touhidsiddiqueeraj-bit/artemis-helios/README.md

# Helios-Artemis

A photovoltaic (PV) system research project implementing a dual-microcontroller predictive Maximum Power Point Tracking (MPPT) controller
for solar energy optimization.

## Overview

This project presents the Helios-Artemis system, which partitions the MPPT problem into two planes:
- **Helios (ESP32-S3):** LSTM irradiance forecasting, local retraining, SD logging
- **Artemis (STM32F103):** real-time VS-P&O MPPT, 50 kHz PWM generation, battery management

Validated by a field logger deployed in Sylhet, Bangladesh, with the full study written up as an IJPEDS revision 
(manuscript `25195-52952-1-SM-REVISED`).

## Manuscript deliverables (current)

| File | Description |
|---|---|
| `25195-52952-1-SM-REVISED.docx` | Current revision, submitted to IJPEDS (reviewer items addressed) |
| `25195-52952-1-SM-REVISED.pdf` | PDF export of the current revision |
| `response_letter.md` | Point-by-point response to the reviewer report |
| `backups/` | Superseded revisions (BAK3–BAK12), earlier revision scripts, original submission |

## Project Structure

```
artemis-helios/
├── Code/
│   ├── MatLab/                     # MATLAB simulation & analysis scripts (Simulink model, controllers)
│   ├── Python/                     # Python scripts
│   │   ├── gen_figures_hires.py    # Regenerates all 9 publication figures (fig1()–fig9())
│   │   ├── graphical_abstract.py
│   │   ├── figures/                # Generated high-resolution figures
│   │   └── documentation/
│   └── ...
├── Docs/
│   ├── Presentation/               # Project presentations
│   ├── Study_materials/            # Study guides & primers
│   └── Upload_package/             # IJPEDS submission package (manuscript, cover letter, reviewers)
├── Figures/
│   └── figures_python/             # Per-figure scripts (FIG1–FIG9) & outputs
├── Tables/                         # CSV data tables
├── Logger_Data/                    # Field logger recordings & cleaned validation data
├── Helios_Logger/                  # Logger firmware
├── prototype/
│   ├── Code/                       # Firmware (STM32 & ESP32-S3)
│   ├── Guide/                      # Schematics, PCB, layout guide
│   └── schematics/                 # KiCad design files
├── backups/                        # Superseded revisions & scripts (working files stay at root)
└── README.md
```

## Figures

Generated by `Code/Python/gen_figures_hires.py`:

1. **fig1_architecture** - System architecture (dual-MCU: Helios + Artemis)
2. **fig2_irradiance** - Sylhet Markov-chain + OU irradiance model
3. **fig3_iv_curves** - PV I–V / P–V characteristics
4. **fig4_lstm** - LSTM predictor performance (R², MAE, residuals, α sensitivity)
5. **fig5_simulation** - Full-day Simulink simulation (6 panels)
6. **fig6_comparison** - Controller efficiency comparison + Monte Carlo
7. **fig7_po_convergence** - VS-P&O convergence analysis
8. **fig8_cost** - BOM breakdown and cost comparison (manuscript Fig. 10)
9. **fig9_validation** - Field-logger ramp-rate validation

Plus `graphical_abstract.py` for the graphical abstract. The manuscript embeds these as 11 figures (including the GitHub-repo QR code).

## Requirements

- Python 3.x
- NumPy, Matplotlib, SciPy (`requirements.txt`)

## Running

Generate all figures:
```bash
python3 Code/Python/gen_figures_hires.py
```

## Authors

- **Hussain Touhid Siddiquee** — conceptualization, methodology, software, writing
- **Orpon Chanda** — hardware validation and field deployment

Department of Electrical & Electronic Engineering, Leading University, Sylhet, Bangladesh

## License

MIT License
