touhidsiddiqueeraj-bit/artemis-helios/PASTE_PLAN.md

> [!note]
> [!note]1,C and E are empty, text size in figure 1 is too small, the references are not serialized and are random, figure 10 has a headline of fig8 embedded in the image, and the text itseld is too small to be readable, it also doesnt include the assembly fee,author biography section is empty, remove. Orpon Chanda received the B.Sc. degree in Electrical and
Electronic Engineering from Shahjalal University of Science
and Technology (SUST), Sylhet, Bangladesh. His research
interests include solar energy systems, data acquisition and
logging for photovoltaic field deployment, and sensor
integration for renewable energy monitoring. He contributed
to the field data collection campaign and hardware
deployment of the irradiance logger used in this study.
Hussain Touhid Siddiquee received the B.Sc. degree in
Electrical and Electronic Engineering from Shahjalal
University of Science and Technology (SUST), Sylhet,
Bangladesh. His research interests include embedded systems
for renewable energy, machine learning on edge devices, and
predictive MPPT control for photovoltaic systems. He is the
lead developer of the Helios-Artemis dual-MCU predictive
MPPT controller and the ARTEMIS LSTM irradiance
simulation framework.  this section is completely fabricated, remove, The authors thank the Infrastructure Development Company
Limited (IDCOL) for providing contextual data on SHS
deployment specifications. The field data collection campaign
was conducted with logistical support from the Department of
Electrical and Electronic Engineering, Shahjalal University of
Science and Technology, Sylhet. thisline is wrong, support was provided by leading university sylhet, not SUST, add 250 taka assembly charge to the total cost of the device, the paper has inconcsistent use of fonts and font sizs, follow ijpeds style formatting, Author Contributions Statement
Conceptualisation, H.T.S. and O.C.; methodology, H.T.S. and
O.C.; software, H.T.S.; validation, H.T.S. and O.C.; formal
analysis, H.T.S.; investigation, H.T.S. and O.C.; resources,
H.T.S.; data curation, O.C.; writing—original draft
preparation, H.T.S.; writing—review and editing, H.T.S. and
O.C.; supervision, H.T.S.; project administration, H.T.S  this section is wrong, credit OC for hardware deployment, credit HTS for everything else
