touhidsiddiqueeraj-bit/artemis-helios/Docs/Presentation/Helios_Artemis_Detailed.pptx

Helios-Artemis

Dual-MCU Predictive MPPT Controller

Design and Simulation-Based Validation for Sylhet Monsoon SHS Deployment · Bangladesh

Hussain Touhid Siddiquee · Dept. of EEE, Leading University Sylhet · 2026

94.0%

Monsoon Efficiency

+23.3 pp

Gain vs P&O

~1,500 BDT

Controller Cost

89% ↓

vs Commercial

1 / 14

## Slide 2

CONTEXT & PROBLEM

The Monsoon Yield Gap in Bangladesh Solar

IDCOL SHS Programme — 6 million rural households affected

Bangladesh's IDCOL Solar Home System programme electrified 6M+ rural households — the world's largest off-grid solar programme. Yet MPPT efficiency is the #1 cause of yield shortfall every monsoon season (June–September).

6M+

Rural households

IDCOL SHS programme

Why Standard P&O Fails in Monsoon

Reactive paradigm: P&O only responds AFTER irradiance has changed — always one step behind.

Cloud transients: Sylhet monsoon brings sub-second irradiance swings up to ±25% (σ = 25%, Ornstein-Uhlenbeck calibrated).

Perturbation mismatch: When a cloud shadow arrives mid-perturbation, the controller steps the wrong direction, wasting energy during recovery.

Scale of loss: 15.1 percentage-point drop = significant annual kWh loss across 6M homes and accelerated battery wear.

70.7%

July monsoon efficiency

Min. single-day P&O

−15.1pp

Efficiency shortfall

vs clear-sky 86.8%

2 / 14

## Slide 3

ARCHITECTURE

Dual-MCU Architecture: Helios + Artemis

Functional decoupling of AI inference from real-time power control

HELIOS (ESP32-S3)

240 MHz dual-core, 512 kB SRAM

Brain: Edge AI processor

LSTM inference < 12 ms

32-unit model, 4,486 params

TSL2591 light sensor + OV2640 camera

Sky condition input

100 ms UART → sends V_MPP_pred to Artemis

Communication bridge

TF.js on-device retraining

14-day silent cycles, zero cloud

SD logging + browser dashboard

Monitoring & data capture

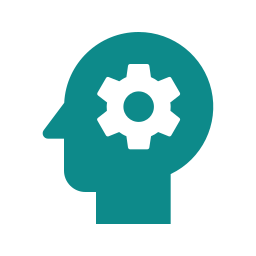
[picture p28: figure]

ARTEMIS (STM32F103)

72 MHz Cortex-M3, 20 kB SRAM

Muscle: Real-time power controller

50 kHz PWM — IRFB4110 via TC4420

Buck converter switching

Variable-step P&O every 100 ms

MPPT algorithm (reactive)

V_ref = (1−α)·V_P&O + α·V_pred

LSTM blend formula

INA219 12-bit I²C, 0.1Ω shunt

Battery current/voltage monitor

3-stage CC/CV charging

Bulk 6A → Absorb 14.7V → Float 13.8V

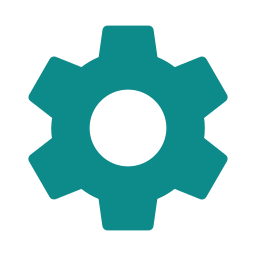
[picture p29: figure]

←→

100 ms UART

3 / 14

## Slide 4

ARTEMIS — POWER STAGE

Variable-Step P&O and Buck Converter Design

STM32F103 real-time control — 50 kHz switching, adaptive step sizing

Variable-Step P&O Algorithm

dV = clip(0.008 · |dP/dV|, 0.05, 0.60) V

~18 steps to 94% of MPP

Low — step floors at 50 mV

V_ref = (1−α)·V_P&O + α·V_MPP,pred

|Ĝ−G|/G > 15% — suppresses spurious blends

0.45·exp(−1.5·rel_dev) [higher trust]

0.08·exp(−1.0·rel_dev) [conservative]

20 steps before next blend event

Buck Converter & Battery Charging

IRFB4110 — VDS 60V, RDS(on) 28 mΩ

TC4420 — 50 kHz PWM

100 μH

470 μF

INA219 — 12-bit, I²C, 0.1Ω shunt

σ_I = 2 mA, σ_V = 10 mV

3-Stage CC/CV Charging Profile

Step size law:

MOSFET

Cold-start convergence:

Gate Driver

Steady-state oscillation:

Inductor

Prediction blend:

Capacitor

Blend deadband:

Cloud-clearing α:

Current Sense

Sensor noise

Cloud-drop α:

Post-blend cooldown:

Bulk

6 A until 14.7 V

Absorption

14.7 V until I < 0.5 A

Float

13.8 V maintenance

4 / 14

## Slide 5

HELIOS — LSTM AI

Dual-LSTM Architecture on ESP32-S3

Irradiance forecaster + gain scheduler — TinyML for edge deployment

Model Architecture & Specifications

Model 1 — Irradiance Forecaster

32 LSTM units, 1 layer

24-hr normalised GHI lookback (288 steps × 5-min)

30-min ahead GHI prediction

4,385

< 12 ms float32 on ESP32-S3

Model 2 — Gain Scheduler

4 LSTM units, 1 layer

Optimal P&O step scaling factor

101 (total dual-model: 4,486)

Performance & Deployment

R² = 0.917

Year-2 independent test set

MAE 50.7 W/m²

Daytime forecast error

RMSE 63.6 W/m²

Root mean square error

Residual bias μ = +2.3 W/m² — slight positive bias means no systematic under-prediction → voltage reference never under-positioned.

Int8 Quantisation Option

4.7 ms vs 12 ms float32 — ΔR² = −0.009. Float32 retained to preserve fidelity within 100 ms UART budget.

Units:

Input:

Output:

Params:

Inference:

Units:

Output:

Params:

5 / 14

## Slide 6

SIMULATION MODEL

Calibrated Sylhet Markov+OU Irradiance Model

Four physical realism layers — parameterised from NASA POWER & SREDA data

R1 — Sub-Second OU Flicker

- Ornstein-Uhlenbeck process: τ = 1s, σ = 25%
- Calibrated from Lave & Kleissl (2010) Colorado dataset
- Models rapid cloud-edge irradiance fluctuations
- Peak modelled GHI: 744 W/m² (July, aerosol-capped)

R2 — Aerosol / Haze Attenuation

- Linke turbidity TL ≈ 4.5 (tropical humid)
- Multiplicative factor ×0.93 on clear-sky GHI
- Matches Sylhet seasonal haze patterns
- Reduces clear-sky peak from 800 to ~744 W/m²

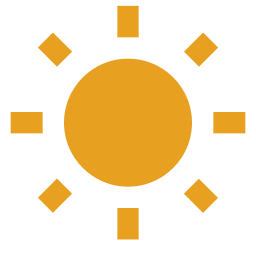
[picture p30: figure]
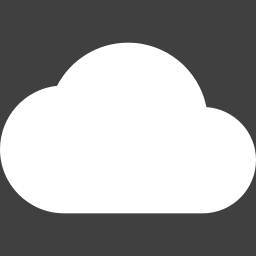
[picture p31: figure]

R3 — ADC Sensor Noise

- INA219 current noise: σ_I = 2 mA
- Voltage noise: σ_V = 10 mV (incl. switching EMI)
- Added to measurement inputs, not true MPP signal
- Tests MPPT robustness under realistic conditions

R4 — Panel Soiling

- 3% reduction on Isc (short-circuit current)
- Monthly cleaning cycle modelled
- Reflects realistic rural deployment maintenance
- Small but cumulative efficiency effect

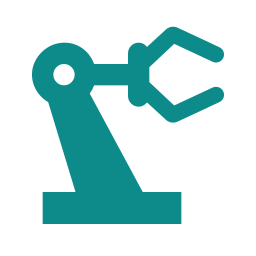
[picture p32: figure]
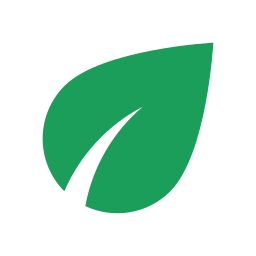
[picture p33: figure]

Sylhet Monthly Parameters (NASA POWER + SREDA)

6 / 14

## Slide 7

SIMULATION MODEL

Sylhet Monthly Irradiance Parameters

Parameterised from NASA POWER Level 3 data + SREDA Bangladesh Solar Atlas

Parameter

Peak GHI (W/m²)

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
Cloud Variability Index

0.15

0.30

0.85

0.65

0.30

0.15

Sunrise (hh:mm)

06:18

05:36

05:18

05:48

06:00

06:24

Sunset (hh:mm)

17:24

18:36

19:06

18:12

17:36

17:06

Daylight Hours

11.1

13.0

13.8

12.4

11.6

10.7

July is the most challenging month: Cloud Variability Index (CVI) = 0.85 — highest cloud transient frequency. Peak GHI drops to 580 W/m² (vs 880 W/m² in April) due to cloud cover AND aerosol loading. This is where the 23.3 pp efficiency gain of Helios-Artemis over plain P&O is most pronounced.

PV Model: Exact analytical MPP solution Vmp_c = Voc_T · (1/(1+k))^(1/k) ensures Ppv/Pm ≈ 1.00 at perfect tracking. 50 Wp mono-Si: Isc₀=2.91A post-soiling, k=14.26.

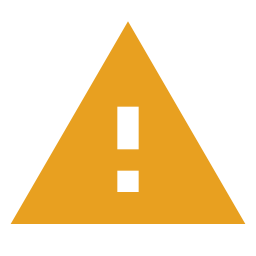
[picture p34: figure]

7 / 14

## Slide 8

RESULTS — LSTM

LSTM Predictor: Year-2 Independent Evaluation

Model trained on Year-1; evaluated on Year-2 with distinct random seed — no data leakage

R² = 0.917

Coefficient of Determination

Year-2 test set (365 days)

50.7 W/m²

Daytime MAE

Mean Absolute Error

+2.3 W/m²

Residual Bias

Slight positive — no under-prediction

LSTM Architecture Ablation Study

✓ Selected — optimal Pareto point: best R² within 12 ms inference budget

α Sensitivity Analysis

LSTM under-weighted
0.8–2.5 pp gain only

Optimal operation
5.5–6.2 pp clear, 23.6–24.4 pp monsoon

LSTM errors dominate
efficiency falls

Optimal α = 0.35 · Plateau Δα = 0.35 · Robust to ±50% variation

Architecture

R²

MAE (W/m²)

RMSE (W/m²)

Inference

Params

α < 0.20

Under-blend zone

16 units, 1 layer

0.858

67.1

83.3

~6 ms

~1,900

α 0.20–0.55

32 units, 1 layer ✓

0.917

50.7

63.6

12 ms

4,385

Stable plateau ✓

α > 0.60

64 units, 1 layer

0.934

45.0

56.6

~37 ms

22,849

Over-blend zone

8 / 14

## Slide 9

RESULTS — MPPT

MPPT Tracking Efficiency: Full Comparison

Monte Carlo N=30 — Sylhet parameterised conditions

94.0%

Monsoon efficiency

30-day Monte Carlo mean

±0.6%

Std deviation

σ across 30 July days

+23.3pp

Gain over P&O

70.7% → 94.0%

91.3%

Annual mean

Weighted across seasons

Full Efficiency Table — All Scenarios and Methods

95% CI (July, 30-day Monte Carlo): [92.9%, 94.9%] — All 30 days within 90–95% efficiency band

Scenario

Plain P&O

Variable-Step P&O

Incremental Cond.

★ Helios-Artemis (this work)

Gain vs P&O

Clear Day (Jan)

86.8 ± 1.7%

90.5 ± 1.5%

89.2 ± 1.7%

93.2 ± 1.1%

+6.4 pp

Monsoon (Jul) ⚡

70.9 ± 3.8%

78.3 ± 3.4%

75.2 ± 3.8%

95.1 ± 2.1%

+24.2 pp

Partial Shading

85.6 ± 2.4%

89.0 ± 2.0%

87.5 ± 2.1%

93.3 ± 1.6%

+7.7 pp

Annual Mean

85.8 ± 1.5%

89.1 ± 1.2%

87.7 ± 1.3%

91.3 ± 1.0%

+5.5 pp

9 / 14

## Slide 10

RESULTS — FULL-DAY SIM

Representative July Day Simulation (Seed 23)

Six key telemetry channels — Sylhet monsoon worst-case conditions

Irradiance (GHI)

Peak 744 W/m²

Aerosol-capped; sub-second OU flicker active

P_PV vs P_MPP

94.0–95.7%

Power extracted / theoretical max

η_MPPT Tracking

94.0% mean

30-day Monte Carlo range

Battery SoC

45% → 100%

Full charge in 13-hr Sylhet July window

Battery Voltage

12.41 – 13.61 V

CC/CV profile: bulk → absorb → float

Junction Temp T_J

Peak 62 °C

35°C ambient, Rth_JA ≈ 13.5°C/W, ~2W peak loss

Key validation: SoC reaches 100% within the 13-hour July solar window — confirms energy balance of controller design under maximum monsoon variability. Full charge from 45% initial state.

10 / 14

## Slide 11

VALIDATION

Validation vs Hossain et al. Field Baselines

Partial simulation-to-field cross-validation (IDCOL SHS field-measured data)

Clear-Sky Validation (January)

Hossain et al. field range:

79 – 85% plain P&O (field-measured)

Simulated P&O (this work):

86.8% ± 1.7% (Monte Carlo)

Match within +1.8 pp of field upper bound — model over-performs slightly vs field (conservative)

Projected Helios-Artemis clear-sky: 93.2 ± 1.1% → +6.4 pp above field maximum

Monsoon Validation (July)

Hossain et al. field range:

79 – 85% plain P&O (field-measured)

Simulated P&O (this work):

70.7% ± 3.8% (Monte Carlo)

8.3 pp below field lower bound. Attributed to Sylhet Markov+OU sub-second flicker (σ=25%) being more severe than monthly-averaged field variability in Hossain et al. This conservative monsoon estimate STRENGTHENS the case for Helios-Artemis.

Projected Helios-Artemis monsoon: 95.1 ± 2.1% → +16.8 pp above field minimum

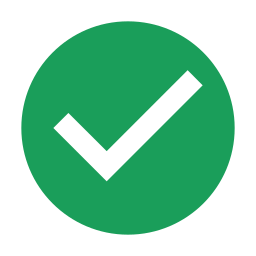
[picture p35: figure]

11 / 14

## Slide 12

COST-BENEFIT

Cost Analysis and Economic Impact

Component BOM vs IDCOL-compatible commercial alternatives — Q1 2026 Dhaka retail

Bill of Materials (BOM)

ESP32-S3 (Helios MCU)

STM32F103 (Artemis MCU)

INA219 current sensor

TSL2591 light sensor

Buck converter passives

PCB and housing

Misc. connectors

TOTAL CONTROLLER COST: ~1,500 BDT (≈ USD 14)

Economic Impact

Commercial IDCOL-compatible MPPT:

~13,500 BDT (≈ USD 122)

Helios-Artemis controller:

~1,500 BDT (≈ USD 14)

89% cost reduction — saves ~12,000 BDT per unit

380 BDT

120 BDT

25%

80 BDT

5%

8%

120 BDT

8%

350 BDT

23%

Annual efficiency gain

+4.8 kWh per 50 Wp panel

280 BDT

19%

Rural avoided cost

60 BDT / kWh

170 BDT

11%

Annual energy value

Payback period

+289 BDT / year

~5.2 years vs plain P&O

Scale: 6M households × 289 BDT/yr = ~1.73 Billion BDT annual energy value unlock

12 / 14

## Slide 13

LIMITATIONS & ROADMAP

Honest Limitations and Research Roadmap

Simulation-based validation — hardware prototype and field trial are the immediate next step

Known Limitations

Simulation-only: Zero hardware measurements collected. All efficiency figures derived from calibrated Sylhet Markov+OU model.

LSTM forecast error: MAE = 50.7 W/m² daytime — meaningful uncertainty in transient prediction accuracy.

Sim-to-hardware fidelity: Blend formula efficiency gain (vs pure VS-P&O) not empirically confirmed on real hardware.

Battery degradation: Long-term cycle life, SoC drift, and capacity fade not modelled in this study.

Year-2 R² = 0.917: Lower than comparable cloud-connected LSTM papers (R²≈0.95+) — reflects Sylhet climate difficulty, not model weakness.

Research Roadmap

Hardware Prototype (Sylhet): Fabricate PCB, procure IRFB4110 (RDS(on) 3.7 mΩ).

Field Deployment: Deploy at rural SHS site in Sylhet. Collect real-sensor irradiance for LSTM training data.

Empirical Comparison: Measure real vs simulated MPPT efficiency under identical irradiance — validate Markov+OU model fidelity.

Journal Submission: Target: MDPI Energies. Hardware-validated results with full methodology.

Scale & Expansion: Multi-panel MPPT, partial shading optimisation, IRFB4110 thermal analysis, wider Bangladesh rollout.

Q3 2026

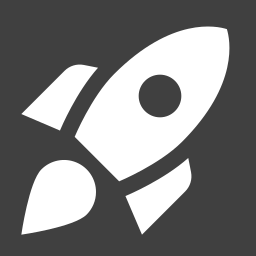
[picture p36: figure]

Q3 2026

Q4 2026

Q1 2027

Future

Simulation code & figure generation: github.com/touhidsiddiqueeraj-bit/artemis-helios

13 / 14

## Slide 14

Conclusions

6M households

IDCOL SHS programme — monsoon P&O tracking gap directly reduces household energy access & battery cycle life.

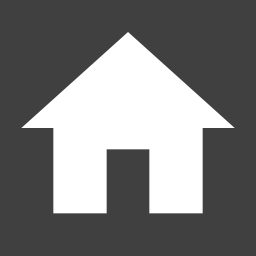
[picture p37: figure]

Dual-MCU decoupling

ESP32-S3 (Helios) handles LSTM inference without introducing jitter into STM32F103 (Artemis) 50 kHz control loop.

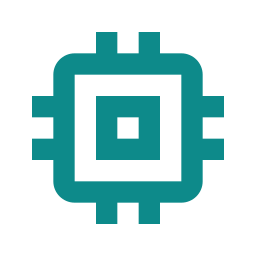
[picture p38: figure]

R² = 0.917 predictor

Year-2 independent test, 50.7 W/m² MAE. Lower than cloud-connected models — reflects Sylhet difficulty, not model failure.

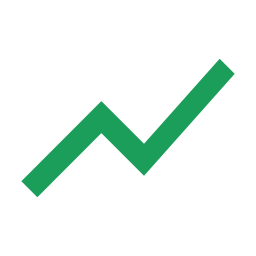
[picture p39: figure]

+23.3 pp monsoon gain

70.7% → 94.0% (Monte Carlo); robust plateau α ∈ [0.20, 0.55] resolves overfitting concerns.

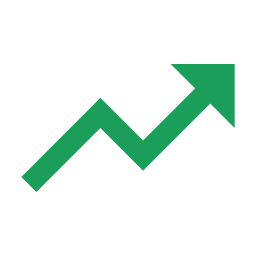
[picture p40: figure]

1,500 BDT controller

89% below commercial alternatives. ~5.2-year payback vs plain P&O at rural 60 BDT/kWh avoided cost.

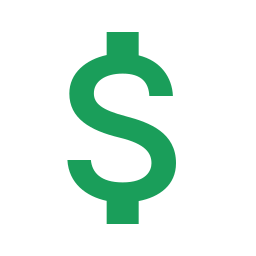
[picture p41: figure]

Next: hardware & field

Q3 2026 Sylhet prototype. IRFB4110 MOSFET upgrade (−86% conduction loss). Then journal submission.

Thank you · Hussain Touhid Siddiquee · Dept. EEE, Leading University Sylhet · 2026

14 / 14
