touhidsiddiqueeraj-bit/artemis-helios/Docs/Presentation/Helios_Artemis_Presentation_ABasic.pptx

Helios-Artemis

A Smarter Solar Controller for Rural Bangladesh

Hussain Touhid Siddiquee · Dept. EEE, Leading University Sylhet · 2026

1 / 10

## Slide 2

The Problem: Solar Power Wasted in Bangladesh Monsoon

6M+

rural households
have IDCOL solar panels

−15%

efficiency loss
during monsoon season

70.7%

actual tracking
efficiency in July storms

Why does this happen?

Solar panels have a 'sweet spot' voltage for maximum power. The standard controller (Perturb-and-Observe) finds this spot by trial-and-error — tiny voltage nudges back and forth. During clear weather this works fine. But during monsoon, clouds pass rapidly and the sweet spot keeps jumping. The controller is always reacting to the last cloud instead of anticipating the next one — so it wastes power.

2 / 10

## Slide 3

The Idea: Predict, Then Act

Old Way — React

☁ Cloud passes over panel
⚡ Power drops suddenly
🔁 Controller trial-and-errors its way back
⏱ Power wasted during recovery (can take seconds)

Helios-Artemis — Predict

📡 Sensor reads current sky conditions
🧠 AI forecasts irradiance 30 min ahead
⚙️ Controller pre-adjusts voltage reference
✅ When cloud arrives — already at the right setting

VS

3 / 10

## Slide 4

How It's Built: Two Chips, One Controller

🧠 HELIOS (ESP32-S3 chip)

THE BRAIN: Runs AI prediction

Looks at sky: Light sensor + camera

Forecasts irradiance: 30 minutes ahead

Updates every 100 ms: Sends voltage target to Artemis

Self-retrains: On-device, no internet needed

⚙️ ARTEMIS (STM32 chip)

THE MUSCLE: Handles real power control

Switches 50,000×/sec: Pulses current to extract power

Charges battery: 3-stage: bulk → absorb → float

Blends AI + logic: (1−α)×P&O + α×prediction

Real-time only: No AI inference here — no jitter

100 ms
UART

4 / 10

## Slide 5

The AI Component: What the LSTM Actually Does

Long Short-Term Memory (LSTM)

- A type of neural network that learns patterns in sequences over time
- Like how you can tell a storm is coming from an hour of darkening sky — not just the last second
- Trained on 1 year of synthetic Sylhet irradiance data
- Predicts irradiance 30 minutes ahead with R²=0.917
- Only 4,486 parameters — tiny enough to run on a microchip in under 12 milliseconds
- Retrains itself every 14 days using the controller's own logged data

MODEL SPECS

Architecture

32-unit LSTM, 1 layer

Input

24 hours of irradiance history

Output

Parameters

Predicted GHI in 30 minutes

4,486 total

Accuracy (R²)

0.917

Error (MAE)

50.7 W/m² daytime

Inference time

< 12 ms on the ESP32-S3

Retraining

Every 14 days, no internet

5 / 10

## Slide 6

Testing Method: Why Simulation?

Why simulate first?

- Building hardware in Sylhet takes months (PCB fab, procurement, field site)
- Simulation allows testing 30+ different days, 200 Monte Carlo runs, dozens of parameter sweeps — impossible and expensive in hardware
- The simulation is built from NASA and SREDA real climate data for Sylhet — not arbitrary values

How realistic is the simulation?

- Cloud patterns from real Sylhet climate records (NASA POWER + SREDA)
- Sub-second cloud flicker modelled mathematically (calibrated from peer-reviewed measurements)
- Includes dust on panels, sensor noise, haze — not ideal clean conditions
- Simulated P&O efficiency (86.8%) matches field data from Hossain et al. within 1.8%

The simulation is more severe than real field conditions — so the performance gains reported are a conservative lower bound.

6 / 10

## Slide 7

Key Results

30-day Monte Carlo simulation — Sylhet July monsoon conditions

94.0%

Efficiency
(Helios-Artemis)

+23.3 pp

Gain over
standard P&O

0.917

AI forecast
accuracy (R²)

1,500 BDT

Controller cost
(USD ~14)

Method | Clear Sky | Monsoon | Annual Mean
Standard P&O | 86.8% | 70.9% | 85.8%
Variable-Step P&O | 90.5% | 78.3% | 89.1%
Incremental Cond. | 89.2% | 75.2% | 87.7%
★ Helios-Artemis | 93.2% | 95.1% | 91.3%

7 / 10

## Slide 8

Cost & Real-World Impact

Cost Comparison

89% cheaper than commercial alternatives

~6 Million

households could benefit from this upgrade

+4.8 kWh/yr

extra energy per 50W panel

5.2 years

payback period (vs plain P&O baseline)

Zero internet

required — fully offline operation

8 / 10

## Slide 9

Honest Limitations & Next Steps

⚠ Current Limitations

- All results come from simulation — no real hardware built yet
- The AI's 30-min forecast has a margin of error (~50 W/m²)
- Simulation is conservative but not validated with real Sylhet sensors
- Battery degradation and long-term reliability not yet modelled

✅ Immediate Next Steps

Build hardware prototype in Sylhet

Compare simulated vs real efficiency under identical conditions

IRFB4110 MOSFET (86% less heat loss)

MDPI Energies, after hardware validation

Q3 2026

Field test

MOSFET upgrade

Journal sub.

9 / 10

## Slide 10

In Summary

6M+ Bangladeshi rural homes lose 15% of solar energy every monsoon because standard controllers can't keep up with fast-moving clouds.

The Problem

Helios-Artemis uses a small AI (LSTM) on an ESP32 chip to predict irradiance 30 min ahead, letting the controller pre-adjust instead of react.

The Solution

Monsoon efficiency improves from 70.7% to 94.0% — a +23.3 pp gain. Controller costs ~1,500 BDT, 89% below commercial alternatives.

The Results

These are simulation results. Hardware prototype and field trial in Sylhet is the confirmed next step (Q3 2026).

Thank you · Questions welcome

The Limit

10 / 10
