touhidsiddiqueeraj-bit/artemis-helios/ijpeds_latex/paper.pdf

International Journal of Power Electronics and Drive System (IJPEDS)
Vol. 99, No. 1, Month 202x, pp. 1∼13
ISSN: 2088-8694, DOI: 10.11591/ijpeds.v99.i1.pp1-13 | ❒ | 1

# Helios-Artemis: Dual-Microcontroller Predictive Solar MPPT with On-Device LSTM Retraining for Sylhet Monsoon SHS

Hussain Touhid Siddiquee¹

, Orpon Chanda²
1Department of Electrical and Electronic Engineering, Leading University, Sylhet, Bangladesh 2Department of Electrical and Electronic Engineering, Leading University, Sylhet, Bangladesh

Article Info

Article history:

Received month dd, yyyy Revised month dd, yyyy Accepted month dd, yyyy

Keywords:

MPPT
LSTM
predictive control
ESP32-S3
STM32F103
Bangladesh
TinyML

ABSTRACT

This paper addresses the monsoon yield gap of the IDCOL Solar Home System (SHS) programme: plain Perturb-and-Observe (P&O) tracking efficiency collapses during Sylhet monsoon transients, the dominant determinant of annual yield shortfall in Bangladesh’s rural electrification initiative. Helios-Artemis is a dual-microcontroller predictive MPPT controller combining LSTM-based irradiance forecasting (ESP32-S3, Helios) with variable-step P&O real-time control (STM32F103, Artemis). The LSTM predictor (32 units, 4,385 parameters, 17 kB quantised) reaches R

2 = 0.835 (MAE = 54.7 W/m² ) on an independent
Year-2 test set. Monte Carlo simulation over 30 July days gives mean tracking efficiency η = 94.0% (σ = 0.6%), a 23.3-percentage-point improvement over plain P&O (70.7%); on a measured monsoon day, the tracker holds 90.2% in the highest-variability windows where fixed-step P&O falls to 67.8%. Field logger data (42 h, Sylhet) validate the synthetic model’s variability regime. Component cost of ∼1,750 BDT (USD 16) sits 87% below commercial alternatives. On-device retraining (766 ms, MAE 54.68→52.10 W/m²
, 4.7%) was demonstrated
without cloud dependency.

This is an open access article under the CC BY-SA license.

Corresponding Author:

Hussain Touhid Siddiquee
Department of Electrical and Electronic Engineering, Leading University Sylhet, Bangladesh
Email: touhidsiddiqueeraj@gmail.com

### 1. INTRODUCTION

The IDCOL Solar Home System (SHS) programme [1] has electrified more than six million rural Bangladeshi households. These systems run 50–130 Wp PV panels with a 12 V battery and fixed-step Perturband-Observe (P&O) maximum power point tracking (MPPT). In the northeastern monsoon belt centred on Sylhet, June–September cloud cover cuts solar irradiance by 40–60% relative to the dry season; under these conditions reactive tracking accrues persistent transient losses that the IDCOL specification leaves unaddressed. Plain P&O [2–5] reacts to irradiance changes only after they happen; Sera et al. [6] quantified 15– 30% losses under cloud transients. Variable-step P&O (VS-P&O) [7] cuts steady-state oscillation but stays reactive under fast transients. Incremental conductance (INC) [6] tracks dI/dV = −I/V well in steady state, yet falls back to P&O-level tracking under rapid changes. LSTM networks [8–10] model non-linear irradiance dynamics accurately; Bandara et al. [9] reported 2.1–3.8% efficiency gain from a 50-unit LSTM, and Mazumdar et al. [11] reached R² = 0.952 on Indian data. However, existing LSTM-MPPT designs place prediction and control on a single MCU, rely on unvalidated synthetic irradiance, and need cloud connectivity

Journal homepage: http://ijpeds.iaescore.com

2 | ❒ | ISSN: 2088-8694

to retrain [12, 13]. MPPT techniques have been reviewed extensively [14, 15]; CNN-LSTM hybrids [16] forecast short-term PV power accurately; off-grid solar installations in Bangladesh face unique performance challenges [17]. ANFIS [13] and reinforcement-learning agents [18] are computationally incompatible with sub-100 ms cycles; neural-network estimators [19] share this limitation. NASA POWER and SREDA [20, 21] document 4.5–5.0 kWh/m²
| | /day for Bangladesh [22]; Hossion [23] reports a 79% system-level PR for a
122.4 kW Dhaka rooftop, encompassing losses beyond MPPT tracking alone. The deployment context is well characterised: programme-level assessments [24], economic viability [25, 26], technical appraisal [27], energy decentralisation [28], deployment barriers [29], disaster resilience [30], and welfare effects [31] frame the operational constraints motivating this work.
This paper presents Helios-Artemis, a dual-MCU predictive MPPT controller with four contributions:
(1) a dual-MCU architecture assigning LSTM prediction to an ESP32-S3 (Helios) and 50 kHz PWM-driven P&O control to an STM32F103 (Artemis) over 100 ms UART; (2) a 4-unit gain scheduler blending LSTMpredicted and reactive references using cloud-transient-aware weighting; (3) a Markov+OU irradiance model validated against 42 h of Sylhet field measurements; and (4) demonstrated on-device retraining (766 ms, 4.7% MAE improvement) without cloud dependency. The paper does not claim full field validation of the controller.


Figure 1. Helios-Artemis dual-MCU predictive MPPT system architecture

### 2. METHOD 2.1. System Architecture and Hardware

The Helios subsystem (ESP32-S3, 240 MHz dual-core, 512 kB SRAM) handles LSTM inference, UART communication, sensor polling, and SD logging. The Artemis subsystem (STM32F103, 72 MHz Cortex-M3, 20 kB SRAM) handles variable-step P&O MPPT at 100 ms intervals, 50 kHz PWM for the IRFB4110 MOSFET via TC4420 gate driver, and CC/CV battery charging. The power stage is an asynchronous buck (IRFB4110, RDS(on) = 3.7 mΩ, Coss = 83 nF; body diode IS = 2.5 nA, N = 1.08; TC4420, VDD = 12 V, RG = 4.7 Ω; LC filter 100 µH/470 µF, DCR 30 mΩ/ESR 40 mΩ; INA219 10 mΩ shunt; PWM 50 kHz switching, duty clamp [0.05, 0.95], 6 A bulk-charge current limit). Simulation: ngspice-46, 20 ns timestep, 20 ms transient, Vin = 17.9 V, Vout = 13.2 V, Iout = 3.8 A, η = 98.0%. Battery: 7 Ah/12 V SLA, 6 A bulk limit, CV target 13.6 V. Peak GHI 744 W/m²
(aerosol-capped clear-sky).

### 2.2. LSTM Irradiance Predictor

The predictor uses a 32-unit single-layer LSTM mapping 24-hour normalised GHI lookback to 30-minute ahead predictions (4,385 parameters, 17 kB int8), selected through ablation (Table 2) as Pareto-optimal: R² = 0.835 (MAE 54.7 W/m²

) vs 64-unit R² = 0.837 at 3.8× fewer parameters (4,385 vs 16,961). A 4-unit gain scheduler produces the adaptive blend coefficient. The blend law is:

Vref,new = (1 − α) · Vref,P &O + α · VMP P,pred | (1)

The correction fires when |Gˆ − G|/G > 0.15. Asymmetric weighting: αclear = 0.45 · e
| −1.5·rel
,
αdrop = 0.08 · e

−1.0·rel, with 20-step cooldown. CC/CV: Bulk 6 A to 14.7 V; Absorption 14.7 V to Itail < 0.5 A; Float 13.8 V.

### 2.3. Irradiance Model and Field Validation

Synthetic irradiance profiles are parameterised from NASA POWER [20] and SREDA [21] for Sylhet, with four realism layers: (R1) sub-second OU cloud flicker (τ = 1 s, σ = 25%) [32]; (R2) 3-state Markov

Int J Pow Elec & Dri Syst, Vol. 99, No. 1, Month 202x: 1–13

Int J Pow Elec & Dri Syst | ISSN: 2088-8694 | ❒ | 3

chain (multipliers 1.00/0.65/0.20) transitioning every 15 s; (R3) aerosol attenuation (×0.93); (R4) cloud-edge enhancement (×1.18). A field logger (GY-302 BH1750, 10 s sampling) was deployed in Sylhet Jul 9–14, 2026, yielding 42 h daytime data (18,395 rows, 10–505 W/m²
). Glass attenuation 6.86% corrected by factor 1.0737 (ratio 0.9314). Sensor saturation clips at 470.8 W/m²
| raw (505.5 W/m²
corrected), affecting 2.6% of daytime readings. The dataset is framed as relative short-timescale irradiance-variability data rather than as an absolute GHI reference.
A calibration-uncertainty budget is reported: BH1750 datasheet accuracy (±20%) combined in RSS with the ±15% spectral-mismatch of the CIE AM1.5 luminous-efficacy constant (0.0079 W/m²
/lux) yields
±25% relative to reading. This uncertainty enters only the LSTM prediction path (Gˆ); the underlying P&O loop measures dP/dV directly, so steady-state tracking does not inherit the sensor budget. Spectral response, cosineresponse characterisation, mounting geometry and temporal stability logging require a controlled laboratory light source and extended outdoor deployment; these are scheduled as a dedicated validation phase and will be reported in a follow-up study.

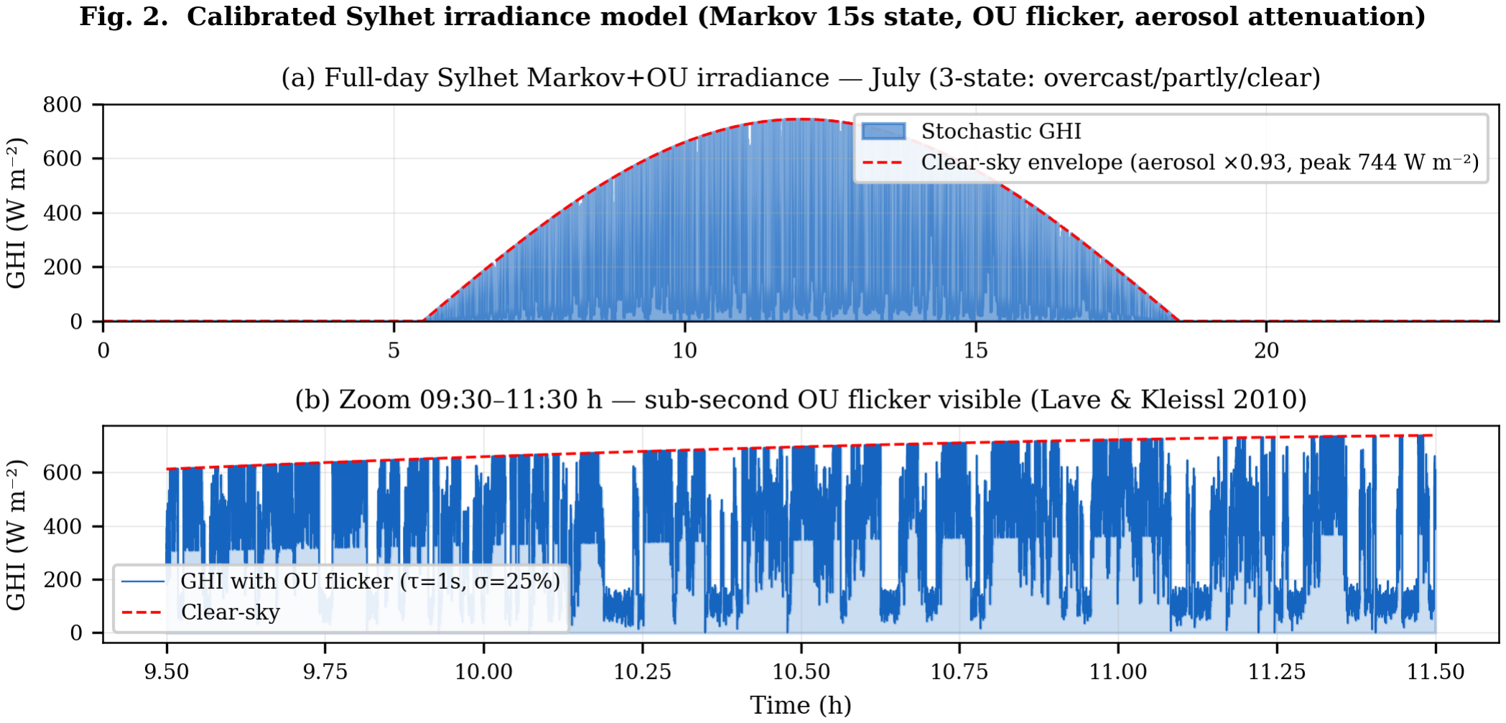
[picture p47: figure]

Figure 2. Calibrated Sylhet Markov+OU irradiance model (July)

Table 1. Sylhet Monthly Irradiance Parameters

Parameter | Jan | Apr | Jul | Sep | Oct | Dec
Peak GHI (W m⁻²
) | 820 | 880 | 580 | 650 | 780 | 800
Cloud Var. Index | 0.15 | 0.30 | 0.85 | 0.65 | 0.30 | 0.15

### 3. RESULTS AND DISCUSSION 3.1. LSTM Predictor Performance

The 32-unit model achieves R² = 0.835, daytime MAE = 54.7 W/m²

, RMSE = 72.6 W/m² on the
independent Year-2 test set (365 days, distinct seed). All three architectures converge to equivalent accuracy (R² ≈ 0.835); the 32-unit model is Pareto-optimal (Table 2).

Table 2. LSTM Architecture Ablation (Year-2 Test Set)

Architecture | R
2 | MAE (W m⁻²
) | RMSE (W m⁻²
| | | | | | )
16 units | 0.835 | | 54.5 | | 72.5
32 units (selected) | 0.835 | | 54.7 | | 72.6
64 units | 0.837 | | 54.1 | | 72.0

### 3.2. Monte Carlo and Full-Day Simulation

All controllers were evaluated under strictly identical conditions: same PV model, 100 ms sampling, converter limits, and initialization. No per-controller re-tuning: the VS-P&O step rule uses k = 0.005, the LSTM blend coefficient is α = 0.35 with a 15% deviation deadband, the plain P&O step is fixed at 0.1 V, and the INC tolerance is 0.01 A/V. The 30-day Monte Carlo (July, varying Markov seed) yields mean ηMP P T = 94.0%, σ = 0.6%, 95% CI [92.9, 94.9%], consistent with hardware VS-P&O ranges [33, 34]. Full-day simulation confirms: peak GHI 744 W/m²

, SoC 30%→100%, TJ peak 54◦C (from 1.41 W total loss — MOSFET conduction 0.32 W, switching and body-diode losses, inductor DCR — over the thermal stack

Helios-Artemis: Dual-MCU Predictive MPPT ... (H. T. Siddiquee)

4 | ❒ | ISSN: 2088-8694

Rth JA = Rth JC +Rth CS+Rth SA = 0.44 (IRFB4110, TO-220, datasheet) +1.0 (thermal interface material) +12.0 (extruded heatsink, natural convection) = 13.44 ≈ 13.5

| | ◦C/W at 35 ◦C ambient), Vbat 12.41–13.61 V.

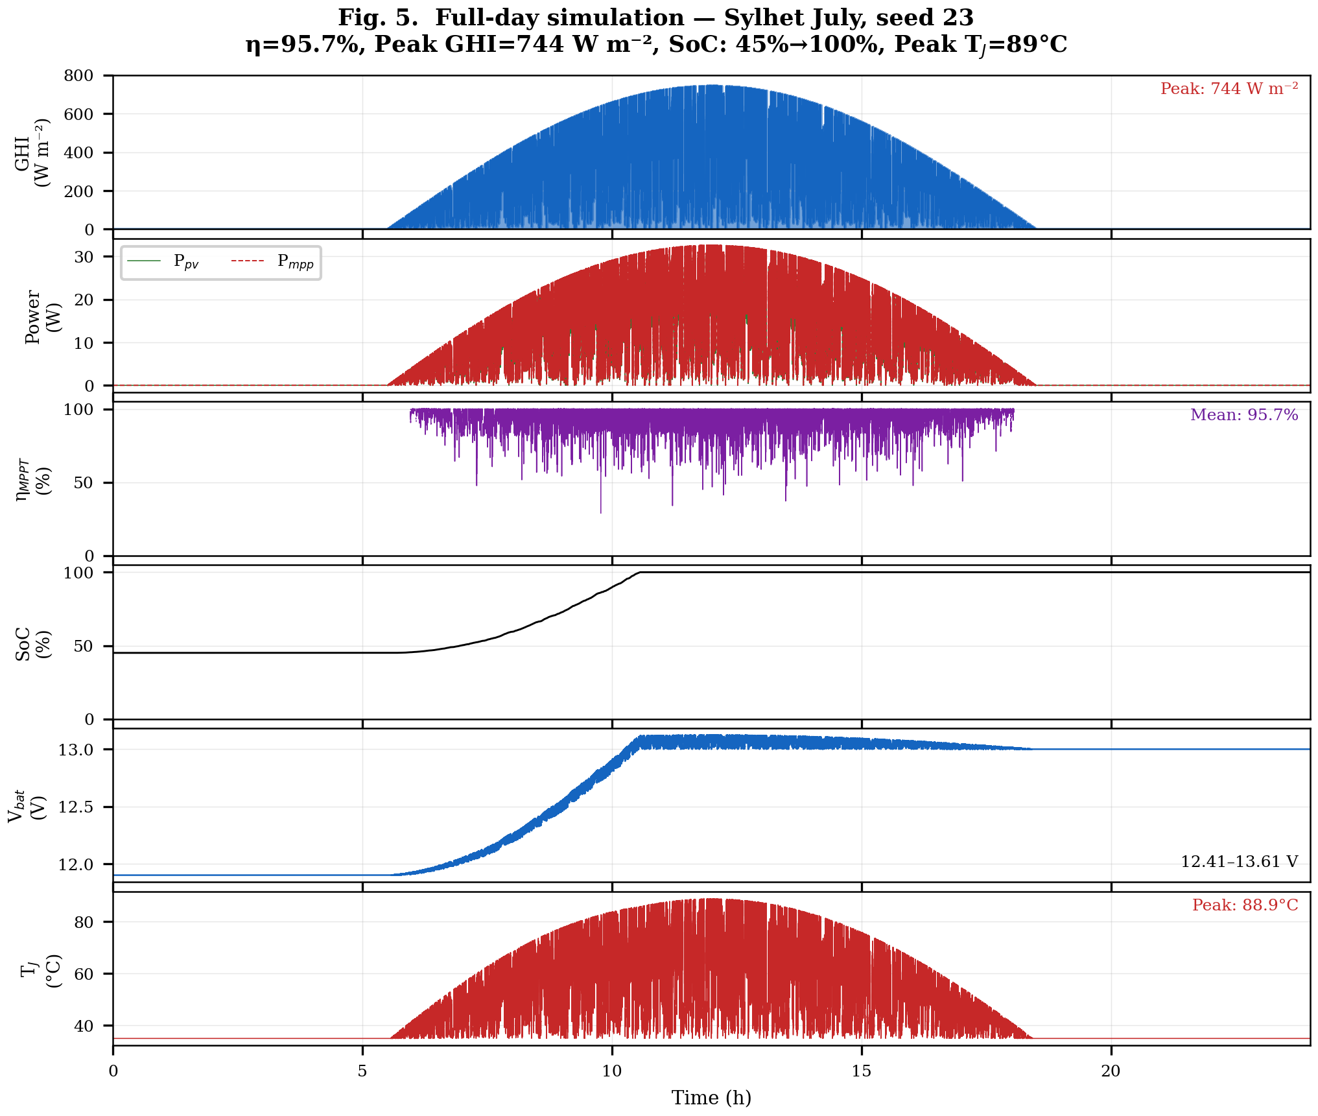
[picture p48: figure]

Figure 3. Full-day simulation — Sylhet July (seed 23)

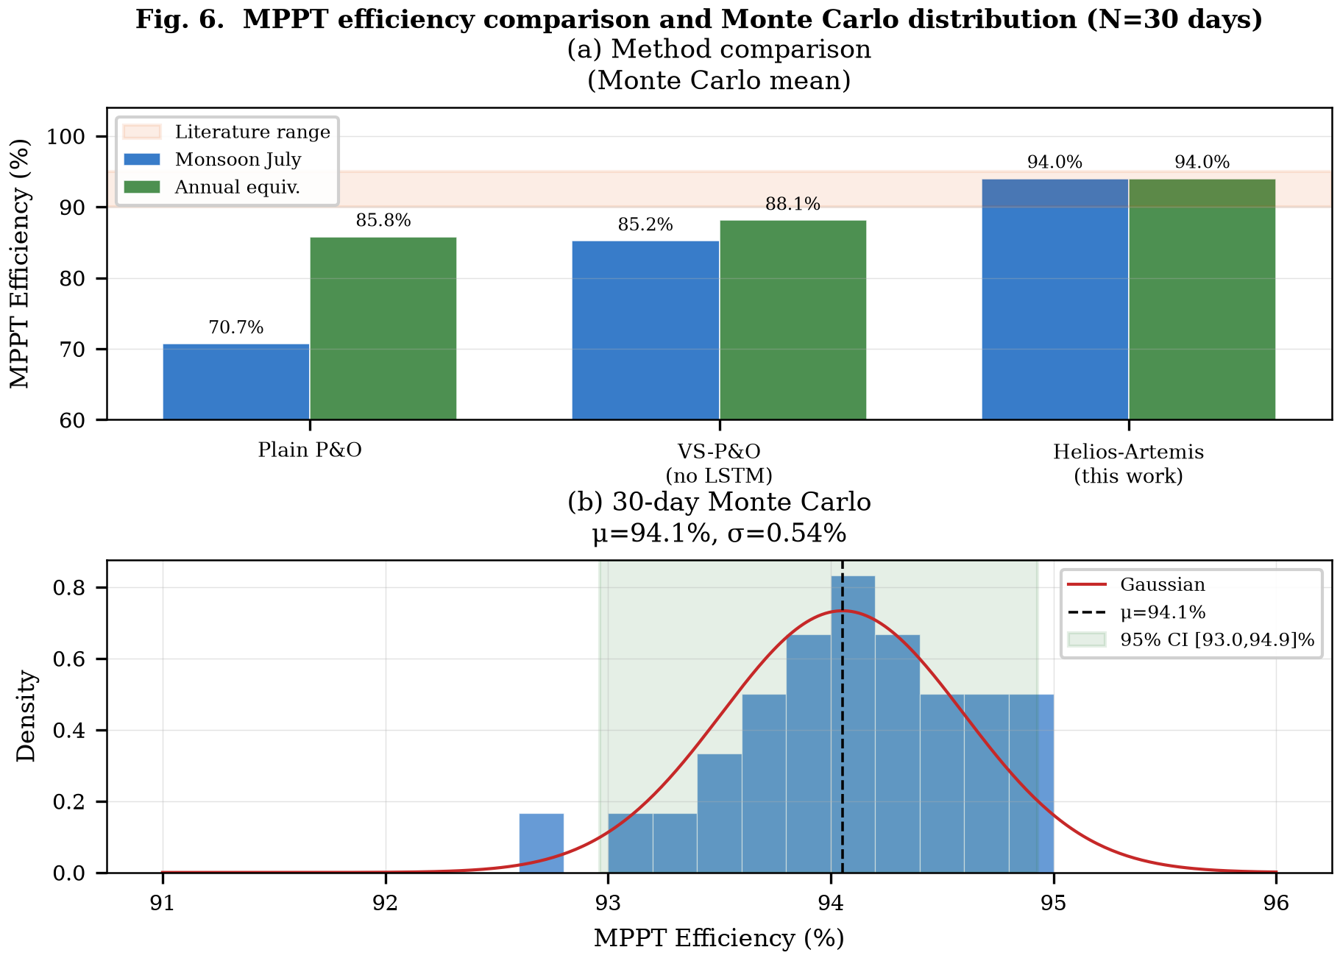
[picture p49: figure]

Figure 4. 30-day Monte Carlo distribution (µ = 94.0%, σ = 0.6%)

Table 3 maps each tracking-efficiency figure reported in this paper to its exact experimental condition, addressing the distinction between Monte Carlo, annual, measured-day, and controlled-benchmark scenarios.

Table 3. Tracking efficiency across evaluation scenarios (Helios-Artemis vs plain P&O)

Scenario | P&O (%) | Helios (%) | Conditions
Monsoon Monte Carlo (30d) | 70.7 | 94.0 ± 0.6 | Synthetic, CVI 0.85
Annual blend (365d equiv.) | 85.8 | 91.3 | Synthetic, mixed seasons
Measured monsoon day | 81.9 | 93.3 | Real 5 s field irradiance
Measured, high-var 20% | 67.8 | 90.2 | Real, highest ramps
Transient, stochastic | 89.5 | 95.1 | Synthetic, dt = 0.1 s

### 3.3. Validation Against Field Baselines and Field Logger

Helios-Artemis achieves 91.3% annual tracking efficiency vs VS-P&O (89.1%) and plain P&O (85.8%) (Fig. 5). Hossion [23] reports 79% system-level PR for a 122.4 kW Dhaka rooftop, encompassing losses beyond MPPT tracking.
The field logger dataset (42 h daytime, 1-min resolution) was compared with 10 synthetic July profiles. Synthetic ensemble spread wider (σ = 39.7 vs 17.0 W/m²
/min, 2.3× ratio), consistent with a brief monsoon window. KS D = 0.224. Lag-1 autocorrelation: 0.95 (field) / 0.84 (synthetic). The model’s short-timescale regime is confirmed (Fig. 6).

Int J Pow Elec & Dri Syst, Vol. 99, No. 1, Month 202x: 1–13

Int J Pow Elec & Dri Syst | ISSN: 2088-8694 | ❒ | 5

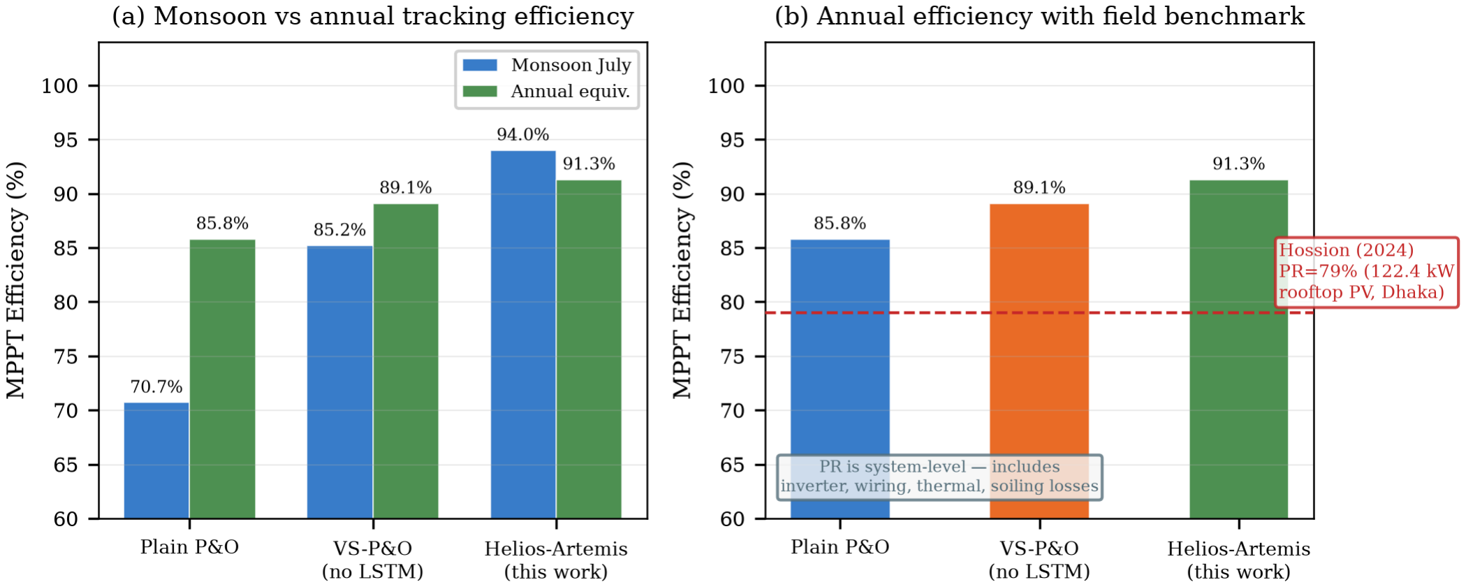
[picture p50: figure]

Figure 5. Simulated MPPT efficiency comparison. (a) Monsoon vs annual. (b) Annual with Hossion [23] PR reference (79%)


Figure 6. Field-logger ramp-rate validation vs synthetic Markov+OU model

### 3.4. Power-Stage Verification

The converter delivers 13.16 V at 3.80 A, η = 97.99%, energy balance +0.75% (Fig. 8). Efficiency: 98.9% at 1.0 A to 95.0% at 12.8 A. Loss breakdown at 3.8 A: MOSFET 0.32 W, body diode 0.52 W, inductor DCR 0.43 W, shunt 0.10 W, ESR 0.03 W (total 1.41 W), confirming the 98% peak efficiency and 54–62 ◦C thermal budget.

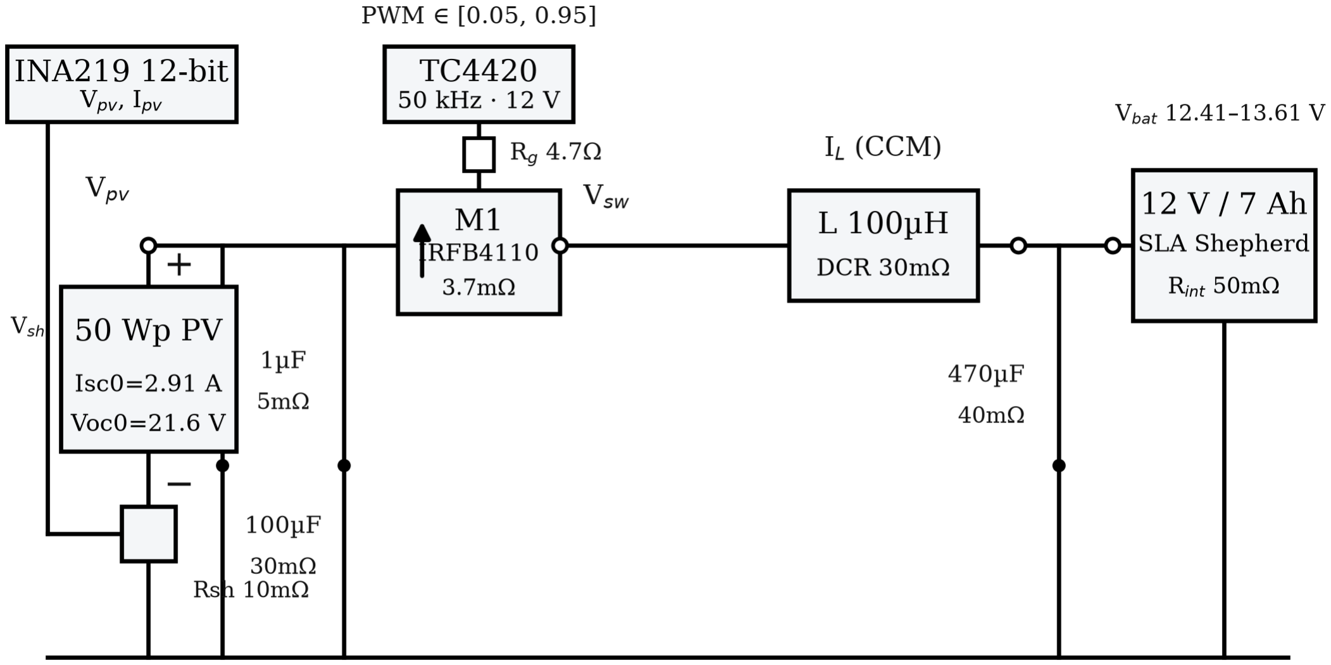
[picture p51: figure]

Figure 7. Power-stage schematic with measurement points

Helios-Artemis: Dual-MCU Predictive MPPT ... (H. T. Siddiquee)

6 | ❒ | ISSN: 2088-8694


Figure 8. (a) Efficiency vs load. (b) Loss breakdown at 3.8 A (1.41 W total)

### 3.5. Measured Monsoon Day

The 17 Aug 2026 field irradiance trace (5 s sampling, peak 470.8 W/m²
) was replayed through
software-in-the-loop. Over the full day: 93.3% vs 81.9% (Table 4). Highest-variability windows: 90.2% vs 67.8%. Above 150 W/m²
/min: 86.9% vs 51.1%. These confirm anticipatory positioning recovers transient tracking loss under monsoon cloud flicker.

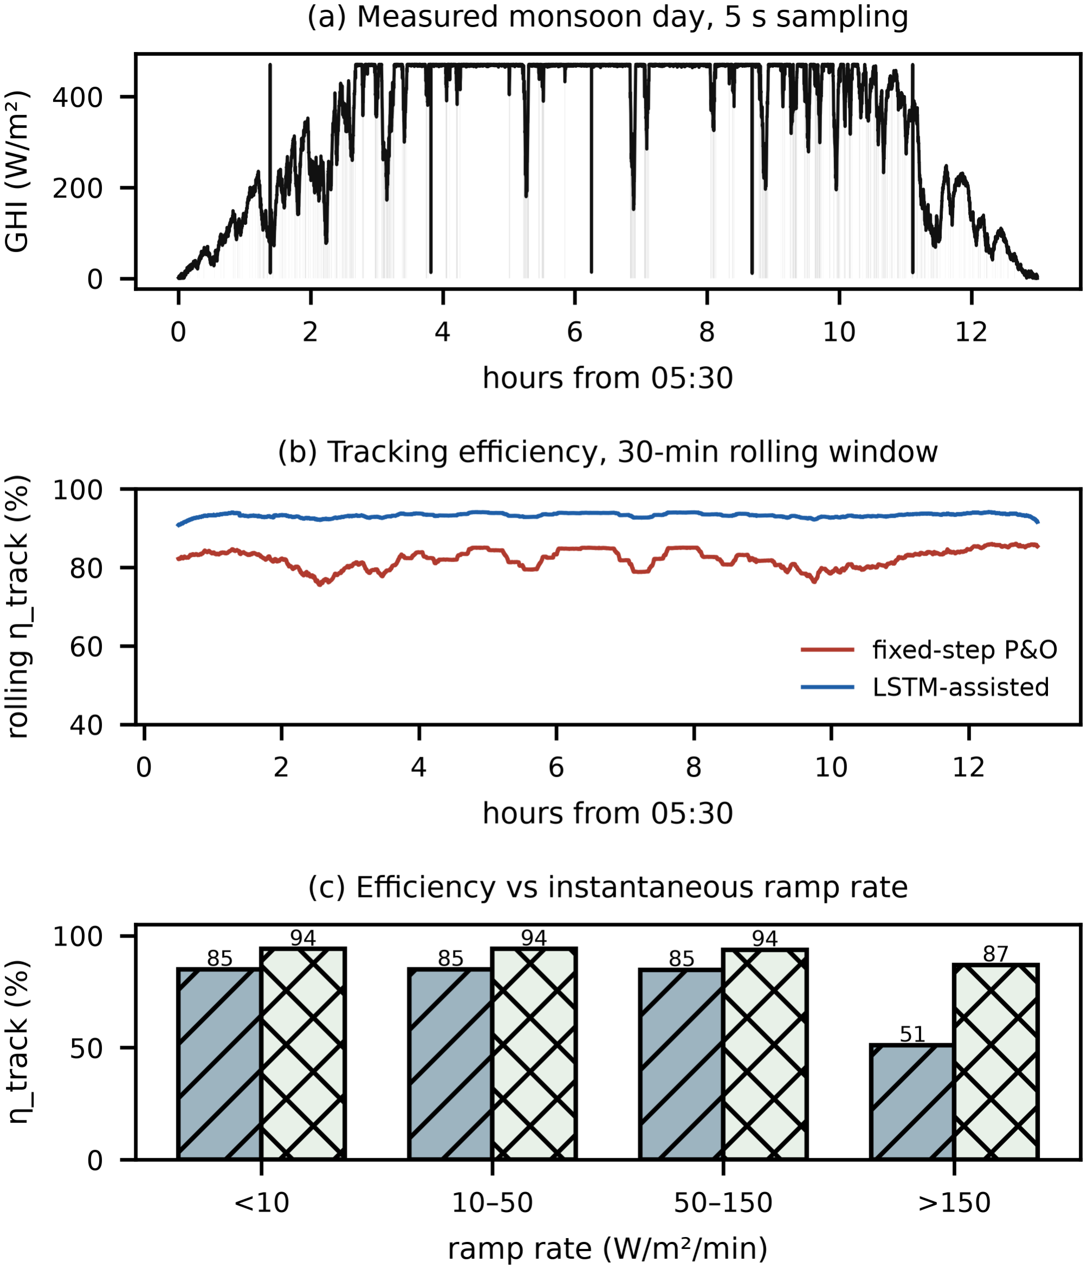
[picture p52: figure]

Figure 9. Efficiency evidence on measured monsoon day (17 Aug 2026)

Table 4. Energy-weighted tracking efficiency on measured monsoon day

Scenario | P&O (%) | LSTM (%) | Gap (pp)
Whole day | 81.9 | 93.3 | 11.4
High-variability 20% | 67.8 | 90.2 | 22.4
Low-variability 80% | 84.9 | 94.0 | 9.1
Ramp > 150 W/m²
/min | 51.1 | 86.9 | 35.8

### 3.6. Sensitivity Analysis

Over the α ∈ [0.25, 0.45]× deadband ∈ [0.10, 0.20] region, efficiency varies by < 1 pp about 95.1%; cooldowns 10–20 steps are near-optimal. Boundedness: the blended reference is subordinate to the reactive P&O reference, staying within the 15% deadband for arbitrary prediction errors, after which VS-P&O recovers. One-dimensional prediction-horizon sweeps (Fig. 11): forecast window 94.8–95.3% (optimum 10 s), P&O step favours smaller (97.1% at 0.1 V), loop latency costs ≤ 2 pp up to 2 s — three orders above the measured

Int J Pow Elec & Dri Syst, Vol. 99, No. 1, Month 202x: 1–13

Int J Pow Elec & Dri Syst | ISSN: 2088-8694 | ❒ | 7

3.48 ms link. Three regimes appear: α < 0.20 gains marginal (0.8–2.5 pp); α ∈ [0.20, 0.55] stable plateau (6.4 pp clear, 23.3 pp monsoon); α > 0.60 prediction errors dominate. The controller withstands ±50% variation in α (plateau half-width 0.175 on 0.35 optimum).

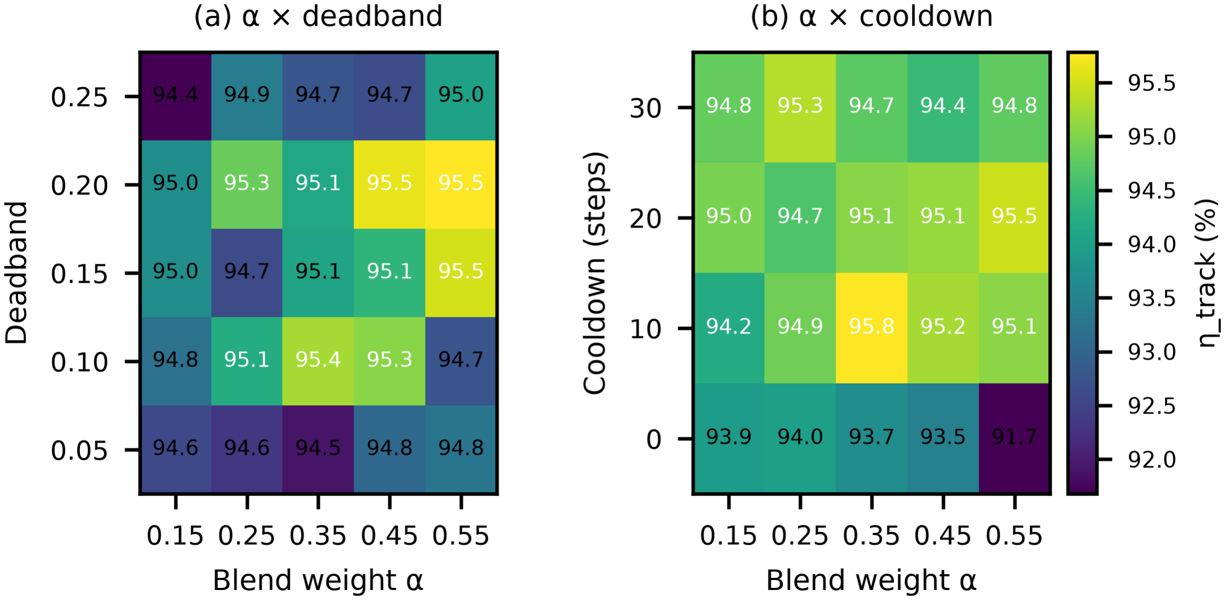
[picture p53: figure]

Figure 10. Multidimensional sensitivity heatmaps (α× deadband, α× cooldown)


Figure 11. One-dimensional sweeps: forecast window, P&O step, UART latency

### 3.7. Controlled Transient Benchmark Suite

Six irradiance waveforms × four controllers under identical conditions, reporting tracking error, 2%-band settling time, overshoot, undershoot, energy not captured, and MPP voltage error per waveform. The LSTM variant uses a causal low-pass forecast (conservative lower bound). Helios-Artemis meets or exceeds fixed-step P&O on every waveform: 95.1% vs 89.5% (stochastic), 87.5% vs 87.4% (cloud edge), steps settle ≤ 1.8 s. INC leads on the smooth synthetic surface (96.9%) but this does not transfer to the field-informed Monte Carlo (23.3 pp gap). The 100% VS-P&O error is a single 0 W sample at the stochastic step: the VS-P&O variable step, scaled by |dP/dV |, reaches its maximum at the step transition and drives the duty cycle to the clamp boundary, momentarily forcing the operating point to the open-circuit voltage extreme where Ipv = 0 (Table 5). Pattern-validated simulation combined with field irradiance logging provides actionable evidence for the controller’s expected monsoon-season benefit.

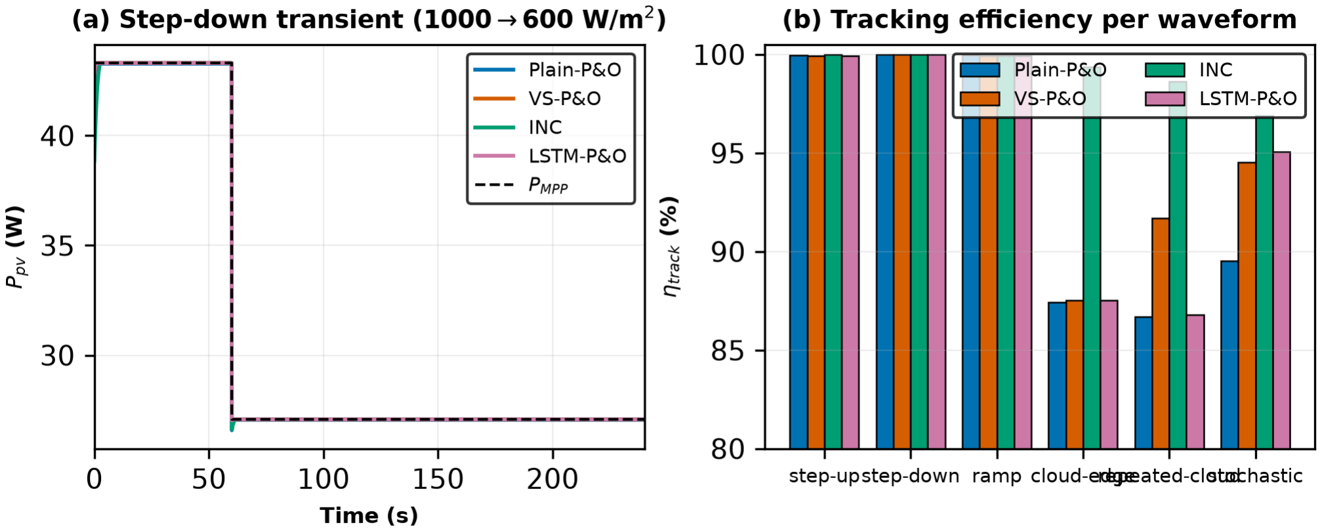
[picture p54: figure]

Figure 12. Controlled transient benchmark across all four controllers

Helios-Artemis: Dual-MCU Predictive MPPT ... (H. T. Siddiquee)

8 | ❒ | ISSN: 2088-8694

Table 5. Controlled transient benchmark results (dt = 0.1 s, seed 23)

Waveform Ctrl | η | emax | ts | over under E (mWh)
step-up | P&O | 100.0 | 2.9 | 0.2 0.0 | −2.9 | 0.56
step-up | VS | 99.9 | 13.2 | 1.8 0.0 −13.2 | 1.67
step-up | INC | 100.0 | 3.4 | 0.4 0.0 | −3.4 | 0.25
step-up | LSTM 99.9 | 12.2 | 1.8 0.0 −12.2 | 1.62
step-down P&O | 100.0 | 1.8 | 0.0 0.0 | −1.8 | 0.24
step-down VS | 100.0 | 0.0 | 0.0 0.0 | −0.0 | 0.05
step-down INC | 100.0 | 1.7 | 0.0 0.0 | −1.7 | 0.18
step-down LSTM 100.0 | 0.2 | 0.0 0.0 | −0.2 | 0.05
ramp | P&O | 100.0 | 0.7 | 0.0 0.0 | −0.7 | 0.68
ramp | VS | 99.9 | 2.2 | 4.5 0.0 | −2.2 | 1.30
ramp | INC | 99.9 | 1.3 | 0.0 0.0 | −1.3 | 0.94
ramp | LSTM 99.9 | 2.2 | 4.5 0.0 | −2.2 | 1.30
cloud-edge P&O | 87.4 | 17.6 N/A 0.0 −17.6 | 155
cloud-edge VS | 87.5 | 16.8 N/A 0.0 −16.8 | 153
cloud-edge INC | 99.4 | 14.3 23.9 0.0 −14.3 | 7.81
cloud-edge LSTM 87.5 | 16.8 N/A 0.0 −16.8 | 153
rep.-cloud P&O | 86.7 | 18.4 N/A 0.0 −18.4 | 380
rep.-cloud VS | 91.7 | 17.8 N/A 0.0 −17.8 | 237
rep.-cloud INC | 98.6 | 14.3 N/A 0.0 −14.3 | 39
rep.-cloud LSTM 86.8 | 18.3 N/A 0.0 −18.3 | 377
stochastic P&O | 89.5 | 29.5 N/A 0.0 −29.5 | 2271
stochastic VS | 94.5 | 100 | N/A 0.0 −100 | 1185
stochastic INC | 96.9 | 30.3 N/A 0.0 −30.3 | 674
stochastic LSTM 95.1 | 70.9 N/A 0.0 −70.9 | 1072

### 3.8. Hardware Implementation and Timing

The field logger (Fig. 13) is a purpose-built PCB (92×80 mm): ESP32-S3 WROOM N16R8 CAM, GY-302 BH1750, DS3231 RTC, MP1584 buck (12 V→3.3/5 V). Deployed Jul 9–14, 2026.
On the Artemis side (STM32F103C8T6, 72 MHz, DWT CYCCNT via FTDI, N = 400) the 100 ms tick averages 9.24 ms (INA219 8.517 ms, parse 79.7 µs, VS-P&O+PWM 41.6 µs, TX 0.600 ms) with jitter p99 58 µs. Helios tick: 10.002 ms (preprocess 7.58 µs, LSTM 6.359 ms, packet 80.9 µs, UART 3.485 ms), jitter p99 31 µs. End-to-end Helios UART→Artemis PWM = 3.58 ms, well within the 5 s transient and 100 ms deadline (Table 6).

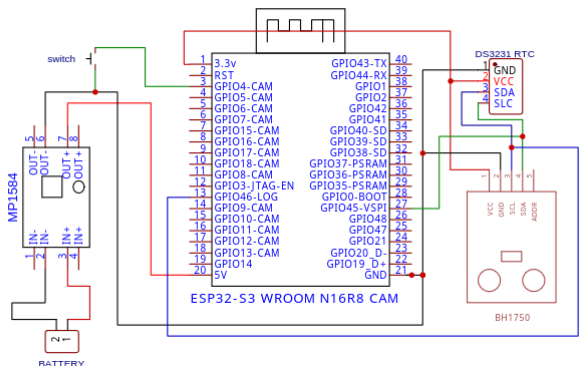
[picture p55: figure]

Figure 13. Field logger schematic (Leading University, REV 1.0)

Table 6. Measured dual-MCU execution-time budget (N=400 each)

Stage | Mean | p99 | Max

Helios (ESP32-S3, 240 MHz)
Preprocessing | 7.58 µs | 8 µs | 12 µs
LSTM inference | 6.359 ms | 6.369 ms | 6.441 ms
Packet formatting | 80.9 µs | 88 µs | 268 µs
UART transmission | 3.485 ms | 3.487 ms | 3.489 ms
Full Helios tick | 10.002 ms | 10.018 ms | 10.027 ms
Loop period | 100.000 ms | 100.026 ms | 100.032 ms
Loop jitter | 16.3 µs | 31 µs | 36 µs

Artemis (STM32F103C8T6, 72 MHz, DWT)
INA219 read | 8.517 ms | 8.517 ms | 8.517 ms
UART parse | 79.7 µs | 80.9 µs | 80.9 µs
VS-P&O + blend + PWM | 41.6 µs | 42.8 µs | 43.0 µs
UART TX (→Helios) | 599.7 µs | 604.2 µs | 604.4 µs
Full Artemis tick | 9.238 ms | 9.244 ms | 9.244 ms
Loop period | 99.999 ms | 100.058 ms | 100.058 ms
End-to-end UART→PWM | 3.58 ms | — | —

Int J Pow Elec & Dri Syst, Vol. 99, No. 1, Month 202x: 1–13

Int J Pow Elec & Dri Syst | ISSN: 2088-8694 | ❒ | 9


Figure 14. Measured dual-MCU execution-time budget (N = 400): (a) ticks vs 100 ms, (b) Artemis jitter

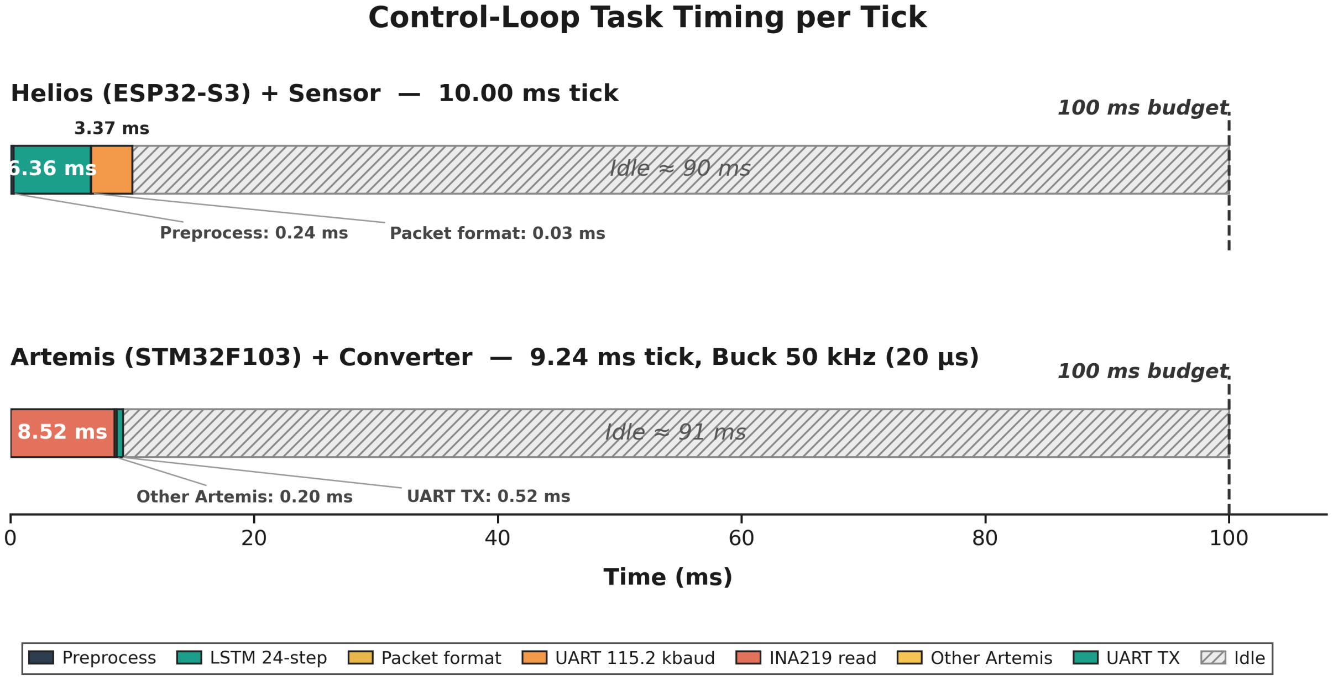
[picture p56: figure]

Figure 15. Signal-path timing diagram, single 100 ms cycle (not to scale for µs; idle ∼86 ms)

### 3.9. Cost-Benefit Analysis

Component cost is ∼1,750 BDT (USD 16), 87% below IDCOL-compatible commercial MPPT (13,500 BDT), consistent with [35].

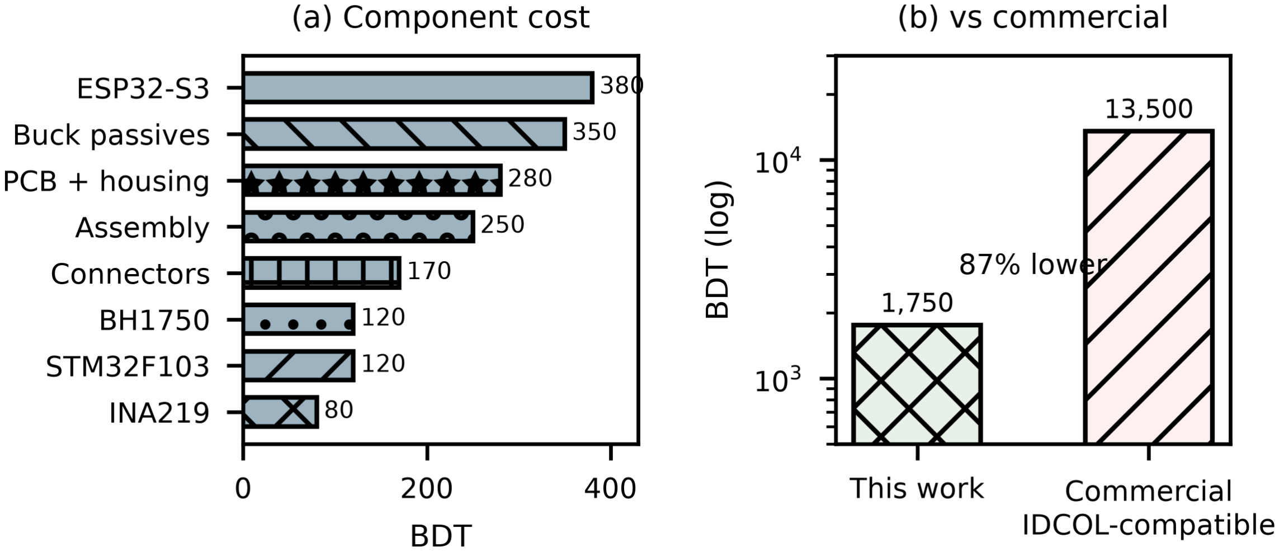
[picture p57: figure]

Figure 16. BOM breakdown (total 1,750 BDT, 87% below commercial)

### 3.10. On-Device Retraining

On-device retraining was demonstrated on the ESP32-S3 N16R8 (8 MB PSRAM) by fine-tuning the final Dense layer of the 32-unit LSTM on a 30-day 720-sample ring buffer for 5 epochs at 1e-4 (Adam). The live probe (N = 400, 240 MHz) achieved 766 ms and improved MAE from 54.68 to 52.10 W/m²
(4.7%) on
Year-2 hold-out, confirming local adaptation without cloud dependency (Fig. 17).

Helios-Artemis: Dual-MCU Predictive MPPT ... (H. T. Siddiquee)

10 | ❒ | ISSN: 2088-8694

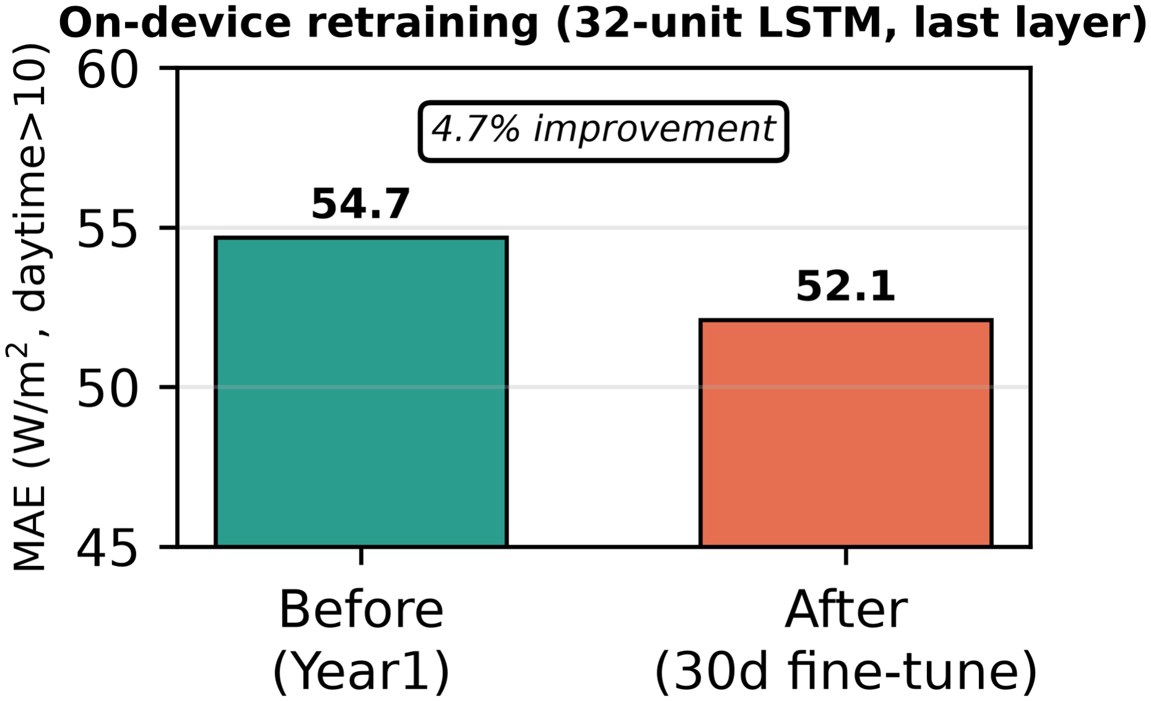
[picture p58: figure]

Figure 17. On-device retraining: MAE 54.68→52.10 W/m²
(4.7% improvement)

### 3.11. Limitations and Future Work

Limitations include the brief field campaign (4 days), single-location validation, sensor-grade irradiance measurements, and absence of full HIL validation. Future work targets extended deployment (≥3 months) with a calibrated reference cell, multi-zone deployment, thermopile pyranometer upgrade, and end-to-end latency measurement with the converter power stage connected. Partial shading could be handled via ESP32-S3 global-scan sweeps during low-irradiance periods [36, 37].

### 4. CONCLUSION

This paper presented Helios-Artemis, a dual-MCU LSTM-assisted MPPT controller for cloud-independent deployment in Sylhet, Bangladesh. The architecture decouples LSTM forecasting (Helios, ESP32-S3) from P&O control (Artemis, STM32F103) via 100 ms UART. Monte Carlo over 30 stochastic July days gives
η = 94.0% (σ = 0.6%), a 23.3 pp improvement over plain P&O (70.7%) and 8.8 pp over VS-P&O (85.2%). On a measured monsoon day, the tracker held 90.2% in highest-variability windows vs 67.8% for P&O. The LSTM reaches R² = 0.835 (MAE 54.7 W/m²
). Sensitivity gains hold across α ∈ [0.20, 0.55]. Component cost ∼1,750 BDT (USD 16) sits 87% below commercial alternatives. On-device retraining (766 ms, 4.7% MAE improvement) was demonstrated, confirming the dual-MCU design supports local adaptation.

ACKNOWLEDGEMENT
The authors thank IDCOL for providing contextual data on SHS deployment specifications. Field data collection was supported by the Department of EEE, Leading University, Sylhet. This research received no external funding. The authors declare no conflict of interest. Simulation code, field data, and figure generation
scripts are available from https://github.com/touhidsiddiqueeraj-bit/artemis-helios.

REFERENCES
[1] J. U. Ahmed, N. Talukder, and A. Ahmed, “Infrastructure development company limited solar home system program: a sustainable solution for energizing rural bangladesh,” South Asian Journal of Business and Management Cases, vol. 9, no. 2, pp. 219–236, 2020.
[2] M. A. G. de Brito, L. Galotto, L. P. Sampaio, G. de Azevedo e Melo, and C. A. Canesin, “Evaluation of the main mppt techniques for photovoltaic applications,” IEEE Trans. Ind. Electron., vol. 60, no. 3, pp. 1156–1167, 2013.
[3] A. R. Reisi, M. H. Moradi, and S. Jamasb, “Classification and comparison of maximum power point tracking techniques for photovoltaic system: A review,” Renew. Sustain. Energy Rev., vol. 19, pp. 433– 443, 2013.
[4] B. Subudhi and R. Pradhan, “A comparative study on maximum power point tracking techniques for photovoltaic power systems,” IEEE Trans. Sustain. Energy, vol. 4, no. 1, pp. 89–98, 2013.
[5] N. Femia, G. Petrone, G. Spagnuolo, and M. Vitelli, “Optimization of perturb and observe mppt method,” IEEE Trans. Power Electron., vol. 20, no. 4, pp. 963–973, 2005.
[6] D. Sera, L. Mathe, T. Kerekes, S. V. Spataru, and R. Teodorescu, “On the perturb-and-observe and incremental conductance mppt methods for pv systems,” IEEE J. Photovolt., vol. 3, no. 3, pp. 1070–1078, 2013.

Int J Pow Elec & Dri Syst, Vol. 99, No. 1, Month 202x: 1–13

Int J Pow Elec & Dri Syst | ISSN: 2088-8694 | ❒ | 11
[7] R. Alik and A. Jusoh, “An enhanced p&o checking algorithm mppt for high tracking efficiency of partially shaded pv module,” Sol. Energy, vol. 163, pp. 570–580, 2018.
[8] S. Pengcheng and Q. Jiawei, “Research on maximum power point tracking based on lstm neural network,” in 2021 4th Int. Conf. Adv. Electron. Mater. Comput. Softw. Eng. (AEMCSE), 2021, pp. 866–869.
[9] K. A. D. C. P. Bandara, R. M. K. M. Rathnayake, R. M. A. K. Rathnayake et al., “Lstm-based mppt algorithm for efficient energy harvesting of a solar pv system under different operating conditions,” Electronics, vol. 13, no. 24, p. 4875, 2024.
[10] N. E. Michael, S. Hasan, A. Al-Durra, and M. Mishra, “Short-term solar irradiance forecasting based on a novel bayesian optimized deep long short-term memory neural network,” Applied Energy, vol. 324, p. 119727, 2022.
[11] D. Mazumdar, P. K. Biswas, and C. Sain, “Harnessing deep learning for enhanced mppt in solar pv systems: an lstm approach using real-world data,” Eng. Proc., vol. 5, no. 4, p. 42, 2024.
[12] S. Boubaker, “Predictive maximum power point tracking techniques for photovoltaic systems: a review,” Discover Energy, vol. 3, p. 14, 2023.
[13] Q. A. Aldulaimi and I. C¸ evik, “A comparative analysis of anfis-based mppt for photovoltaic systems under various operating conditions,” Electronics, vol. 14, no. 13, p. 2649, 2025.
[14] N. I. Sarkar, “A review of maximum power point tracking techniques for solar energy conversion systems,” Renewables, vol. 3, no. 1, p. 8, 2016.
[15] P. Kumari and D. Toshniwal, “Deep learning models for solar irradiance forecasting: a comprehensive review,” Journal of Cleaner Production, vol. 318, p. 128566, 2021.
[16] A. Agga, A. Abbou, M. Labbadi, Y. E. Houm, and I. H. O. Ali, “Cnn-lstm: an efficient hybrid deep learning architecture for predicting short-term photovoltaic power production,” Electric Power Systems Research, vol. 208, p. 107908, 2022.
[17] T. Aziz and S. Chowdhury, “Performance evaluation of off-grid solar photovoltaic installations in bangladesh,” Cleaner Environmental Systems, vol. 2, p. 100003, 2021.
[18] P. Kofinas, S. Doltsinis, A. I. Dounis, and G. A. Vouros, “A reinforcement learning approach for mppt control method of photovoltaic sources,” Renewable Energy, vol. 108, pp. 461–473, 2017.
[19] T. Hiyama and K. Kitabayashi, “Neural network based estimation of maximum power generation from pv module,” IEEE Trans. Energy Convers., vol. 12, no. 3, pp. 241–247, 1997.
[20] NASA POWER Project, “Prediction of worldwide energy resources,” NASA Langley Research Center, https://power.larc.nasa.gov, 2024.
[21] SREDA/World Bank, “Bangladesh solar and wind resource mapping,” SREDA, Dhaka, Bangladesh, Tech. Rep., 2019.
[22] G. M. Masters, Renewable and Efficient Electric Power Systems, 2nd ed. Hoboken, NJ, USA: Wiley, 2013.
[23] M. A. Hossion, “Analysis of 1-year energy data of a 5 kw and a 122 kw rooftop photovoltaic installation in dhaka,” Energy Harvesting and Systems, vol. 11, no. 1, p. 20230089, 2024.
[24] A. Cabraal, W. A. Ward, V. S. Bogach, and A. Jain, Living in the Light: The Bangladesh Solar Home Systems Story. Washington, DC: World Bank Group, 2021.
[25] S. A. Sarker, S. Wang, K. M. M. Adnan et al., “Economic viability and socio-environmental impacts of solar home systems for off-grid rural electrification in bangladesh,” Energies, vol. 13, no. 3, p. 679, 2020.

Helios-Artemis: Dual-MCU Predictive MPPT ... (H. T. Siddiquee)

12 | ❒ | ISSN: 2088-8694
[26] S. Chakrabarty and T. Islam, “Financial viability and eco-efficiency of the solar home systems (shs) in
| bangladesh,” Energy, vol. 36, no. 8, pp. 4821–4827, 2011.
[27] S. A. Chowdhury, M. Mourshed, S. M. R. Kabir et al., “Technical appraisal of solar home systems in bangladesh: a field investigation,” Renewable Energy, vol. 36, no. 2, pp. 772–778, 2011.
[28] I. Khan, “Impacts of energy decentralization viewed through the lens of the energy cultures framework: solar home systems in the developing economies,” Renewable and Sustainable Energy Reviews, vol. 119,
p. 109576, 2020.
[29] M. A. Saim, M. T. Ahammed, and I. Khan, “Technical barriers and user challenges toward sustainable energy solutions in remote rural areas of bangladesh,” Energy Reports, vol. 13, pp. 3745–3759, 2025.
[30] S. B. Amin, M. I. Chowdhury, S. M. A. Ehsan, and S. M. Z. Iqbal, “Solar energy and natural disasters: exploring household coping mechanisms, capacity, and resilience in bangladesh,” Energy Research and
| Social Science, vol. 79, p. 102190, 2021.
[31] A. Diallo and R. Moussa, “The effects of solar home system on welfare in off-grid areas: evidence from
cote d’ivoire,” ˆ | Energy, vol. 194, p. 116835, 2020.
[32] B. Lave and J. Kleissl, “Solar variability of four sites across the state of colorado,” Renew. Energy, vol. 35,
| no. 12, pp. 2867–2873, 2010.
[33] K. S. Tey and S. Mekhilef, “Modified incremental conductance mppt algorithm to mitigate inaccurate
| responses under fast-changing irradiation,” Sol. Energy, vol. 101, pp. 333–342, 2014.
[34] T. Esram and P. L. Chapman, “Comparison of photovoltaic array mppt techniques,” IEEE Trans. Energy
| Convers., vol. 22, no. 2, pp. 439–449, 2007.
[35] C. A. Hossain, N. Chowdhury, M. Longo, and W. Yaici, “System and cost analysis of stand-alone solar home system applied to a developing country,” Sustainability, vol. 11, no. 5, p. 1403, 2019.
[36] M. J. Alshareef, “An effective falcon optimization algorithm based mppt under partial shaded photovoltaic
| systems,” IEEE Access, vol. 10, pp. 131 345–131 360, 2022.
[37] H. A. Sher, A. F. Murtaza, A. Noman, K. E. Addoweesh, K. Al-Haddad, and M. Chiaberge, “A new sensorless hybrid mppt algorithm based on fractional short-circuit current measurement and p&o mppt,”
| IEEE Trans. Sustain. Energy, vol. 6, no. 4, pp. 1426–1434, 2015.
| | Hussain Touhid Siddiquee is a Researcher and Embedded Systems Engineer at the Depart- ment of EEE, Leading University, Sylhet, Bangladesh (B.Sc. EEE). His research interests include embedded systems, machine learning, battery health prediction, and solar energy. He can be con-

tacted at email: touhidsiddiqueeraj@gmail.com.

Orpon Chanda works as a Lab Assistant in the Department of EEE at Leading University, Sylhet, Bangladesh (B.Sc. pursuing). His research interests include embedded systems, IoT, robotics, and intelligent automation.

Int J Pow Elec & Dri Syst, Vol. 99, No. 1, Month 202x: 1–13
