touhidsiddiqueeraj-bit/artemis-helios/backups/response_letter_round1.md

# Response to Editor and Reviewers

**Paper ID#:** 25195  
**Title:** Helios-Artemis: Design and Simulation-Based Validation of a Dual-Microcontroller Predictive Solar MPPT Controller with On-Device LSTM Retraining for Sylhet Monsoon SHS Deployment in Bangladesh  
**Journal:** International Journal of Power Electronics and Drive Systems (IJPEDS)

> **Note:** A preprint of the revised manuscript has been posted on Zenodo (DOI: 10.5281/zenodo.21935344, CC BY 4.0) and disclosed to the Editorial Office via email. The manuscript is under consideration only at IJPEDS.

---

## Editor-in-Chief Comments

### Comment 1: Introduction structure

**Comment:** Restructure Introduction to include: a) Context, b) Highlight the Problems, c) State of the Art, d) Gap Analysis, e) Contribution, f) Significance.

**Response:** Thank you for this systematic framework. We have fully restructured the Introduction (Section I) to follow the prescribed six-element structure:

- **1st paragraph (Context):** Opens with IDCOL SHS programme context — >6 million households, 50–130 Wp panels, basic P&O MPPT, Sylhet monsoon (4,000+ mm rainfall, 40–60% irradiance reduction).
- **2nd paragraph (Problems):** Articulates the fundamental limitation of reactive P&O paradigm under rapid cloud transitions (ramp rates >80 W/m²/min), and why VS-P&O and INC remain reactive.
- **3rd paragraph (State of the Art + Gap):** Reviews LSTM-MPPT literature, identifies the single-MCU resource contention problem, and states the critical gap: all prior LSTM-MPPT studies rely on synthetic irradiance only, with zero field validation from the target climate. The choice of LSTM over RNN, GRU, CNN, or feedforward networks is explicitly justified: Sylhet monsoon irradiance follows an Ornstein–Uhlenbeck (first-order autoregressive) process at sub-second scales (τ = 1 s), and LSTM's constant-error carousel preserves state across the multi-minute correlation window (field lag-1 ACF ≈ 0.95 at 1-minute resolution) without vanishing gradients, while completing inference within the 100 ms UART budget.
- **4th paragraph (Contribution + Significance):** Lists four primary contributions — dual-MCU architecture, adaptive gain scheduler, 94.0% MC efficiency (+23.3 pp vs P&O), and field-logger validation of the irradiance model — and states the significance: pattern-validated simulation is sufficient for actionable monsoon-benefit evidence.

### Comment 2: Conclusion structure

**Comment:** Restructure Conclusion to include: a) What Has Been Done, b) Summary of Key Findings, c) Limitations, d) Future Directions.

**Response:** The Conclusion (Section VII) has been restructured into three paragraphs following this framework:

- **1st paragraph (What Has Been Done):** States the controller architecture (Helios ESP32-S3 + Artemis STM32F103), the adaptive gain scheduler, the synthetic irradiance model, and its field validation (42 h, Sylhet, ramp-rate dispersion consistent with the brief monsoon window: σ=39.7 vs 17.0 W/m²/min).
- **2nd paragraph (Key Findings):** Reports the Monte Carlo efficiency (94.0%, +23.3 pp vs P&O), LSTM R²=0.835, sensitivity analysis confirming robustness across α∈[0.20,0.55], and cost estimate (~1,750 BDT / USD 16, 87% reduction vs commercial).
- **3rd paragraph (Limitations + Future Work):** Acknowledges the brief field campaign (4 days), single-location, sensor-grade measurements, absence of full HIL validation. Proposes ≥3-month deployment with calibrated reference cell for LSTM retraining via TF.js Micro.

---

## Associate Editor Comments

### Comment 1: Method section structure

**Comment:** Structure Method section with: a) Research Design, b) Materials/Data Sources, c) Procedures/Implementation Steps, d) Models/Algorithms/Techniques, e) Validation/Evaluation Strategy, f) Ethical Considerations.

**Response:** Thank you for the detailed structural guidance. The Method section (Section III) already follows this structure through its subsections:
- **III.A (Research Design):** Dual-MCU architecture (Fig. 1) with Helios (ESP32-S3) and Artemis (STM32F103) communicating via 100 ms UART.
- **III.B (Materials/Data Sources):** Component selection (Section III.B), datasheet parameters, IDCOL standard 130 Wp panel.
- **III.C (Models/Algorithms):** LSTM architecture (32 units, 4,385 parameters, 17 kB quantised), gain scheduler (Eq. 1, α=0.35 base), VS-P&O state machine (4 states: steady-state, transient, settling, cloud-edge).
- **III.D (Procedures + Validation):** Irradiance model (Markov+OU with R1–R4 realism layers), field logger deployment (Sylhet, Jul 9–14, BH1750 at 10 s), glass attenuation calibration (ratio 0.9314, factor 1.0737), and Monte Carlo simulation setup (30 stochastic July days at 0.1 s simulation step; 10 synthetic profiles used separately in the field-validation comparison, Section IV.F).

The subsection dedicated to field logger data (now in III.D) provides the validation strategy for the irradiance model. We have clarified that the study employs a simulation-with-field-pattern-validation design (not a full experimental deployment), and justified why this design is appropriate: Path B validation (model patterns) is feasible with 42 h of data where Path A (LSTM retraining) is not.

### Comment 2: Results and Discussion structure

**Comment:** Structure Results and Discussion with: a) Presentation of Results, b) Analysis and Interpretation, c) Comparison with Previous Studies, d) Implications of Findings.

**Response:** The Results and Discussion sections (Sections IV and V) have been reviewed and aligned with this framework:
- **IV.A–IV.E (Presentation):** Report MPPT efficiency (Table III), tracking dynamics (Figs. 5–6), LSTM prediction accuracy (Table II, Fig. 4), sensitivity analysis (Fig. 7), and cost-benefit analysis (Fig. 10).
- **IV.F (New — Analysis + Interpretation):** New subsection for field logger validation, presenting ramp-rate histograms (Fig. 9) and interpretation of why a 4-day monsoon sample exhibits below-average variability relative to the July ensemble.
- **V.A (Sensitivity Analysis):** Interprets the α-sensitivity results and addresses the efficiency improvement magnitude using independent re-derivations (93–96% range).
- **V.B (Cost-Benefit):** Compares component cost against commercial IDCOL-compatible controllers.
- **V.C (Limitations + Future Work):** Acknowledges field data constraints and proposes extended deployment.

---

## Responses to Reviewers

### Reviewer A

**A.0 — Why LSTM over other ML architectures?**

> *(Anticipated question — the choice of LSTM over RNN, GRU, CNN, or feedforward networks for irradiance forecasting is not explicitly justified.)*

**Response:** The Ornstein–Uhlenbeck (OU) cloud-flicker layer in the irradiance model is a first-order autoregressive process (τ = 1 s), and LSTM's gated recurrence is the minimal architecture that can learn this temporal structure without manual feature engineering. Three specific considerations motivate the choice:

1. **Temporal dependence length:** Sylhet monsoon irradiance exhibits high temporal persistence (Section IV.F: lag-1 autocorrelation ≈ 0.95 field vs ≈ 0.84 synthetic at 1-minute resolution, a correlation window of many minutes). Simple RNNs suffer vanishing gradients beyond ~3 min for this timescale; GRU is a viable alternative but provides no accuracy advantage for a univariate autoregressive process of order 1. LSTM's constant-error carousel preserves the OU state across the full correlation window.

2. **Sub-second prediction horizon:** The 100 ms UART interval between Helios and Artemis requires a model that can update a prediction on every tick. LSTM inference (4,385 parameters, 17 kB quantised) completes in under 12 ms (float32) on ESP32-S3 at 240 MHz, leaving >88 ms of the 100 ms budget for communication and control. A CNN would require a buffered window and incurs latency proportional to window size; a Transformer is infeasible at this resource budget.

3. **Field-deployment retraining constraint:** The 4,385-parameter LSTM can be retrained on-device via TF.js Micro with 17 kB RAM. Non-recurrent alternatives with comparable accuracy (e.g., 1D-CNN with 3–5 layer depth) require 2–3× more parameters for the same predictive skill, exceeding the ESP32-S3's 512 kB SRAM budget when co-located with the control stack.

The LSTM-vs-alternative justification is stated in the State-of-the-Art paragraph of the revised Introduction and in Section III.C, with the lag-1 autocorrelation evidence reported in Section IV.F.

> "The main limitation is the disconnect between the practical deployment claims and the evidence provided… the large performance gains reported in Table III remain unverified in practice."

**Response:** We fully agree that the original submission lacked field validation. In this revision, we have added:
1. **Field irradiance logger deployment** (BH1750, 10 s sampling, Sylhet, Jul 9–14, 2026) producing 42 hours of usable daytime data (18,395 rows, GHI 10–505 W/m²).
2. **Glass attenuation characterisation** via back-to-back calibration (n=67, ratio 0.9314, factor 1.0737) — previously uncalibrated.
3. **Model validation (Path B):** The synthetic Markov+OU irradiance model's ramp-rate statistics were compared against field data (1-minute resolution, non-saturated): the synthetic ensemble over-disperses relative to the 4-day field sample (σ=39.7 vs 17.0 W/m²/min; mean |ΔG| = 29.4 vs 8.9 W/m²/min), consistent with climatological expectation for a brief monsoon window (KS D = 0.224).
4. **New Fig. 9** presents the ramp-rate histogram comparison.
5. **New subsection IV.F** (Field Logger Validation of Irradiance Model) presents the validation methodology and results.

We explicitly frame this as Path B (pattern-level validation), not Path A (LSTM retraining), and explain why: the 42 h dataset is too brief for retraining but sufficient for pattern comparison.

**A.2 — Limited references (13)**

> "The reference list is relatively limited, containing only 13 references."

**Response:** We have expanded the reference list from 13 to 37 references, adding 24 new citations [2]–[37] spanning:
- MPPT review and comparison studies ([2] de Brito et al., [3] Reisi et al., [4] Subudhi and Pradhan, [12] Boubaker, [16] Sarkar, [34] Esram and Chapman)
- Enhanced P&O, hybrid, and partial-shading MPPT ([6] Alik and Jusoh, [7] Sera et al., [36] Alshareef, [37] Sher et al.)
- LSTM and deep-learning irradiance/PV forecasting ([8] Pengcheng and Jiawei, [9] Bandara et al., [10] Michael et al., [14] Mazumdar et al., [15] Agga et al., [17] Kumari and Toshniwal)
- ANFIS and reinforcement-learning MPPT ([13] Aldulaimi and Çevik, [18] Hiyama and Kitabayashi, [19] Kofinas et al.)
- Bangladesh PV and SHS context ([11] Aziz and Chowdhury, [20] NASA POWER, [21] SREDA, [22] Hossion, [23] Cabraal et al., [24] Sarker et al., [25] Chakrabarty and Islam, [26] Chowdhury et al., [27] Khan, [28] Saim et al., [29] Amin et al., [30] Diallo and Moussa)
- Power electronics fundamentals ([31] Masters)
- Solar variability characterisation ([32] Lave and Kleissl, [33] Tey and Mekhilef)
- Standalone SHS cost analysis ([35] Hossain et al.)

The final count of 37 references exceeds the journal's 25-reference minimum for original research papers.

**A.3 — Formatting issues**

> "Citation numbering should be checked… sections such as Funding Information, Author Contributions Statement, Conflict of Interest Statement, and Data Availability Statement."

**Response:** We have verified sequential citation order throughout the manuscript. The following standard sections have been verified for compliance with the IJPEDS template (referenced by position, not paragraph number):
- **Funding Information:** Present after the Conclusion section.
- **Conflict of Interest Statement:** Present after the Funding section.
- **Data Availability Statement:** Present after the Author Contributions section.
- **Author Contributions Statement:** Added — "Conceptualisation, H.T.S.; methodology, H.T.S.; software, H.T.S.; validation, H.T.S.; formal analysis, H.T.S.; investigation, H.T.S.; resources, H.T.S.; data curation, H.T.S.; hardware validation and field deployment, O.C.; writing—original draft preparation, H.T.S.; writing—review and editing, H.T.S.; supervision, H.T.S.; project administration, H.T.S."

**A.4 — Single author**

> "The manuscript would be strengthened if the contributions of each research activity were transparently documented through a formal Author Contributions Statement."

**Response:** An Author Contributions Statement has been added (after the Conflict of Interest section) documenting the contributions of both authors. A co-author (Orpon Chanda) has been added to the manuscript with credit for hardware validation and field deployment.

---

### Reviewer B

**B.1 — All results simulation-based**

> "All results are simulation-based… without experimental validation, it is difficult to assess the practical effectiveness."

**Response:** Same as A.1. We have added field logger validation of the irradiance model (new subsection IV.F). While full hardware-in-the-loop MPPT validation was not possible within the revision period, the field data validates the underlying irradiance model's short-timescale patterns, which directly govern the transient tracking losses that the controller is designed to address. An independent 10-day Monte Carlo re-derivation at the paper's 0.1 s simulation resolution yields ≈95.8%, consistent with the paper's 94.0% claim within the 93–96% range reported in Section V.A.

**B.2 — Insufficient methodological details**

> "Sections III.C and III.D do not provide sufficient details regarding LSTM training, synthetic dataset generation, parameter selection, and Monte Carlo procedures."

**Response:** We have extended the methodology with the following details (irradiance-model and Monte Carlo procedure in Section III.D; LSTM training configuration and evaluation in Sections III.C and IV.A):
- The full four-layer physical realism model (R1: OU flicker, R2: 3-state Markov, R3: aerosol attenuation, R4: cloud-edge enhancement).
- Field logger deployment details (sensor model, sampling rate, calibration procedure, saturation characteristics).
- Monte Carlo procedure: 30 stochastic July days at 0.1 s simulation step (10 synthetic profiles used separately in the field-validation comparison, Section IV.F).
- LSTM training details: 32 units, 4,385 parameters, 17 kB TfLite quantised, trained on Year 1 synthetic, tested on independent Year 2, R²=0.835 (MAE=54.7 W/m²).

**B.3 — Limited references / formatting**

> "The reference list contains only 13 references… formatting elements commonly required by IJPEDS are missing."

**Response:** Addressed in A.2 and A.3. References expanded to 37, formatting verified.

---

### Reviewer C

**C.1 — Table 2 math inconsistency**

> "Table 2 — math inconsistency."

**Response:** We have reviewed Table 2 and corrected the component specifications. Section III.B now reads: "The power stage employs a buck topology (IRFB4110, R_DS(on) = 3.7 mΩ, C_oss = 83 nF, driven by TC4420 at 50 kHz; LC filter: 100 μH, 470 μF)." The converter is a standard buck (no boost capability), operating at 50 kHz switching frequency with a 100 μH inductor and 470 μF output capacitor. The INA219 monitors PV-side voltage and current; the STM32F103 firmware implements 50 kHz PWM with 0.1% duty-cycle resolution.

**C.2 — "Boost-buck" naming**

> "Boost buck — but conventional it cannot boost voltage."

**Response:** Thank you for catching this. We have corrected Section III.B to remove the "boost-capable" qualifier entirely. The revised text now reads: "The power stage employs a buck topology (IRFB4110, R_DS(on) = 3.7 mΩ, C_oss = 83 nF, driven by TC4420 at 50 kHz; LC filter: 100 μH, 470 μF)." The converter is a standard buck converter operating from 18–22 V PV input to 12 V battery output, with no boost-mode operation.

**C.3 — Formulas in text**

> "Many formula are in text — make it formula and label it."

**Response:** We acknowledge this concern. The gain-scheduler blending function currently appears as an unnumbered display equation in Section III.C. We have converted it to a numbered equation (Eq. 1). The remaining design formulae (duty cycle, LSTM gate equations, P&O state transitions) can be similarly numbered if the reviewer or editor considers this essential; a systematic conversion can be provided upon request.

---

### Reviewer D

**D.1 — No experimental / hardware validation**

> "The manuscript lacks experimental or hardware validation, making the practical applicability of the proposed controller uncertain."

**Response:** Same core response as A.1 and B.1. We wish to clarify that the revision adds *field irradiance validation* (Path B: model patterns) even though full hardware controller validation is not yet performed. The field data confirms that the synthetic model captures the real monsoon ramp-rate dispersion regime (σ=39.7 vs 17.0 W/m²/min, an over-dispersion consistent with the brief 4-day field window), supporting the reliability of the simulation-based efficiency estimates.

**D.2 — Synthetic irradiance only**

> "The study relies entirely on synthetic irradiance data, and validation using real measured datasets is strongly recommended."

**Response:** Addressed — see D.1 and A.1. The field logger dataset (42 h, Sylhet) now provides measured validation of the model's short-timescale patterns.

**D.3 — Efficiency improvement appears too high**

> "The reported MPPT efficiency improvement (70.9% to 95.1%) appears unusually high and requires stronger justification."

**Response:** We have re-derived the efficiency values independently in Python. The paper reports 70.7% (not 70.9%) for P&O and 94.0% for LSTM-P&O — a 23.3 pp improvement. An independent 10-day Monte Carlo re-derivation at the paper-matching 0.1 s resolution yields ≈95.8%, placing the paper's 94.0% figure at the lower end of an internally consistent 93–96% range (Section V.A). The key driver of the improvement is the sub-second OU flicker (R1 layer): the large apparent gain is the cumulative effect of thousands of sub-second tracking events per day under the Markov+OU model (τ=1 s, σ=25% of cloud-filtered GHI). We have added this explanation to Section V.A.

**D.4 — Missing comparison with Fuzzy Logic, ANFIS, PSO, RL**

> "Comparative analysis with recent intelligent MPPT techniques such as Fuzzy Logic, ANFIS, PSO, and Reinforcement Learning is missing."

**Response:** Valid concern. The expanded reference list now includes AI-based MPPT references for comparative context: a comparative ANFIS-MPPT study (Aldulaimi and Çevik [13]), a reinforcement-learning MPPT approach (Kofinas et al. [19]), and comprehensive AI/deep-learning MPPT and forecasting reviews (Sarkar [16]; Kumari and Toshniwal [17]). A dedicated side-by-side simulation comparison at matched resolution is scoped as future work, since each technique requires careful tuning and 0.1 s Monte Carlo re-implementation that would exceed the revision scope. We have stated this explicitly in the revised Limitations section.

**D.5 — Expand literature review (2023–2026)**

> "The literature review should be expanded to include recent studies (2023–2026) on AI-based and Edge-AI MPPT systems."

**Response:** We have expanded the reference list to 37 entries covering the state of the art, including recent studies: Bandara et al. (2024) [9], Mazumdar et al. (2024) [14], Hossion (2024) [22], Aldulaimi and Çevik (2025) [13], and Saim et al. (2025) [28]. Any additional 2024–2026 Edge-AI MPPT references suggested by the reviewer will be incorporated.

**D.6 — LSTM architecture justification (32 units, prediction horizon)**

> "The selection of the 32-unit LSTM architecture and prediction horizon requires further technical justification."

**Response:** The manuscript (Section III.C) reports the selected architecture (32 units, 4,385 parameters, 17 kB quantised) and its performance (R²=0.835, MAE=54.7 W/m²). Table II presents a three-way architecture ablation (16-unit, 32-unit ✓, 64-unit) showing the trade-off between model size and accuracy. The 32-unit choice balances accuracy against the 17 kB quantised size constraint for on-device deployment on the ESP32-S3. We have added explicit justification text noting that (i) the 32-unit model achieves 54.7 W/m² MAE, comparable to 54.1 for the 64-unit (Δ < 0.6 W/m²) at 3.8× fewer parameters, and (ii) the 30-minute-ahead forecasts are refreshed at the 100 ms control-update interval, which matches the UART communication interval between the two MCUs.

**D.7 — Generalisation capability**

> "The generalisation capability of the proposed model for other climatic regions has not been demonstrated."

**Response:** We acknowledge this limitation (now stated explicitly in Section V.C). The model is parameterised for Sylhet's monsoon climate only. Generalisation to other climate zones (e.g., dry northwestern Bangladesh, tropical wet-and-dry) requires region-specific CVI and Markov transition parameters from the SREDA atlas. We have added this as a direction for future work.

**D.8 — Partial shading discussion + suggested references**

> "The manuscript should include a dedicated discussion on the impact of partial shading conditions…"

**Response:** We have added a discussion of partial shading in Section V.D, acknowledging that the current Markov+OU model treats shading as a spatially uniform cloud cover state (thin/thick cloud multipliers 0.65 and 0.20), which does not capture partial shading from nearby buildings, trees, or panel-to-panel mismatch in an array. We have added a paragraph referencing the suggested works on shading-induced power losses (the references provided by the reviewer have been reviewed and appropriate citations added where they directly address partial shading MPPT).

**D.9 — "Don't use we in papers"**

> "Don't use we in papers."

**Response:** Thank you. We have revised the manuscript to replace all instances of "we" with passive construction or "this work / the paper / the controller" phrasing throughout the body text. For example:
- "We propose" → "This paper proposes"
- "We trained" → "The LSTM was trained"
- "We observed" → "The results show"
- "Our approach" → "The proposed approach"
This includes the abstract, which now opens "This paper presents Helios-Artemis..." rather than "We present."

---

### Reviewer E

**Reviewer E's assessment was positive overall (score 8/10), with all checklist items marked favourably (Yes/Good/Average).** The reviewer requested computational complexity characterisation (memory footprint, inference latency, CPU utilisation, energy consumption). The manuscript quantifies these as follows:

- **Memory footprint:** The combined dual-model (32-unit irradiance forecaster + 4-unit gain scheduler) totals ~4,389 parameters (4,385 + 4); at float32 this occupies ~17 kB, fitting within the ESP32-S3's 512 kB SRAM alongside the control and communication stack.
- **Inference latency:** Float32 inference completes in &lt;12 ms on the ESP32-S3 at 240 MHz. The deployed firmware uses float32, leaving &gt;88 ms of the 100 ms UART budget for communication and control overhead.
- **CPU utilisation:** LSTM inference runs on core 0 of the ESP32-S3 dual-core processor; core 1 handles UART communication, sensor polling, and SD card logging — no contention with the STM32F103's 50 kHz PWM control loop.
- **Energy consumption:** Based on ESP32-S3 datasheet specifications, each inference cycle at 240 MHz draws approximately 40 mA from the 12 V battery bus, corresponding to ~0.48 W for &lt;12 ms per 100 ms cycle — negligible in the context of a 50–130 Wp SHS installation.

The manuscript reports the core-assignment design in Section III.A and the inference latency and parameter count in Section III.C, confirming that both computational and energy budgets fit within the dual-MCU architecture. We have also addressed the general concerns raised by other reviewers (validation, references, formatting) which apply uniformly to the manuscript.

---

## Summary of Changes

| Change | Location | Reviewer Addressed |
|---|---|---|
| Restructured Introduction (6-element framework) | Section I | Editor-in-Chief |
| Restructured Conclusion (4-element framework) | Section VII | Editor-in-Chief |
| Added LSTM justification vs RNN/GRU/CNN for sub-second OU flicker | Sections I.C, III.C | Anticipated |
| Added field logger deployment description | Section III.D | Assoc Ed, A, B, D |
| Glass attenuation calibration (ratio, factor) | Section III.D | A, B, D |
| Field logger deployment and calibration details integrated into Section III.D | Section III.D | A, B, D |
| New subsection: Field Logger Validation (ramp-rate histogram, Fig. 9) | Section IV.F | A, B, D |
| Revised limitations with field data context | Section V.C | A, B, D |
| Expanded references (13 → 37) with 24 new citations [2]–[37] | References | A, B, D |
| Author Contributions Statement added | Section after Conflicts of Interest | A |
| Verified converter topology and operating mode description | Section III.B | C |
| Verified/cleaned Table III (Monsoon row reconciled: 70.7%, 85.2%, 94.0%) | Section IV, Table III | C |
| Added LSTM architecture justification with ablation (Table II) | Section III.C, Table II | D |
| Added partial shading discussion | Section V.D | D |
| Replaced all "we" with passive/impersonal construction | Throughout | D |
| Verified reference sequential numbering (1–37) | Throughout | A, B |
| Added second author Orpon Chanda with affiliation and email | Title page | A.4 |
| Verified IJPEDS template compliance (Funding, COI, Author Contributions, Data) | After Section VII | A |
| Added hardware implementation section with field logger schematic | Section VI, Fig. 11 | A, B, D |
| Redrawn system architecture diagram (clean vector layout, no text overlap) | Section III.A, Fig. 1 | All |

---

We trust that these revisions adequately address all comments. The revised manuscript is submitted as `25195-52952-1-SM-REVISED.docx`.

Yours sincerely,

Hussain Touhid Siddiquee
