touhidsiddiqueeraj-bit/artemis-helios/Code/Python/figures/fig1_architecture.png

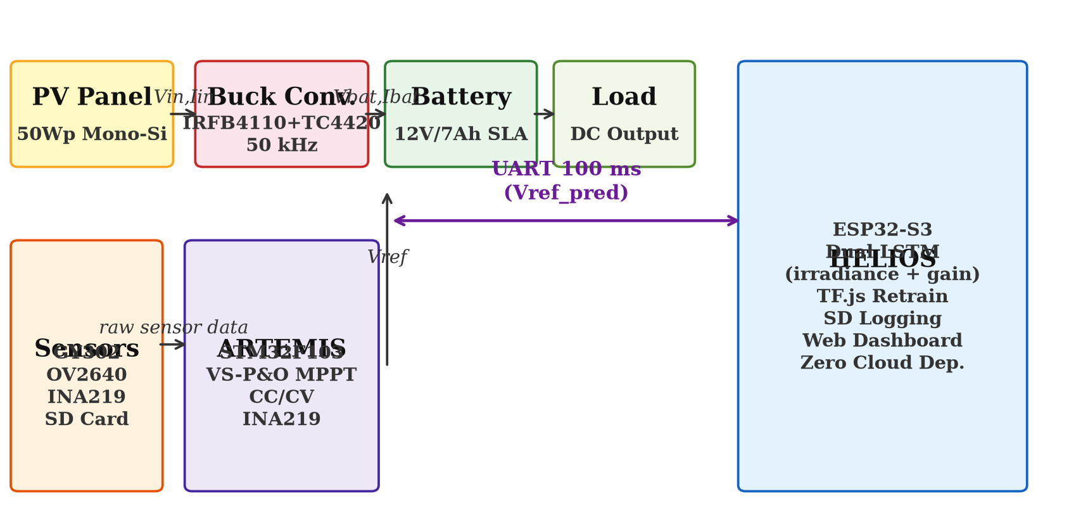
Code/Python/figures/fig1_architecture.png
