touhidsiddiqueeraj-bit/artemis-helios/Figures/figures_python/FIG1/Fig_System_Architecture.png

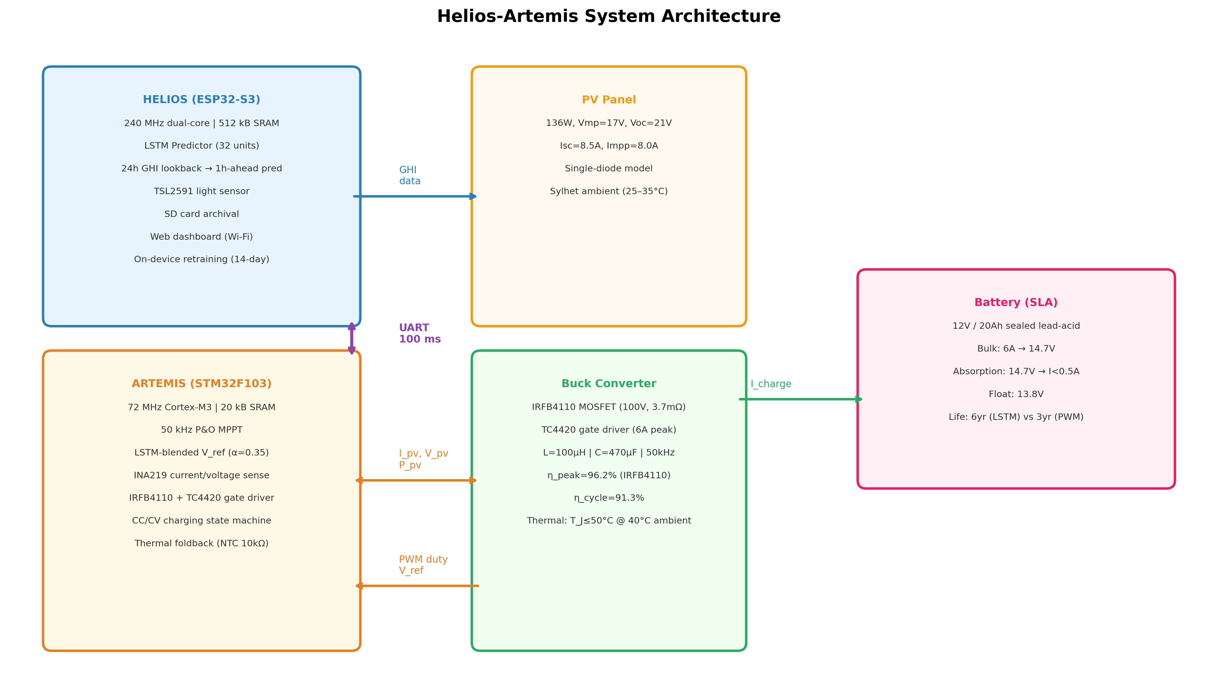
Figures/figures_python/FIG1/Fig_System_Architecture.png
