touhidsiddiqueeraj-bit/artemis-helios/Figures/figures_python/FIG1/output/fig1_architecture_fixed.png

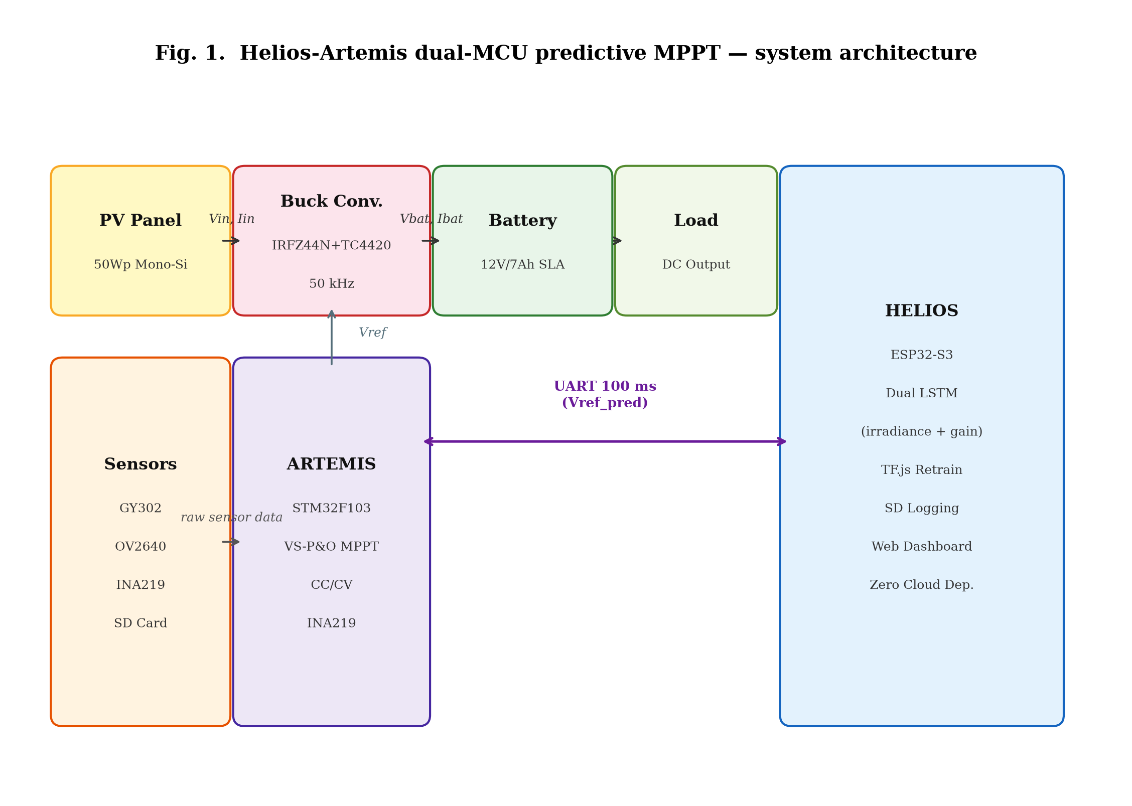
Figures/figures_python/FIG1/output/fig1_architecture_fixed.png
