touhidsiddiqueeraj-bit/artemis-helios/Figures/figures_python/fig1_architecture.png

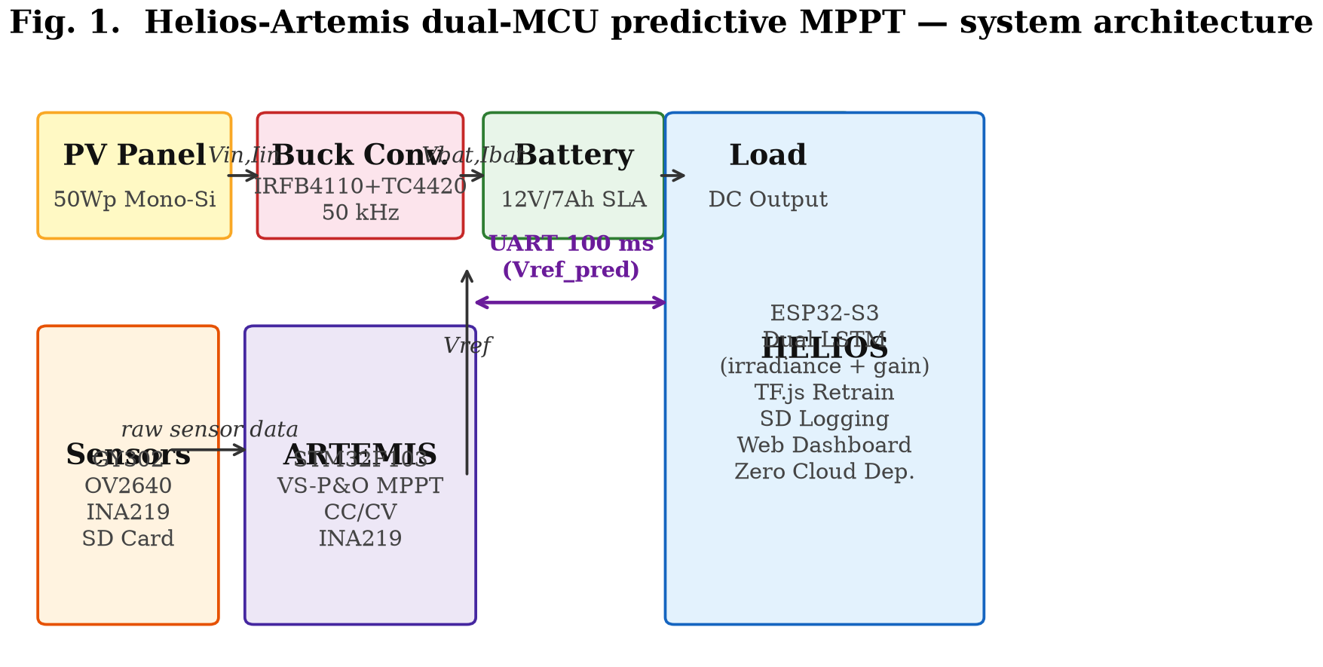
Figures/figures_python/fig1_architecture.png
