touhidsiddiqueeraj-bit/artemis-helios/Figures/figures_python/FIG3/output/fig3_iv_curves.png

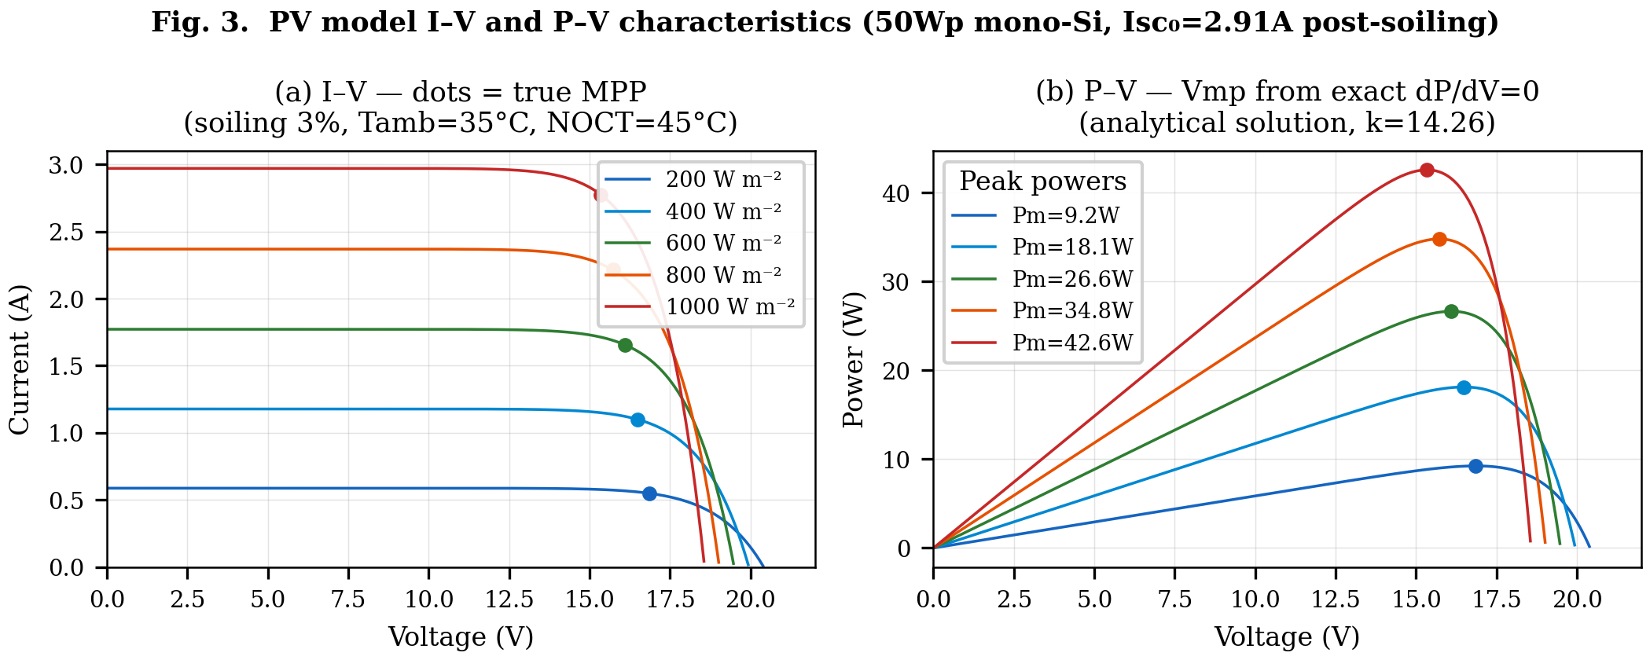
Figures/figures_python/FIG3/output/fig3_iv_curves.png
