touhidsiddiqueeraj-bit/artemis-helios/Figures/figures_python/fig3_iv_curves.png

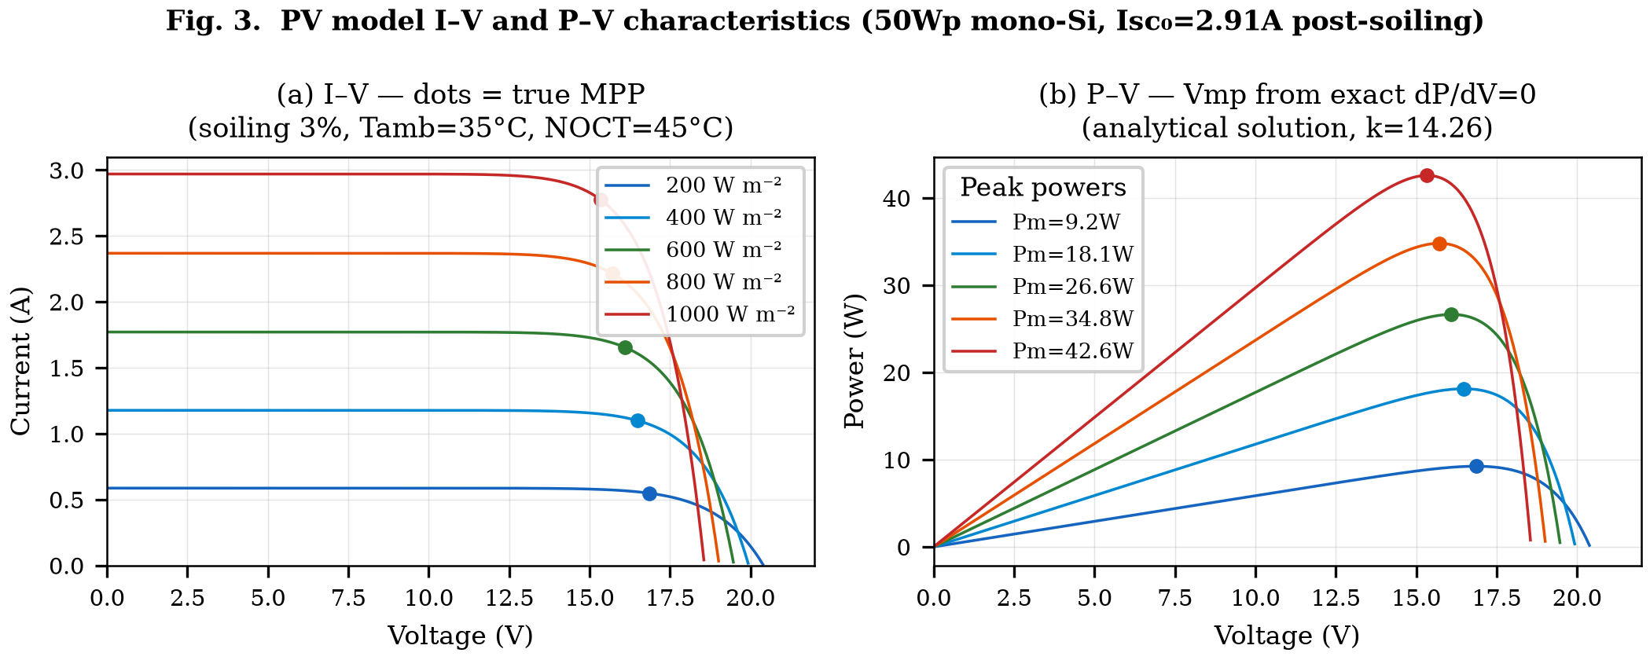
Figures/figures_python/fig3_iv_curves.png
