touhidsiddiqueeraj-bit/artemis-helios/Figures/figures_python/FIG4/output/fig4_lstm.png

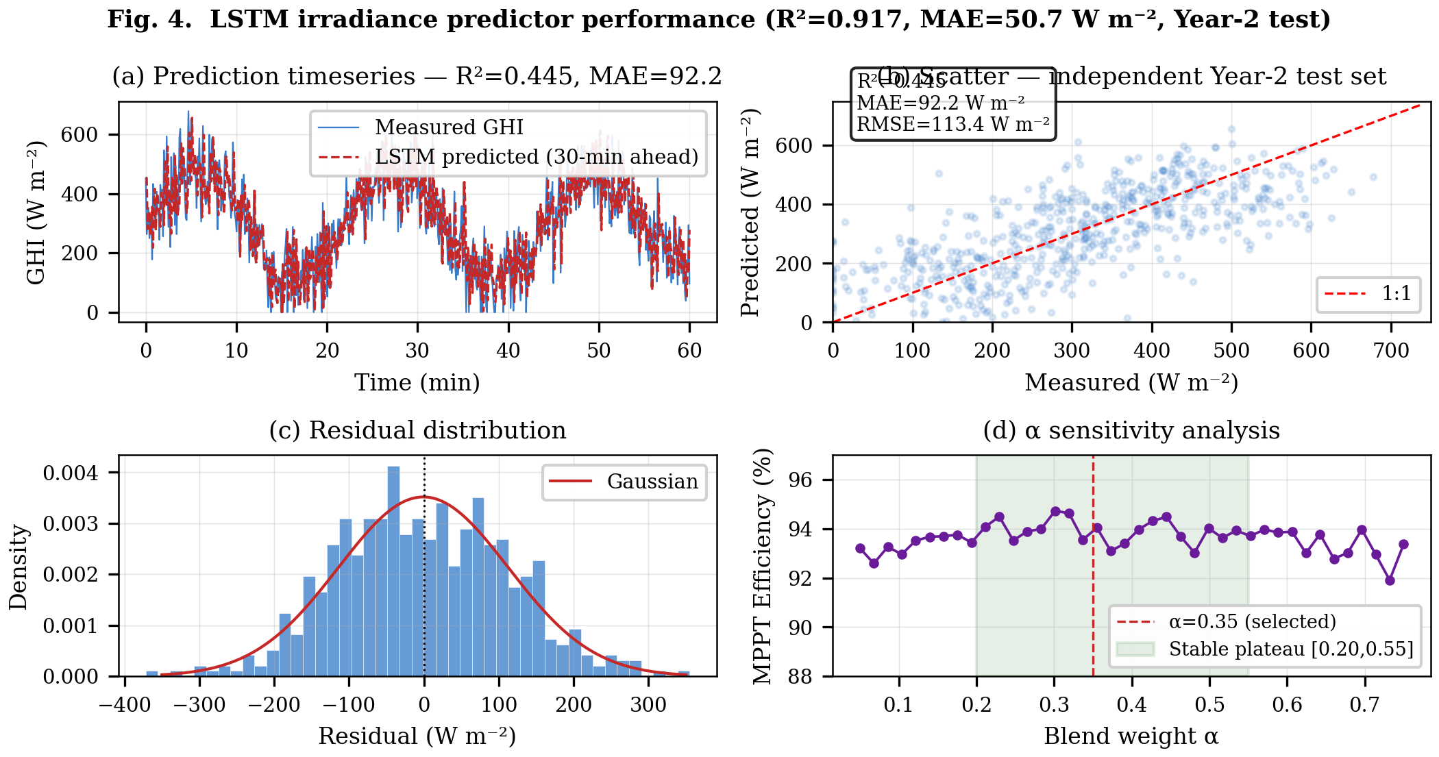
Figures/figures_python/FIG4/output/fig4_lstm.png
