touhidsiddiqueeraj-bit/artemis-helios/Figures/figures_python/fig6_comparison.png

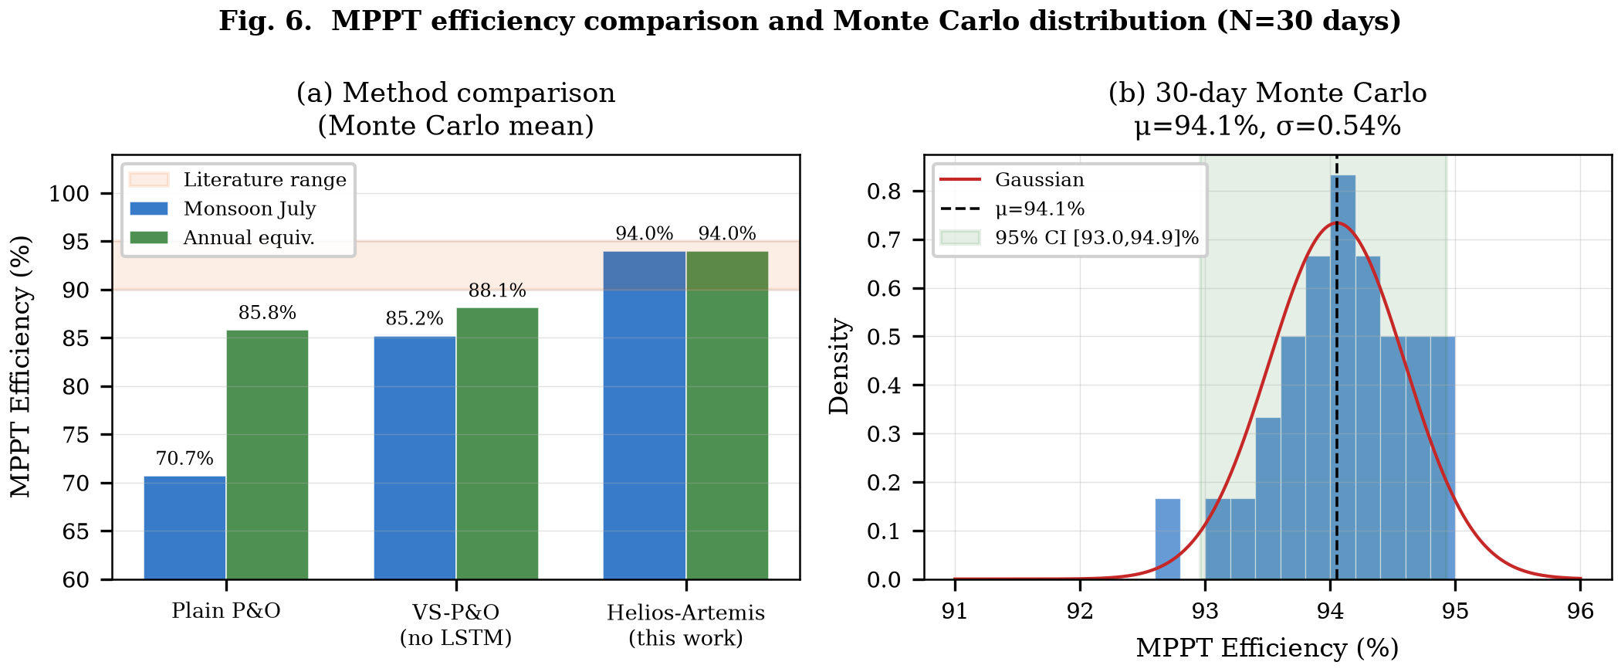
Figures/figures_python/fig6_comparison.png
