touhidsiddiqueeraj-bit/artemis-helios/Figures/figures_python/FIG7/output/fig7_po_convergence.png

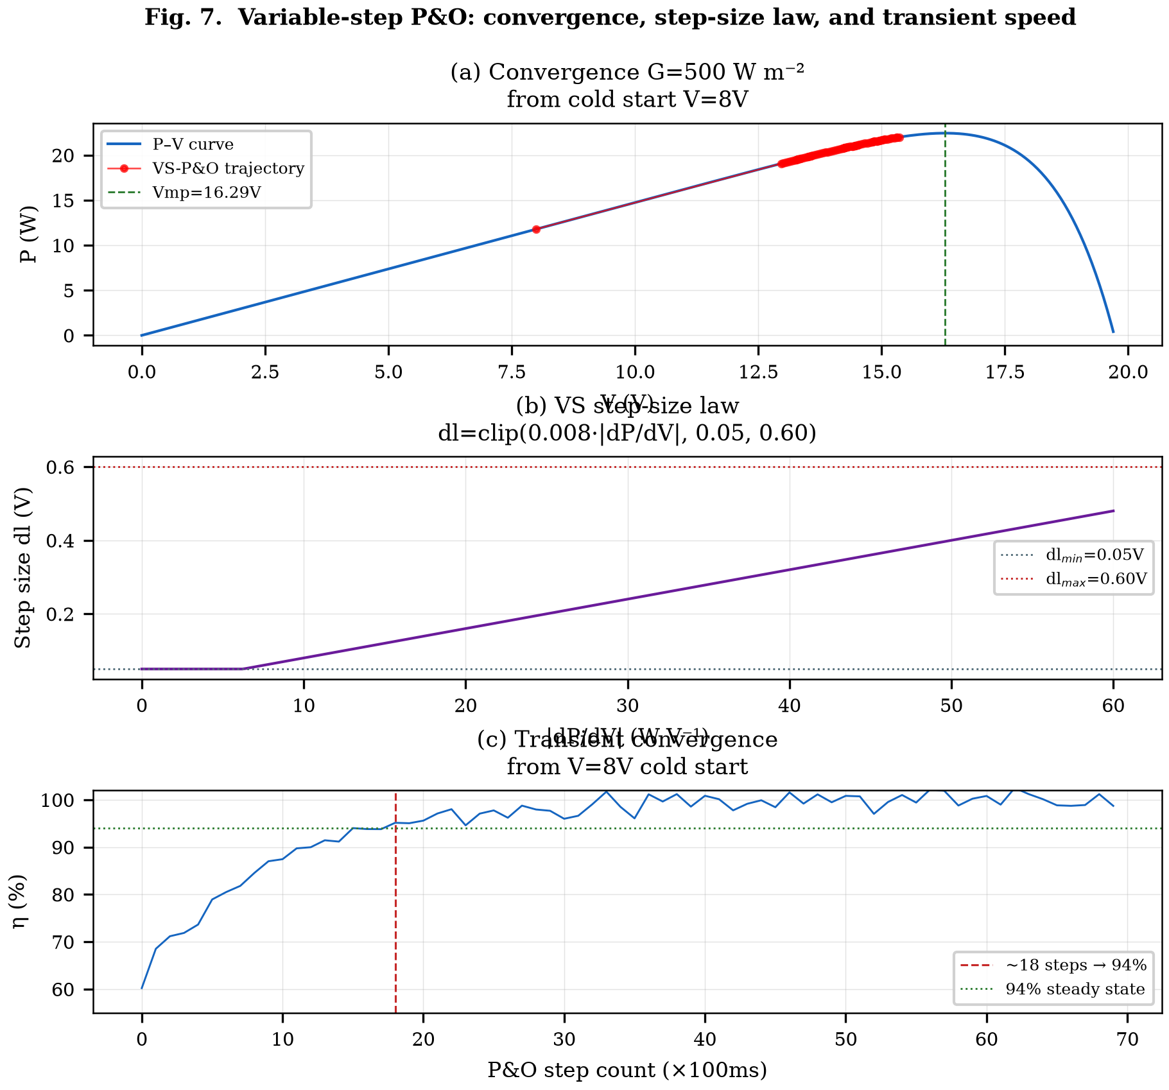
Figures/figures_python/FIG7/output/fig7_po_convergence.png
