touhidsiddiqueeraj-bit/artemis-helios/Figures/figures_python/fig7_po_convergence.png

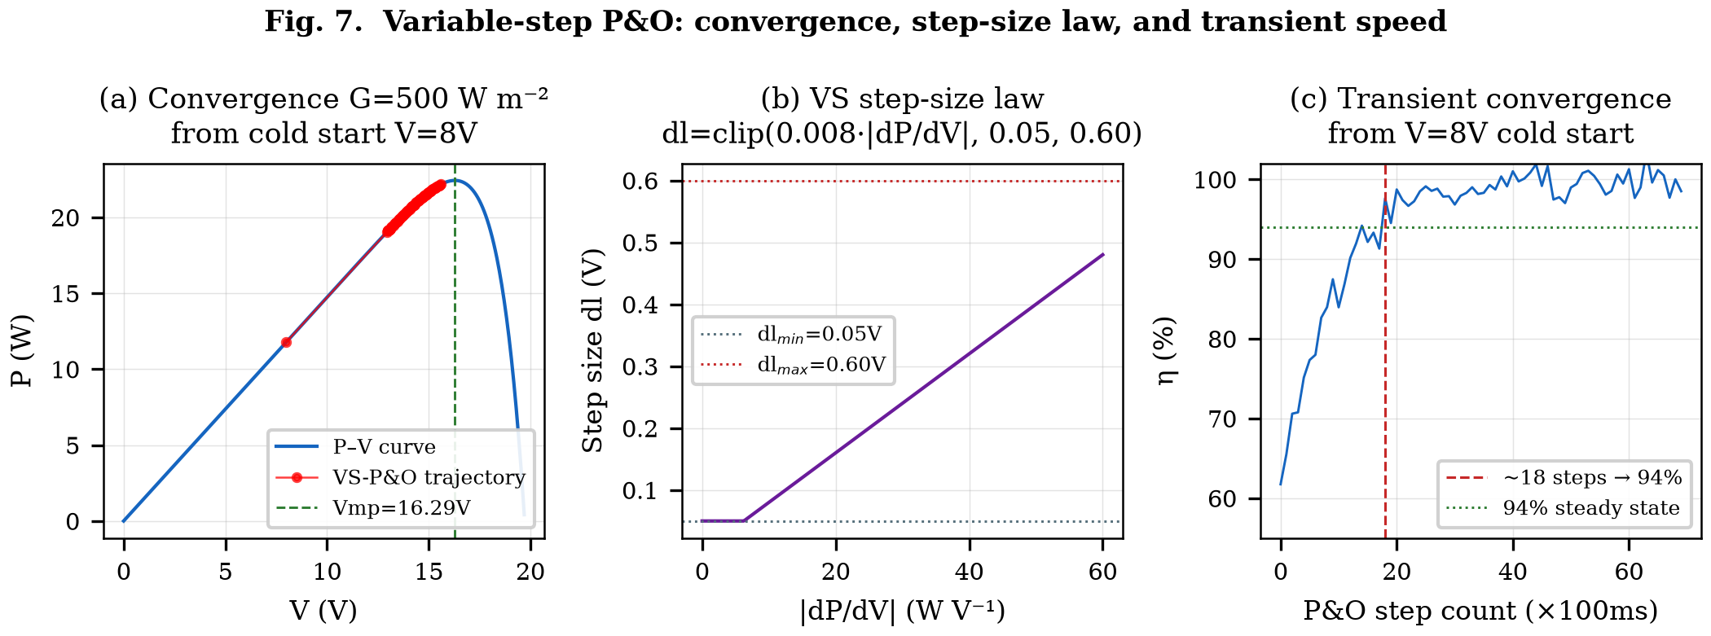
Figures/figures_python/fig7_po_convergence.png
