touhidsiddiqueeraj-bit/artemis-helios/Figures/figures_python/graphical_abstract.png

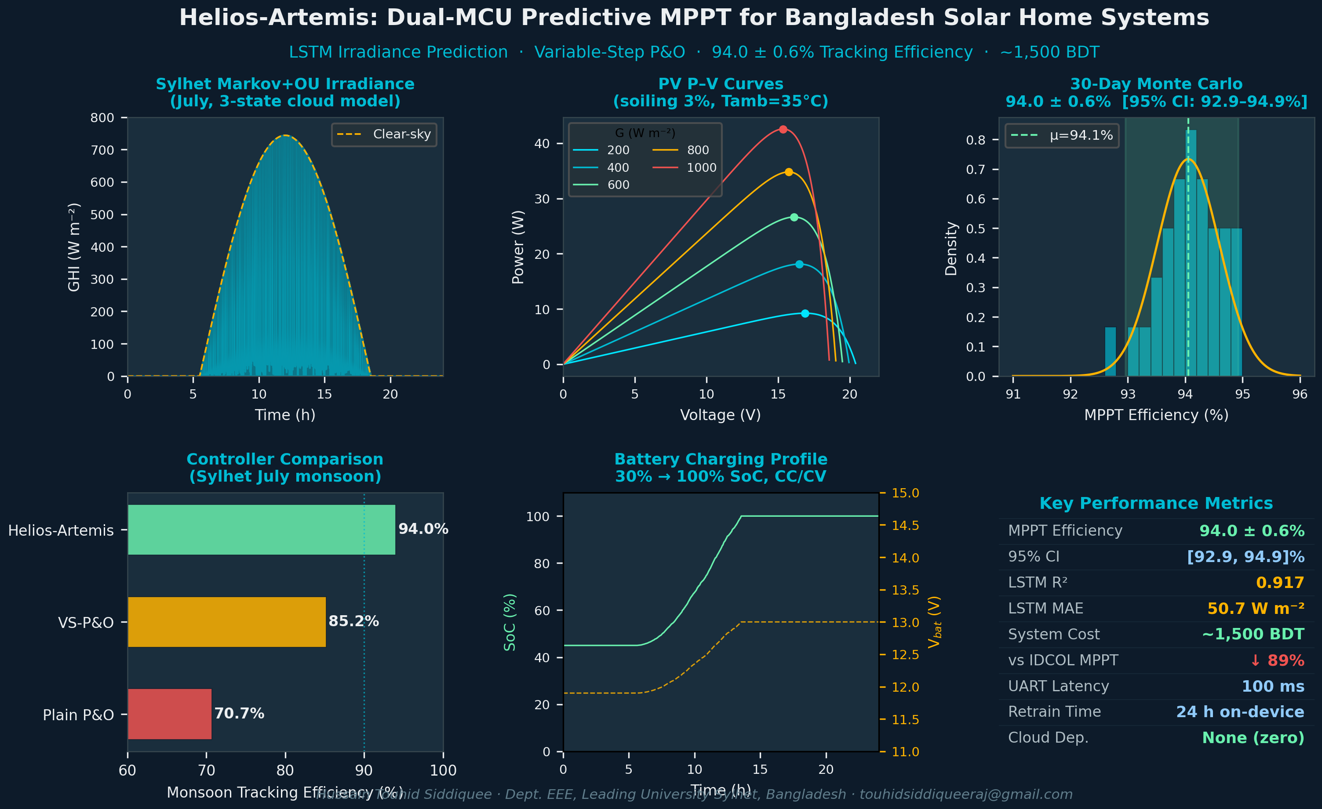
Figures/figures_python/graphical_abstract.png
