touhidsiddiqueeraj-bit/artemis-helios/Figures/MATLAB Figures/batteryandtherman.png

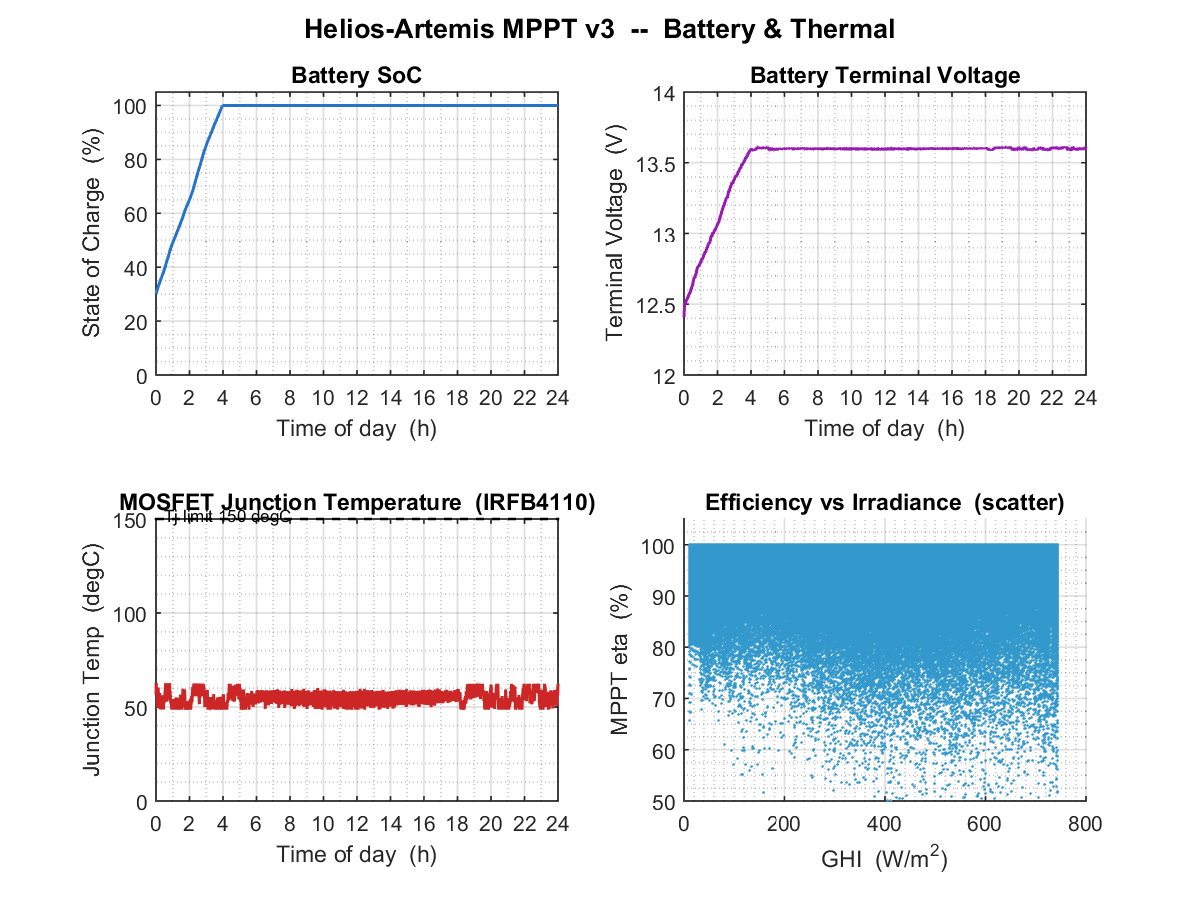
Figures/MATLAB Figures/batteryandtherman.png
