touhidsiddiqueeraj-bit/artemis-helios/Figures/MATLAB Figures/dailysummary.png

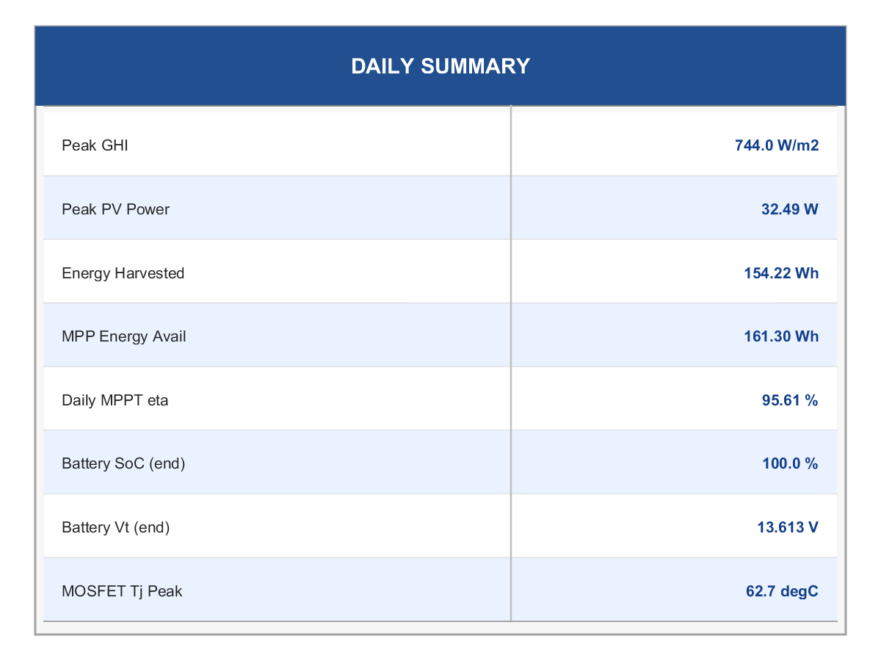
Figures/MATLAB Figures/dailysummary.png
