touhidsiddiqueeraj-bit/artemis-helios/Figures/MATLAB Figures/energysummary.png

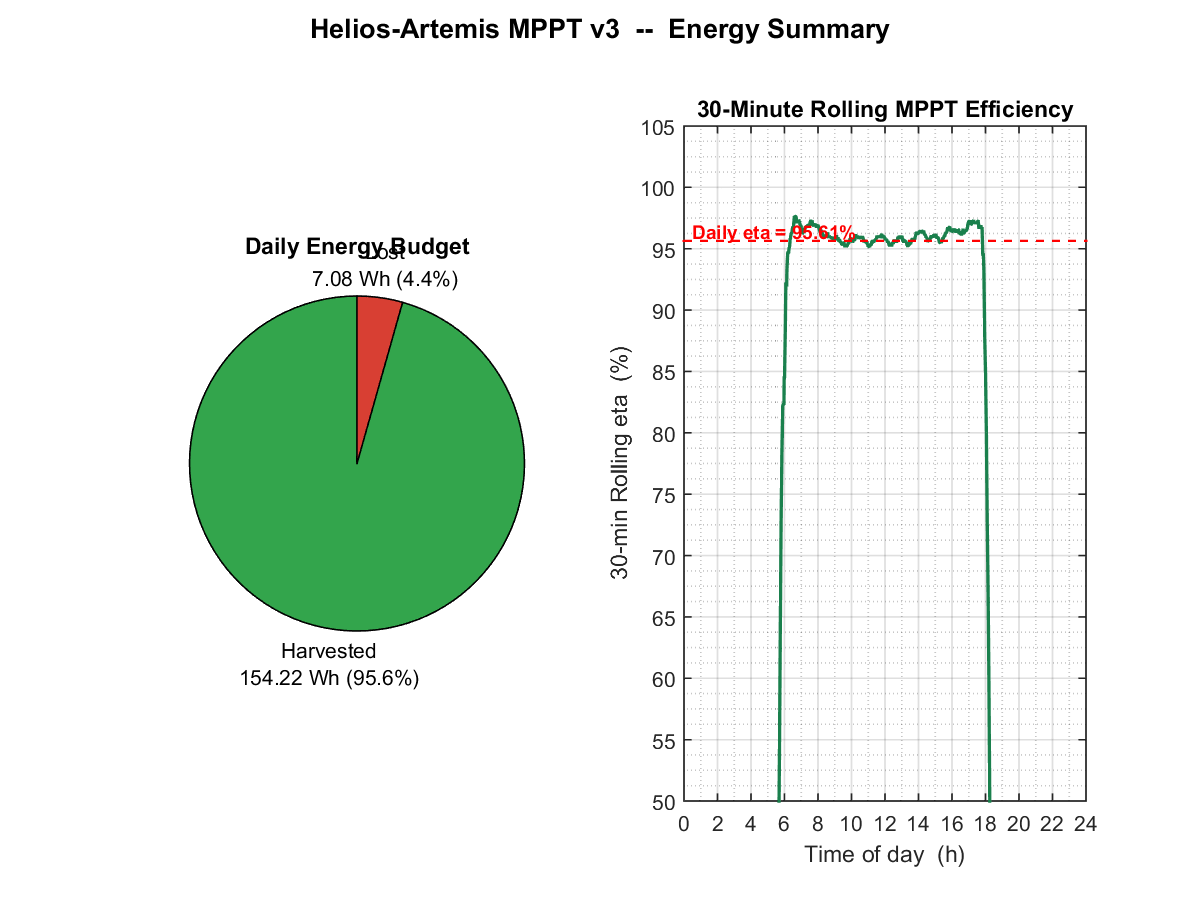
Figures/MATLAB Figures/energysummary.png
