touhidsiddiqueeraj-bit/artemis-helios/Figures/MATLAB Figures/singledaysimulation.PNG

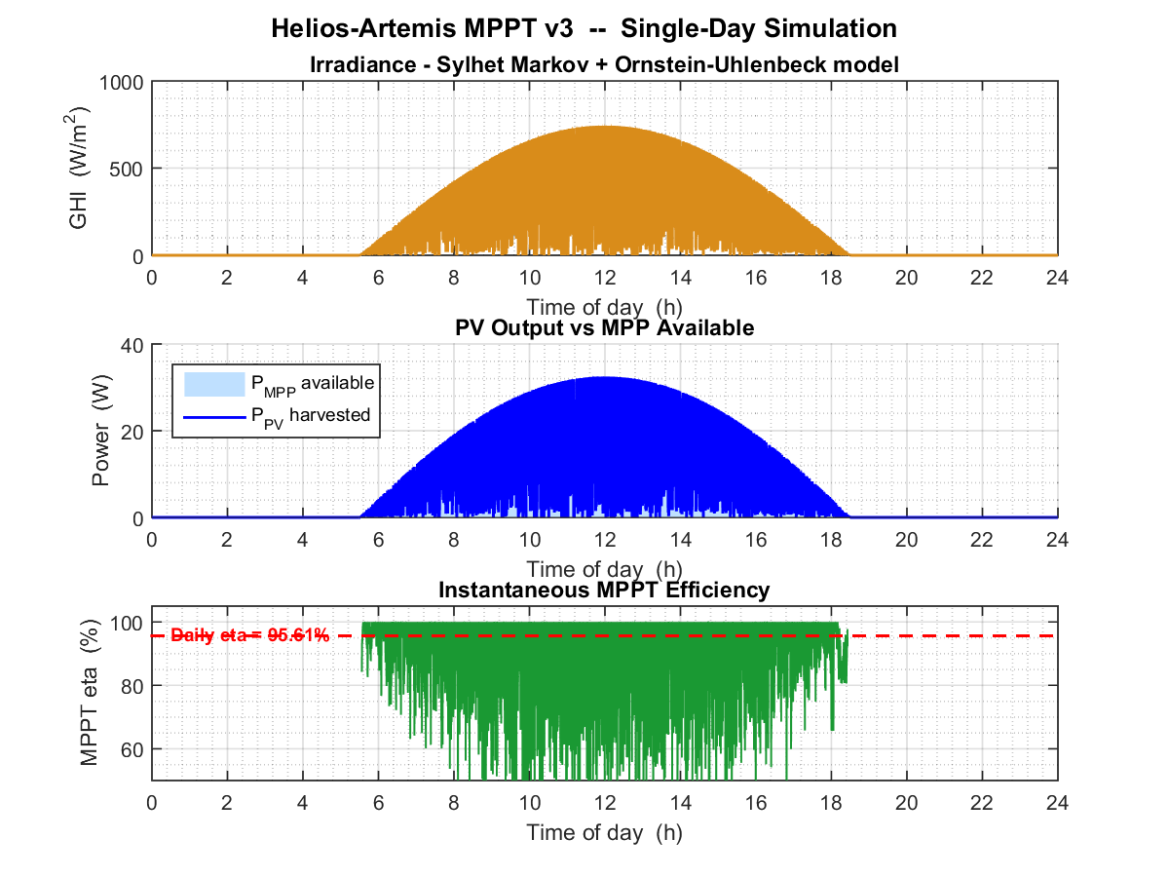
Figures/MATLAB Figures/singledaysimulation.PNG
