touhidsiddiqueeraj-bit/artemis-helios/Helios_Logger/helios-logger/helios_logger/Circuiit_Diagram.png

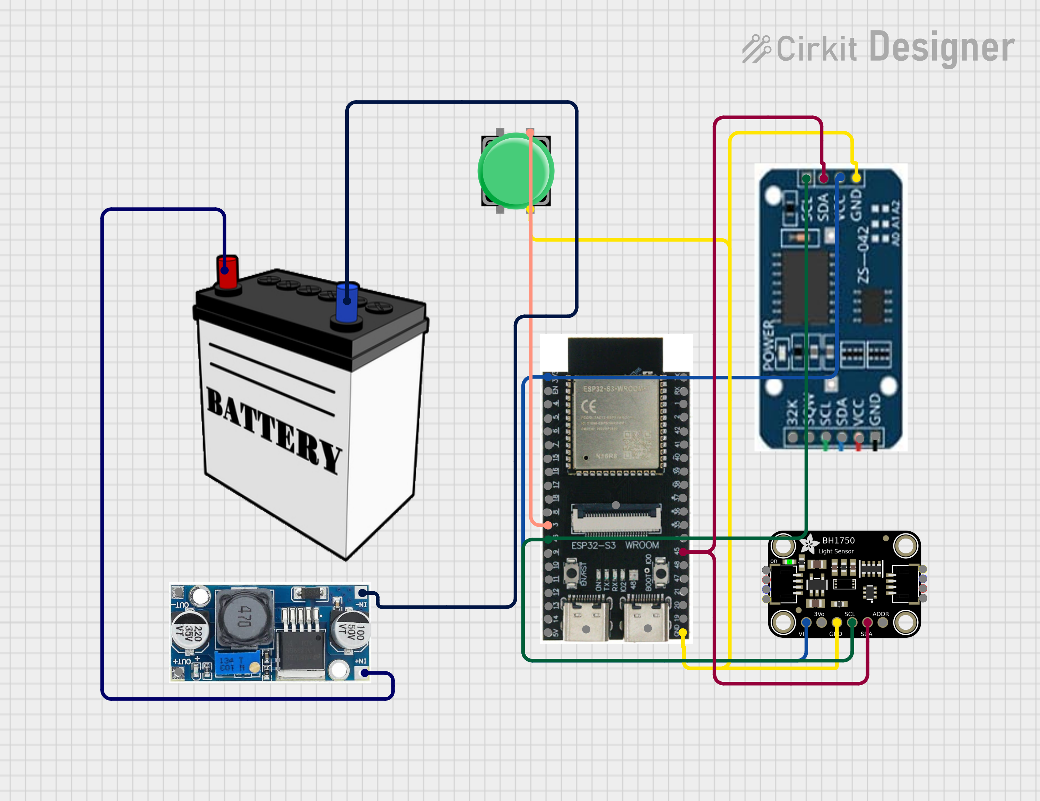
Helios_Logger/helios-logger/helios_logger/Circuiit_Diagram.png
