touhidsiddiqueeraj-bit/artemis-helios/prototype/schematics/prototype_pcb.png

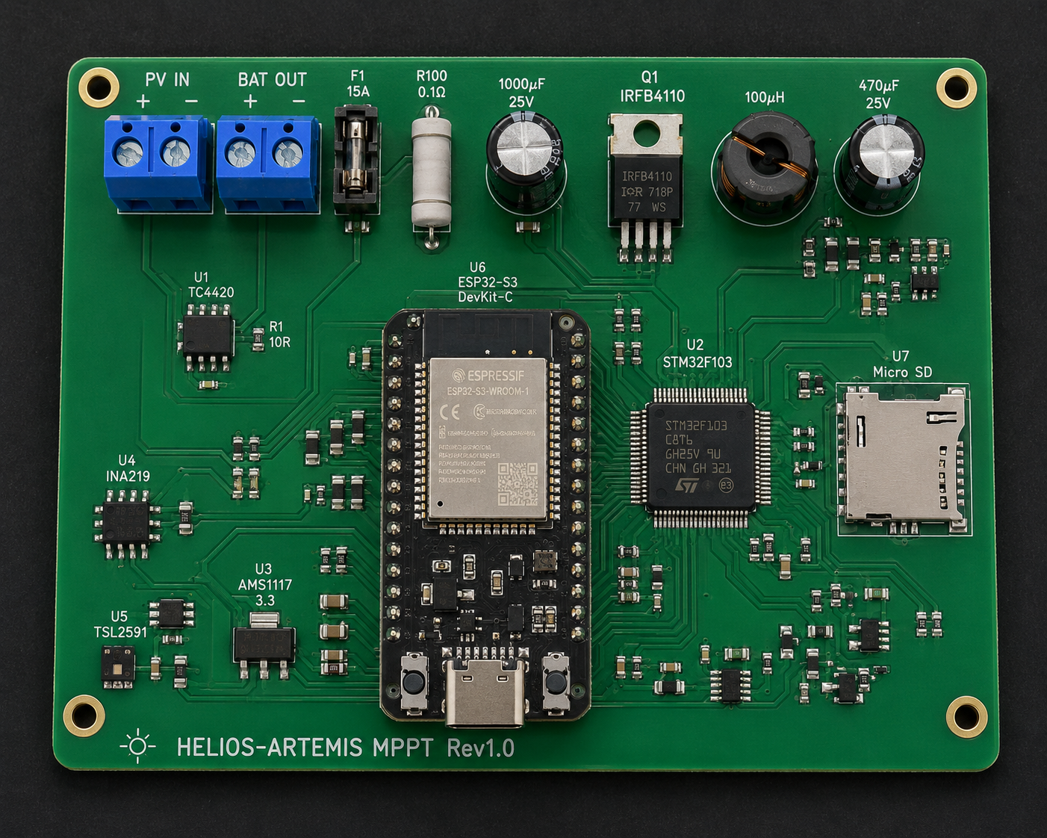
prototype/schematics/prototype_pcb.png
