touhidsiddiqueeraj-bit/artemis-helios/Docs/Study_materials/helios_artemis_primer.docx

Understanding Helios-Artemis

A Self-Contained Primer on Solar Energy, MPPT, LSTM, and Embedded Systems

From first principles to understanding the paper

Prepared as a companion study guide

# Table of Contents

# Chapter 1: Electricity and Solar Energy Basics

Before we can understand how the Helios-Artemis controller works, we need a firm foundation in the physics of electricity and how solar panels generate it. This chapter covers the absolute basics — no prior knowledge assumed.

## 1.1 What Is Electricity?

Electricity is the flow of electric charge — specifically, the movement of electrons through a conductor. To understand electricity, you need to know three key quantities:

Voltage (V): The electrical 'pressure' that pushes electrons through a circuit. Measured in Volts (V). A higher voltage means a stronger push.

Current (I): The rate at which electrons actually flow. Measured in Amperes (A), often just 'Amps'. Think of it as how many electrons per second are moving past a point.

Power (P): The rate at which energy is delivered or consumed. Measured in Watts (W). Calculated as: Power = Voltage × Current, or P = V × I.

There is a third important concept — resistance (R), measured in Ohms (Ω) — which describes how much a material opposes the flow of current. Ohm's Law ties all three together: V = I × R. For our purposes, the most important relationship is the power equation: P = V × I.

## 1.2 Direct Current vs. Alternating Current

Solar panels produce Direct Current (DC) — electrons flow in one direction only, like water flowing steadily through a pipe. The grid electricity in your home is Alternating Current (AC) — electrons reverse direction 50 or 60 times per second. Solar Home Systems in Bangladesh typically use DC power throughout (for LED lights and phone charging), though an inverter can convert DC to AC for appliances.

## 1.3 How a Solar Panel Works

A solar panel is made of photovoltaic (PV) cells. PV cells are made from semiconductor materials — usually silicon. Here is how they convert sunlight to electricity:

- Photons (particles of light) from the sun strike the silicon.
- This energy is enough to knock electrons loose from their atoms.
- The structure of the PV cell creates an internal electric field that pushes these free electrons in one direction.
- Metal contacts on the cell collect these moving electrons — this is electric current.
- The 'pressure' driving them (voltage) comes from the internal field.

Multiple PV cells are wired together to form a module (what we call a 'solar panel'). Multiple modules can be wired together to form an array. More cells in series = higher voltage. More cells in parallel = higher current.

## 1.4 Irradiance: The Fuel of Solar Panels

Irradiance is the measure of the power of sunlight hitting a surface, measured in Watts per square metre (W/m²). It is the single most important factor determining how much electricity a solar panel generates.

Condition | Typical Irradiance
Direct sunlight (clear noon) | ~1000 W/m² — this is called 'peak sun'
Partly cloudy | 200–600 W/m²
Heavy overcast | 50–150 W/m²
Sylhet July average | ~744 W/m² peak (aerosol-capped)
During cloud shadow | Can drop to 50 W/m² in seconds

The Helios-Artemis paper focuses specifically on the rapid irradiance changes caused by monsoon cloud transients. When a cloud shadow suddenly sweeps over a panel, irradiance can drop from 700 W/m² to 80 W/m² in under one second. This is the root cause of the tracking problem the paper solves.

## 1.5 The I–V Curve: Understanding Maximum Power Point

For any given irradiance level, a solar panel has a characteristic I–V curve — a graph showing how current (I) changes as voltage (V) changes. The key features are:

Short-circuit current (Isc): The maximum current when voltage is zero (panel is short-circuited). Directly proportional to irradiance.

Open-circuit voltage (Voc): The maximum voltage when current is zero (circuit is open). Weakly affected by irradiance, strongly affected by temperature.

Maximum Power Point (MPP): The specific voltage and current combination that produces the most power. Not at the extremes — it is in the middle of the curve.

Fill Factor (FF): How 'square' the I-V curve is. Higher = better. Real panels are around 0.75–0.85.

The 50 Wp monocrystalline panel used in the Helios-Artemis simulation has Isc of 2.91 A (post-soiling) and a fill-factor constant k = 14.26. These numbers determine exactly where the MPP sits on the curve at any irradiance level.

# Chapter 2: Maximum Power Point Tracking (MPPT)

MPPT is the technology that keeps a solar panel operating at its maximum power point despite continuously changing conditions. This chapter explains how the standard algorithms work, why they fail in monsoon conditions, and what 'tracking efficiency' actually means.

## 2.1 Why MPPT Is Necessary

Without MPPT, a solar panel is simply connected to a battery or load. The operating voltage is determined by the load — and it is almost never the voltage at which the panel produces maximum power. Studies show that without MPPT, 20–40% of available solar energy is wasted.

An MPPT controller sits between the panel and the battery. It continuously adjusts the 'impedance' seen by the panel, forcing the panel to operate at its MPP regardless of what the battery voltage is. This requires a DC-DC converter (like the buck converter in Artemis).

## 2.2 Perturb-and-Observe (P&O)

P&O is the most common MPPT algorithm in low-cost controllers because it is simple to implement and requires no knowledge of the panel's characteristics. The algorithm works like this:

- Measure current power: P_old = V × I.
- Perturb (shift) the operating voltage slightly — either increase or decrease by a fixed step size.
- Measure new power: P_new = V_new × I_new.
- If P_new > P_old: good move, keep going in the same direction.
- If P_new < P_old: bad move, reverse direction.
- Repeat every 100 milliseconds (or similar interval).

This works well under stable sunlight. The problem is that it is fundamentally reactive: the algorithm only knows the irradiance has changed after the power has already dropped. Under a fast cloud transient, the irradiance may change multiple times before the algorithm even finishes responding to the first change.

## 2.3 Variable-Step P&O (VS-P&O)

A refinement of basic P&O: instead of a fixed step size, the step size is proportional to how rapidly power is changing. The formula used in Artemis is:

step = clip(0.008 × |dP/dV|, 0.05, 0.60) Volts

This means: when power is changing rapidly (large |dP/dV|), take big steps to converge faster. When near the MPP (small |dP/dV|), take tiny steps to minimise oscillation. The Artemis implementation converges from a cold start in approximately 18 steps (~1.8 seconds).

VS-P&O is better than basic P&O but still reactive — it responds faster, but it cannot anticipate changes.

## 2.4 Incremental Conductance (IncCond)

Another common algorithm. It uses calculus to determine the exact direction to the MPP without needing to observe the result of a perturbation. At the MPP, the derivative of power with respect to voltage is zero: dP/dV = 0. This can be rewritten as: dI/dV = -I/V.

IncCond computes this derivative continuously and adjusts voltage accordingly. It is more accurate than P&O under slow conditions, but similarly struggles during fast transients. The Helios-Artemis Monte Carlo results show IncCond achieving 85.3% monsoon efficiency — slightly better than plain P&O (70.7%) but far below Helios-Artemis (94.0%).

## 2.5 Tracking Efficiency: The Key Metric

Tracking efficiency is defined as:

η_MPPT = (Energy actually harvested) ÷ (Energy at perfect MPP tracking) × 100%

Perfect tracking (100%) is theoretical — a real controller is always slightly off the true MPP due to the finite step size and measurement noise. The relevant comparison is not between controllers and perfection, but between different controllers under the same conditions.

Algorithm / Condition | Tracking Efficiency
Plain P&O (clear sky) | ~86%
Plain P&O (Sylhet monsoon) | 70.7%
Incremental Conductance (monsoon) | 85.3%
Helios-Artemis (monsoon, 30-day Monte Carlo mean) | 94.0% ± 0.6%
Helios-Artemis (clear sky) | ~95.7%

The +23.3 percentage point improvement over plain P&O during monsoon conditions is the central result of the paper.

# Chapter 3: Neural Networks and LSTM — The AI Component

The Helios subsystem runs a Long Short-Term Memory (LSTM) neural network to predict future irradiance. This chapter builds up from the very basics of neural networks to explain what LSTM is, why it was chosen, and what the paper's accuracy metrics mean.

## 3.1 What Is a Neural Network?

A neural network is a mathematical model loosely inspired by how neurons in the brain connect. It consists of layers of simple mathematical units (neurons) that transform an input into an output through a series of learned calculations.

Neuron: A function that takes several numbers as input, multiplies each by a learned weight, sums them up, adds a bias, then applies an activation function.

Layer: A group of neurons that all receive the same inputs. A network has an input layer, hidden layers, and an output layer.

Weights and biases: The numbers the network learns during training. Training adjusts these to minimise prediction error.

Training: Showing the network many input/output examples and adjusting weights so it learns the underlying pattern.

A feedforward neural network processes information in one direction only — input flows through each layer to the output. Each layer extracts increasingly abstract features from the data. The network has no memory between inputs.

## 3.2 Why Normal Neural Networks Fail for Time-Series

Solar irradiance is a time series — a sequence of measurements over time. Whether the next minute will be cloudy depends heavily on what the past hour looked like. A feedforward network has no concept of 'the past'. It treats each input as independent, making it poorly suited for sequences where context matters.

You could feed it a window of past values (e.g., the last 24 hours of irradiance readings), but it cannot naturally capture how patterns evolve over time — it just sees 288 numbers with no notion of their order or causal relationships.

## 3.3 Recurrent Neural Networks (RNNs)

Recurrent Neural Networks (RNNs) solve this by adding a feedback loop: the output (or a hidden state) from processing one time step is fed back as an extra input at the next time step. This gives the network a form of memory.

However, vanilla RNNs suffer from the vanishing gradient problem: when training on long sequences, the error signal (gradient) used to adjust weights shrinks exponentially as it propagates back through time. This means the network cannot reliably learn patterns that span more than a few time steps.

## 3.4 Long Short-Term Memory (LSTM)

LSTM, invented by Hochreiter and Schmidhuber in 1997, solves the vanishing gradient problem through a special architecture with explicit memory management. Each LSTM unit has:

Cell state (C_t): A 'conveyor belt' that carries information across long time spans with minimal transformation. This is the long-term memory.

Forget gate: Decides what fraction of the cell state to erase. Controlled by a learned sigmoid function (output 0–1). 0 = forget everything, 1 = keep everything.

Input gate: Decides what new information to write into the cell state.

Output gate: Decides what part of the cell state to output as the hidden state h_t — the short-term memory used by the next layer.

The gates are controlled by small neural networks themselves, whose weights are learned during training. The result is a unit that can selectively remember, forget, and output information across hundreds of time steps — far beyond what a vanilla RNN can manage.

Intuition | Think of the cell state as a notebook. The forget gate is the eraser. The input gate is the pen. The output gate is your decision about which part of the notebook to read aloud at each step. LSTM learns when to write, when to erase, and what to say.

## 3.5 The Helios LSTM Architecture

The Helios subsystem uses a dual-model LSTM architecture — two separate small networks with distinct jobs:

Model | Size | Function
Irradiance forecaster | 32 LSTM units, 1 layer 7,329 parameters | Takes 24 hours of past GHI readings (288 time steps at 5-min intervals), outputs a 30-minute-ahead irradiance prediction.
Gain scheduler | 4 LSTM units 101 parameters | Takes the predicted irradiance, outputs the optimal P&O step scaling factor — how aggressive the tracking should be given the forecast.

Total: ~4,486 parameters. This is tiny compared to modern AI models — GPT-4 has approximately 1.8 trillion parameters. But tiny is the point: this model must run on a microcontroller with limited memory.

Why 32 units rather than 64? The 64-unit model improves R² by only 1.7 percentage points, but requires 3× more parameters and takes 37 ms to run inference — too slow for the 100 ms UART synchronisation window. The 32-unit model runs inference in under 12 ms (4.7 ms with INT8 quantisation).

## 3.6 Training and On-Device Retraining

The LSTM is trained on 24 hours of locally logged irradiance data. Training happens via TensorFlow.js (TF.js) in a browser session on the local Wi-Fi network served by the ESP32-S3 — no internet required. After training, weights are exported to the ESP32-S3, which performs silent 14-day on-device retraining cycles.

This is the cloud-independence property that makes Helios-Artemis viable for rural Bangladesh: the model adapts to local conditions without ever needing a cellular or internet connection.

## 3.7 Understanding the Accuracy Metrics

The paper reports three accuracy metrics for the LSTM predictor on the Year-2 independent test set. It is important to understand what each means:

R² (R-squared, coefficient of determination): Measures what fraction of the variance in the actual values is explained by the predictions. Range: 0 to 1 (higher is better). R² = 1 means perfect predictions. R² = 0 means the model is no better than always predicting the mean. R² = 0.917 means the model explains 91.7% of the variation in irradiance — the remaining 8.3% is unpredictable noise or residual error.

MAE (Mean Absolute Error): The average of (predicted – actual) across all predictions. Daytime MAE = 50.7 W/m² means that on average during daylight hours, the prediction is off by about 51 W/m². Since peak irradiance is ~744 W/m², this is roughly 7% average error.

RMSE (Root Mean Square Error): Similar to MAE but squares the errors first, then takes the square root. This penalises large errors more heavily. RMSE = 63.6 W/m² (larger than MAE because large errors are counted more).

## 3.8 What TinyML Means

TinyML refers to deploying machine learning models on microcontrollers and other very-constrained hardware. Standard ML frameworks (PyTorch, TensorFlow) require gigabytes of RAM and modern CPUs. TinyML uses techniques such as:

- Quantisation: converting 32-bit floating point weights to 8-bit integers (INT8). This reduces model size by 4× and inference time from 12 ms to 4.7 ms on the ESP32-S3, with only ΔR² = −0.009 accuracy loss.
- Pruning: removing weights that are near zero and contribute little to accuracy.
- Distillation: training a small model to mimic a larger one.

The Helios LSTM fits within the ESP32-S3's 512 kB SRAM with room to spare, even without INT8 quantisation.

# Chapter 4: Embedded Systems and Microcontrollers

The Helios-Artemis controller uses two microcontrollers. This chapter explains what a microcontroller is, how the two MCUs in this system differ, and how they communicate.

## 4.1 What Is a Microcontroller?

A microcontroller (MCU) is a compact integrated circuit containing a processor (CPU), memory (RAM and Flash), and programmable input/output peripherals — all on a single chip. Unlike a general-purpose computer, a microcontroller runs a single dedicated program and interacts directly with the physical world through its GPIO pins.

CPU: The processor that executes instructions. Speed measured in MHz (millions of cycles per second).

RAM (SRAM): Fast memory for running programs. Volatile — lost when powered off.

Flash memory: Non-volatile storage for the program code. Retained when powered off.

GPIO: General Purpose Input/Output pins. Can read sensors, drive LEDs, control motors, etc.

Peripherals: Built-in hardware blocks — UART, SPI, I2C, ADC, PWM — that handle common tasks without software overhead.

## 4.2 The Two MCUs in Helios-Artemis

Property | ESP32-S3 vs STM32F103
Full name | ESP32-S3 (Helios) | STM32F103 (Artemis)
Manufacturer | Espressif Systems | STMicroelectronics
Clock speed | 240 MHz dual-core | 72 MHz Cortex-M3
RAM | 512 kB SRAM | 20 kB SRAM
Role | AI inference, data logging, web dashboard, on-device retraining | Real-time power control, 50 kHz PWM, battery charging
Why this MCU? | Dual-core allows one core for WiFi/web, another for LSTM. Large SRAM fits the model. | Cortex-M3 is deterministic and fast — critical for precise 50 kHz switching. Very low cost (~120 BDT).

The fundamental reason for using two MCUs is timing isolation: LSTM inference can take 4–12 ms and is non-deterministic in duration. If inference ran on the same MCU as the PWM controller, it might cause jitter in the switching frequency — leading to power conversion inefficiency or even component damage. By isolating them on separate chips communicating via UART, inference latency is completely decoupled from the control loop.

## 4.3 UART Communication

UART (Universal Asynchronous Receiver-Transmitter) is one of the simplest serial communication protocols. Two devices are connected with three wires: TX (transmit), RX (receive), and GND (ground). Both devices agree on a data rate (baud rate) in advance.

In Helios-Artemis, Helios sends a predicted irradiance value to Artemis every 100 ms. Artemis uses this to blend the predicted MPP voltage into its control loop. The 100 ms interval was chosen because it matches the P&O perturbation interval — so every perturbation cycle, Artemis has fresh prediction data.

## 4.4 PWM: Controlling the Buck Converter

PWM (Pulse Width Modulation) is a technique for controlling the average voltage delivered to a load by rapidly switching a signal on and off. The key parameter is the duty cycle: the fraction of each cycle that the signal is HIGH.

Average voltage = Duty cycle × Supply voltage

The STM32F103 generates a 50 kHz PWM signal. This means it switches 50,000 times per second — the switch is on and off in 20 microseconds per cycle. By adjusting the duty cycle, Artemis controls the voltage the buck converter presents to the solar panel, effectively setting the operating point on the I–V curve.

## 4.5 The Buck Converter

A buck (step-down) converter is a DC-DC converter that takes a higher input voltage and produces a lower, regulated output voltage — efficiently, using inductive energy storage rather than wasting energy as heat (like a linear voltage regulator would).

The Artemis power stage uses:

- IRFB4110 MOSFET (VDS = 60 V, RDS(on) = 28 mΩ): the main switch, driven at 50 kHz by the TC4420 gate driver IC.
- 100 μH inductor: stores energy magnetically while the switch is on, releases it when the switch is off.
- 470 μF capacitor: smooths the output voltage ripple.
- INA219 current/voltage sensor (I2C, 12-bit): monitors the battery bus for CC/CV charging control.

## 4.6 Three-Stage Battery Charging

Lead-acid batteries (common in rural SHS) require a specific charging profile to maximise lifetime:

Stage | Mode | Description
Bulk (CC) | Constant Current at 6 A | Charge as fast as possible until battery reaches 14.7 V. SoC rises from ~20% to ~80%.
Absorption (CV) | Constant Voltage at 14.7 V | Hold voltage constant. Current tapers as battery fills. Stop when current drops below 0.5 A tail.
Float | Constant Voltage at 13.8 V | Maintain charge without overcharging. Compensates for self-discharge.

Artemis manages all three stages autonomously using the INA219 measurements. This is completely independent of the MPPT tracking — both functions run concurrently.

# Chapter 5: Statistics and Simulation Methods

The Helios-Artemis paper is entirely simulation-based. To evaluate its claims fairly, you need to understand the statistical methods used to validate the results.

## 5.1 Why Simulate?

Hardware prototyping is expensive and time-consuming. Simulation allows rapid iteration: the irradiance model can generate an entire year of Sylhet weather conditions in seconds, and the MPPT algorithm can be tested across 30 different 'days' with different cloud patterns without waiting for 30 days of real weather. Simulation is a standard and accepted research methodology, provided the simulation model is well-calibrated against real data.

## 5.2 The Irradiance Simulation Model

The paper builds a synthetic irradiance generator calibrated to Sylhet's real climate. It incorporates four physical realism layers:

Layer | Type | Description
R1 | Ornstein-Uhlenbeck flicker | Sub-second random fluctuations with τ = 1 s and σ = 25%. Calibrated from Lave & Kleissl 2010. Simulates cloud edges passing over the panel.
R2 | Aerosol / haze attenuation | Multiplies irradiance by 0.93 to account for Bangladesh's air quality (Linke turbidity TL ≈ 4.5). Caps peak GHI at ~744 W/m² instead of theoretical 1000.
R3 | ADC sensor noise | Adds realistic measurement noise from the INA219 sensor and switching EMI: σ_I = 2 mA, σ_V = 10 mV.
R4 | Panel soiling | Reduces Isc by 3% to simulate dust accumulation, with a monthly cleaning cycle reset.

The cloud pattern is modelled as a Markov chain: the 'cloud state' (clear, partly cloudy, overcast) transitions between states with probabilities derived from Sylhet meteorological records (NASA POWER + SREDA data). Within each state, the OU process generates the second-to-second fluctuations.

## 5.3 What Is a Markov Chain?

A Markov chain is a mathematical model of a system that transitions between states randomly, where the probability of the next state depends only on the current state (not on history). For example:

By simulating this Markov chain forward in time, the model generates a plausible sequence of cloud states across a day, month, or year — statistically representative of Sylhet's monsoon climate without being a recording of any specific day.

## 5.4 What Is Ornstein-Uhlenbeck Noise?

The Ornstein-Uhlenbeck (OU) process is a type of random noise that mean-reverts: it tends to drift back toward a central value over time, rather than wandering indefinitely. Two parameters govern it:

τ (tau, mean reversion time): How quickly the noise reverts to its mean. τ = 1 s means that deviations decay with a time constant of 1 second — appropriate for cloud shadows that pass quickly.

σ (sigma, volatility): The standard deviation of the noise. σ = 25% means that irradiance fluctuates with a standard deviation of 25% around its current cloud-state value.

This is more realistic than simple Gaussian noise because it captures the temporal autocorrelation of real irradiance — one cloudy moment tends to be followed by another cloudy moment, and clear periods tend to cluster.

## 5.5 Monte Carlo Simulation

Monte Carlo simulation runs the same scenario many times with different random seeds — different sequences of random events — to characterise the distribution of outcomes rather than a single outcome.

The Helios-Artemis paper runs 30 independent July days (30 different Markov random seeds). Instead of reporting 'the controller achieved X% efficiency on one specific day', it reports:

- Mean η_MPPT = 94.0% — the average across all 30 days
- Standard deviation σ = 0.6% — how much the result varied day to day
- 95% Confidence Interval: [92.9%, 94.9%] — the range within which the true mean lies with 95% probability

This is far more rigorous than a single-day result because it shows that the performance is consistent — not the result of one lucky day with mild cloud transients.

## 5.6 Confidence Intervals Explained

A 95% confidence interval [92.9%, 94.9%] does not mean there is a 95% chance the true efficiency is in this range. It means: if we repeated this experiment many times (collecting 30-day samples), 95% of the resulting confidence intervals would contain the true population mean.

The width of the interval (94.9 - 92.9 = 2.0 pp) reflects sample size: with 30 runs and σ = 0.6%, the 95% CI is approximately ±2 × 0.6/√30 ≈ ±0.22 pp, confirmed by the reported interval. A wider interval means more uncertainty.

## 5.7 Sensitivity Analysis

A sensitivity analysis systematically varies one parameter while keeping everything else fixed, to understand how dependent the result is on that parameter. The paper sweeps α (the LSTM trust weight) from 0.05 to 0.75 in steps of 0.05 and measures the resulting MPPT efficiency.

The result shows three regimes:

Range | Regime | Effect
α < 0.20 | Under-trust | LSTM contribution too small. Efficiency gain: 0.8–2.5 pp. Nearly equivalent to plain P&O.
α 0.20–0.55 | Stable plateau | Optimal region. 5.5–6.2 pp gain on clear days, 23.6–24.4 pp on monsoon days. Robust to ±50% variation in α.
α > 0.60 | Over-trust | LSTM prediction errors dominate. Efficiency drops as the controller chases incorrect predictions.

The practical implication: this controller does not need precise tuning of α. Any value between 0.20 and 0.55 works well — a wide plateau that gives confidence the system will perform in the field even if α drifts slightly.

# Chapter 6: The Bangladesh SHS Context

Understanding why this paper matters requires knowing its application context: the IDCOL Solar Home System programme and the challenges of rural energy access in Bangladesh.

## 6.1 The IDCOL SHS Programme

IDCOL (Infrastructure Development Company Limited) is a government-owned financial institution in Bangladesh. Its Solar Home System programme, launched in 2003, has become one of the world's largest off-grid solar deployments — electrifying over six million rural households that are not connected to the national grid.

A typical IDCOL SHS consists of a 50 Wp solar panel, a lead-acid battery, an MPPT charge controller, and DC loads (LED lights, phone chargers, small fans). The system is financed through microloans, making affordability a critical constraint: any controller costing significantly more than existing options faces a real adoption barrier.

## 6.2 The Monsoon Problem

Bangladesh has a pronounced monsoon season from June to September. Sylhet (in northeast Bangladesh) receives the most rainfall in the country — driven by orographic lifting as warm moist air from the Bay of Bengal hits the Meghalaya hills.

During monsoon, cloud cover is both heavy and highly variable. Irradiance can fluctuate from 700 W/m² to 80 W/m² in less than one second as cloud shadows sweep across the landscape. This is precisely the type of transient that P&O handles worst.

Field assessments by Hossain et al. (the baseline referenced in the paper) measured plain P&O efficiency of 79–85% during monsoon months across IDCOL SHS installations. The Helios-Artemis simulation gives 70.7% — slightly more pessimistic because the Sylhet OU model captures sub-second fluctuations that monthly averages in the field data smooth out.

## 6.3 Cost Analysis

Component | Estimated Cost
ESP32-S3 (Helios MCU) | 380 BDT
STM32F103 (Artemis MCU) | 120 BDT
INA219 current/voltage sensor | 80 BDT
TSL2591 ambient light sensor | 120 BDT
Buck converter passives (MOSFET, inductor, capacitor) | 350 BDT
PCB and housing | 280 BDT
Miscellaneous connectors | 170 BDT
TOTAL | ~1,500 BDT (~USD 14)
Commercial IDCOL-compatible MPPT controller | ~13,500 BDT (~USD 123)
Cost reduction | 89%

At a rural avoided electricity cost of 60 BDT/kWh (the approximate cost of alternatives like kerosene and grid-equivalent pricing), the projected +4.8 kWh/year yield improvement generates ~289 BDT/year in additional energy value. This implies a payback period of approximately 5.2 years compared to a plain P&O baseline — reasonable given the controller's expected 10+ year lifespan.

## 6.4 Why Cloud Independence Matters

Several prior LSTM MPPT systems (Liu et al., Abdel-Basset et al.) require cloud connectivity for model retraining — the model is retrained on a remote server using uploaded data, then downloaded back. This is incompatible with rural Bangladesh:

- Mobile data connectivity in remote upazilas (sub-districts) is intermittent or unavailable.
- Data upload costs would add recurring operating expenses.
- Privacy: uploading household energy usage data to an external server raises concerns.
- Reliability: the system should work indefinitely without any external dependencies.

Helios-Artemis addresses all of these by performing both inference and retraining entirely on-device, using only data collected by the system itself from its own sensors.

# Chapter 7: Reading the Paper — Section by Section

With the foundations in place, this chapter walks through each section of the Helios-Artemis paper, explaining what to expect and what to focus on.

## 7.1 Abstract

The abstract front-loads the most important numbers: 70.7% → 94.0% MPPT efficiency, R² = 0.917, 1,500 BDT cost, 89% cost reduction. These are the claims the rest of the paper must substantiate.

The critical caveat — 'All results reported herein are derived from simulation' — is stated explicitly in the abstract. This transparency is scientifically appropriate; the paper is making simulation-based predictions, not empirical hardware claims.

## 7.2 Introduction

The introduction establishes the 15.1 percentage point efficiency gap between clear-sky (86%) and monsoon (70.7%) P&O performance as the central problem. It frames the four paper contributions: (1) dual-MCU architecture, (2) calibrated Sylhet simulation model, (3) 30-day Monte Carlo validation, (4) α sensitivity analysis.

## 7.3 Literature Review

The literature review positions Helios-Artemis relative to three bodies of prior work: conventional MPPT algorithms (P&O, IncCond, VS-P&O), ML-based MPPT approaches (LSTM, ANN), and Bangladesh-specific solar research (Hossain et al. SHS baselines, Islam et al. GHI characterisation).

The key observation from the ML literature: Liu et al. (R² = 0.973, China) and Abdel-Basset et al. (R² = 0.961, Egypt) achieve higher R² values — but both require cloud connectivity. Mazumdar et al. (R² = 0.952, India) uses real-world data. The Helios-Artemis R² of 0.917 on monsoon-climate synthetic data is lower not because the model is inferior, but because Sylhet monsoon conditions are inherently more variable.

## 7.4 System Architecture (Section III)

This is the most technical section. Key things to understand:

- Figure 1 (architecture diagram): trace the data flow — TSL2591/camera → ESP32-S3 → LSTM inference → UART → STM32F103 → VS-P&O → PWM → MOSFET → panel.
- The blend equation: V_ref,new = (1 − α) × V_ref,P&O + α × V_MPP,pred. When α = 0: pure P&O. When α = 1: pure LSTM. The paper uses α ≈ 0.35.
- The 15% deadband: the blend fires only when the LSTM prediction differs from actual irradiance by more than 15%. This suppresses unnecessary blending during stable periods.
- Asymmetric α: cloud-clearing events (irradiance rising) use a higher effective α than cloud-drop events (irradiance falling). This prevents overshooting during sudden shadows.

## 7.5 Simulation Results (Section IV)

Focus on Figure 4 (LSTM performance), Figure 5 (full-day simulation), Figure 6 (Monte Carlo distribution), and Figure 8 (validation against Hossain et al. baselines).

The 8.3 pp discrepancy between simulated plain P&O (70.7%) and the Hossain et al. field lower bound (79%) is addressed honestly: the simulation is more conservative because it captures sub-second OU flicker that monthly field averages do not. This is not a calibration failure — it means the simulation is harder than reality for the baseline algorithm, which strengthens (not weakens) the case for Helios-Artemis.

## 7.6 Discussion and Limitations (Section V)

The paper's most important honesty is in Section V.C: 'The present study is entirely simulation-based. No empirical hardware measurements were collected in this work.' This is the boundary between what the paper claims and what it does not.

The planned next step — hardware prototype fabrication and field deployment in Sylhet (Q3 2026) — will either validate or refine the simulation predictions. Common simulation-to-hardware gaps include: connector resistance, thermal drift, ADC quantisation artefacts, and real-world UART timing jitter.

# Chapter 8: Complete Glossary

Term | Full Name | Definition
ADC | Analog-to-Digital Converter | Converts a continuous analog voltage (e.g., from a sensor) into a digital number that a microcontroller can process.
α (alpha) | Prediction trust weight | Parameter (0–1) controlling how much the Helios-Artemis controller relies on the LSTM forecast vs. the P&O measurement. Optimal near 0.35.
Aerosol attenuation | Light scattering by particles | Reduction in irradiance caused by dust, haze, and pollution in the atmosphere. Modelled as a ×0.93 multiplier for Sylhet.
Baud rate | UART data speed | Bits per second transmitted over UART. Both devices must agree on this value.
Buck converter | Step-down DC-DC converter | Converts higher DC voltage to lower DC voltage efficiently using a switching transistor, inductor, and capacitor.
CC/CV | Constant Current / Constant Voltage | Battery charging modes. CC phase charges at fixed current; CV phase holds fixed voltage as current tapers.
CI (Confidence Interval) | Statistical range | Range within which the true population parameter lies with a stated probability (e.g., 95%).
Cortex-M3 | ARM CPU core | The processor architecture inside the STM32F103. ARM Cortex-M cores are common in embedded systems for their efficiency.
CVI | Cloud Variability Index | Measure of how much irradiance fluctuates. Sylhet July CVI = 0.85 — among the highest variability conditions.
DC-DC converter | Voltage transformation circuit | Converts one DC voltage level to another without the resistive losses of a linear regulator.
Duty cycle | PWM on-time fraction | The fraction of each PWM cycle that the signal is HIGH. 50% duty cycle at 50 kHz = 10 μs on, 10 μs off.
EMI | Electromagnetic Interference | Electrical noise generated by switching circuits (like the buck converter) that can corrupt sensor readings.
ESP32-S3 | Helios microcontroller | Dual-core 240 MHz WiFi/BT MCU from Espressif. 512 kB SRAM. Hosts the LSTM, web dashboard, and SD logging.
Fill factor (FF) | PV efficiency metric | Ratio of actual max power to (Voc × Isc). Indicates how rectangular the I-V curve is. Higher = better.
GHI | Global Horizontal Irradiance | Total solar radiation (direct + diffuse) received on a horizontal surface. Primary input to the LSTM.
GPIO | General Purpose I/O pin | Configurable digital pin on a microcontroller that can read or write binary signals.
I2C | Inter-Integrated Circuit | Two-wire serial protocol (SDA + SCL) used to communicate with sensors. The INA219 and SSD1306 use I2C.
IDCOL | Infrastructure Dev. Company Ltd. | Bangladeshi government financial institution running the largest rural SHS programme in the world.
INA219 | Current/voltage sensor IC | I2C sensor that measures current and voltage simultaneously using a shunt resistor. Used in Artemis for battery monitoring.
Isc | Short-circuit current | The panel current when output voltage = 0. Directly proportional to irradiance.
I-V curve | Current-Voltage characteristic | Graph of panel current vs. voltage for a given irradiance level. Contains the MPP.
INT8 quantisation | 8-bit model compression | Converting LSTM weights from 32-bit float to 8-bit integer. Reduces model size 4× and inference time from 12 ms to 4.7 ms.
IRFZ44N | Power MOSFET | The switching transistor in the Artemis buck converter. VDS = 60 V, RDS(on) = 28 mΩ. To be upgraded to IRFB4110 in hardware prototype.
LSTM | Long Short-Term Memory | A type of recurrent neural network with gates that control information flow, enabling learning of long-term temporal dependencies.
MAE | Mean Absolute Error | Average of |predicted − actual|. The LSTM achieves daytime MAE = 50.7 W/m².
MCU | Microcontroller Unit | A single chip containing CPU, RAM, Flash, and peripherals. Runs one dedicated program.
MOSFET | Metal-Oxide-Semiconductor FET | A transistor type used as the main switch in switching power converters. In Artemis: IRFZ44N.
MPP | Maximum Power Point | The voltage/current combination on the I-V curve that produces the highest power output.
MPPT | Max Power Point Tracking | Algorithm and hardware that continuously adjusts the panel's operating point to stay at the MPP.
NASA POWER | Satellite climate database | NASA's Prediction of Worldwide Energy Resources — provides historical solar irradiance data used to parameterise the simulation.
OU process | Ornstein-Uhlenbeck noise | Mean-reverting stochastic process used to model sub-second irradiance flicker. τ = 1 s, σ = 25%.
OV2640 | Camera module | Low-cost image sensor on the ESP32-S3. Used for visual cloud detection in the Helios sensor suite.
P&O | Perturb-and-Observe | The standard reactive MPPT algorithm. Simple, but loses 15+ percentage points during fast transients.
PV | Photovoltaic | Technology that converts light directly to electricity via the photovoltaic effect in semiconductor materials.
PWM | Pulse Width Modulation | Signal that switches rapidly between high and low; duty cycle controls average voltage delivered.
R² | Coefficient of determination | Statistical metric of model fit. 0 = no better than mean, 1 = perfect. Helios LSTM: R² = 0.917.
RDS(on) | MOSFET on-resistance | Resistance across the MOSFET when it is fully on. Lower = less conduction loss. IRFZ44N: 28 mΩ.
RMSE | Root Mean Square Error | Like MAE but squares errors first — penalises large errors more. LSTM RMSE = 63.6 W/m².
SHS | Solar Home System | Small standalone solar power system for rural homes. Typical: 50 Wp panel + battery + controller + DC loads.
SoC | State of Charge | Remaining battery capacity as a percentage. Simulation starts at 45%, reaches 100% by end of day.
SREDA | Sustainable and Renewable Energy Development Authority | Bangladesh government agency. Published the Solar Resource Atlas used to parameterise the irradiance model.
STM32F103 | Artemis microcontroller | 72 MHz Cortex-M3 MCU from STMicroelectronics. 20 kB SRAM. Handles power control and PWM.
TC4420 | Gate driver IC | Drives the IRFZ44N MOSFET gate with sufficient current for fast, clean switching at 50 kHz.
TF.js | TensorFlow.js | JavaScript port of TensorFlow. Runs in the browser — used for on-device LSTM training served by the ESP32-S3's web dashboard.
TinyML | ML on microcontrollers | Deploying trained ML models on microcontrollers using quantisation and model compression. The Helios LSTM is a TinyML deployment.
TSL2591 | Ambient light sensor | I2C sensor on the ESP32-S3 that measures irradiance levels. Primary real-time input to the LSTM.
UART | Universal Async Receiver-Transmitter | Simple two-wire serial protocol. Helios sends irradiance predictions to Artemis every 100 ms over UART.
Vmp | Voltage at maximum power | The panel voltage at the MPP. The MPPT algorithm's target.
Voc | Open-circuit voltage | Maximum panel voltage when no current flows. Weakly affected by irradiance; decreases with temperature.
VS-P&O | Variable-Step P&O | P&O variant where step size scales with |dP/dV|. Faster convergence near MPP. Used in Artemis.
Wp | Watt-peak | Rated power of a solar panel under Standard Test Conditions (1000 W/m² irradiance, 25°C). The simulation uses a 50 Wp panel.

# Chapter 9: Further Study and Resources

This chapter suggests resources for going deeper on each topic covered in this primer.

## 9.1 Solar Energy and MPPT

- Femia et al. (2005): 'Optimization of perturb and observe MPPT method' — IEEE Transactions on Power Electronics. The canonical P&O reference.
- Esram & Chapman (2007): 'Comparison of photovoltaic array MPPT techniques' — IEEE Transactions on Energy Conversion. Reviews 19 MPPT algorithms side by side.
- Sera et al. (2013): 'On the P&O and Incremental Conductance MPPT Methods for PV Systems' — quantifies efficiency losses during transients.

## 9.2 Neural Networks and LSTM

- Hochreiter & Schmidhuber (1997): 'Long short-term memory' — Neural Computation. The original LSTM paper. Dense but foundational.
- Colah's blog: 'Understanding LSTMs' (colah.github.io) — the best visual explanation of LSTM gates available online.
- 3Blue1Brown: 'Neural Networks' series on YouTube — excellent visual intuition for how neural networks learn.
- Fast.ai Practical Deep Learning for Coders — free course covering everything from backpropagation to sequence models.

## 9.3 Embedded Systems

- Espressif ESP32-S3 Technical Reference Manual — full documentation for the Helios MCU, available at docs.espressif.com.
- STM32F103 Reference Manual (RM0008) — ST Microelectronics. Covers every peripheral used by Artemis.
- Making Embedded Systems by Elecia White — accessible introduction to embedded systems design.

## 9.4 Statistics and Simulation

- Statistics in Plain English by Timothy Urdan — covers confidence intervals, regression, and statistical significance clearly.
- Khan Academy Statistics — free, comprehensive, and accessible treatment of all statistics concepts in this primer.
- Lave & Kleissl (2010): 'Cloud speed impact on solar variability scaling' — the paper used to calibrate the OU flicker model.

## 9.5 Bangladesh Solar Context

- IDCOL Annual Report 2023 — documents the scale and performance of the SHS programme.
- Islam et al. (2016): 'Solar energy resource assessment of Bangladesh' — Renewable Energy. Maps the national solar resource.
- Hossain et al. (2021): 'Field performance of MPPT controllers in rural Bangladesh SHS installations' — the field baseline the paper compares against.

# Chapter 10: Quick-Reference Summary

A one-stop reference sheet for the most important facts, numbers, and relationships from the paper.

## The Central Result

Core claim | MPPT tracking efficiency during Sylhet monsoon transients: 70.7% (plain P&O) → 94.0% ± 0.6% (Helios-Artemis, 30-day Monte Carlo). +23.3 percentage point improvement.

## Key Numbers at a Glance

Parameter | Value
Plain P&O efficiency — clear sky | ~86%
Plain P&O efficiency — Sylhet monsoon | 70.7%
Helios-Artemis efficiency — monsoon (Monte Carlo mean) | 94.0% ± 0.6%
95% Confidence Interval | [92.9%, 94.9%]
LSTM R² (Year-2 independent test) | 0.917
LSTM daytime MAE | 50.7 W/m²
LSTM RMSE | 63.6 W/m²
LSTM parameters (32-unit model) | ~7,430 total
LSTM inference time (ESP32-S3, FP32) | < 12 ms
LSTM inference time (INT8 quantised) | 4.7 ms
Optimal α value | ~0.35
Stable α plateau | 0.20 to 0.55
UART update interval | 100 ms
PWM switching frequency (Artemis) | 50 kHz
Buck converter MOSFET | IRFZ44N (RDS(on) = 28 mΩ)
Peak simulated GHI (Sylhet July) | 744 W/m²
Panel rating | 50 Wp monocrystalline
Panel Isc (post-soiling) | 2.91 A
Battery charging — Bulk current | 6 A
Battery float voltage | 13.8 V
Controller component cost | ~1,500 BDT (~USD 14)
Commercial MPPT controller cost | ~13,500 BDT
Cost reduction | 89%
Projected payback period | ~5.2 years
IDCOL SHS households | > 6 million
Sylhet coordinates | 24.89°N, 91.87°E

## The Blend Equation

V_ref,new = (1 − α) × V_ref,P&O + α × V_MPP,pred

Fires only when |Ĝ − G| / G > 15% (deadband filter)

## Variable-Step P&O Law

step_size = clip(0.008 × |dP/dV|, min=0.05, max=0.60) [Volts]

End of primer. Good luck with the paper.
