touhidsiddiqueeraj-bit/artemis-helios/Code/Python/figures/fig8_cost.png

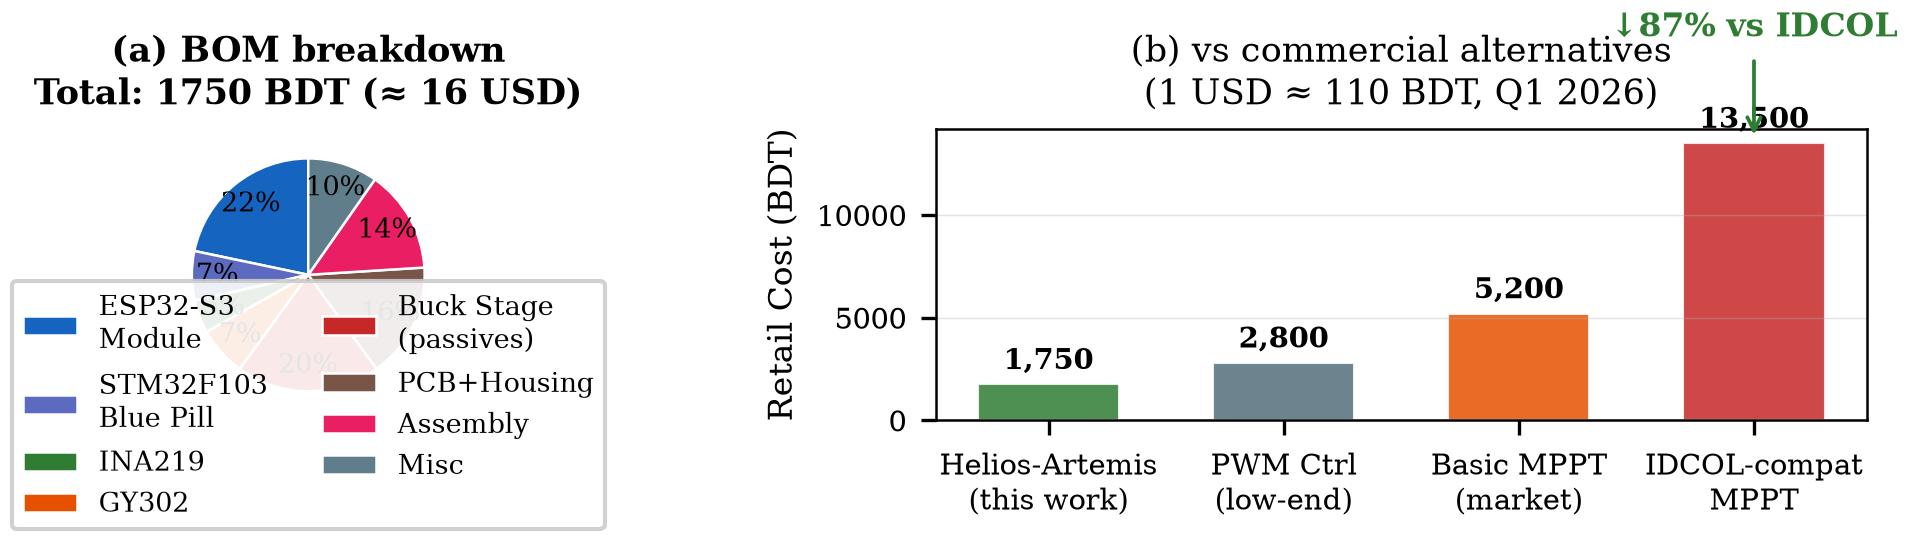
Code/Python/figures/fig8_cost.png
