touhidsiddiqueeraj-bit/artemis-helios/Figures/figures_python/FIG8/output/fig8_cost.png

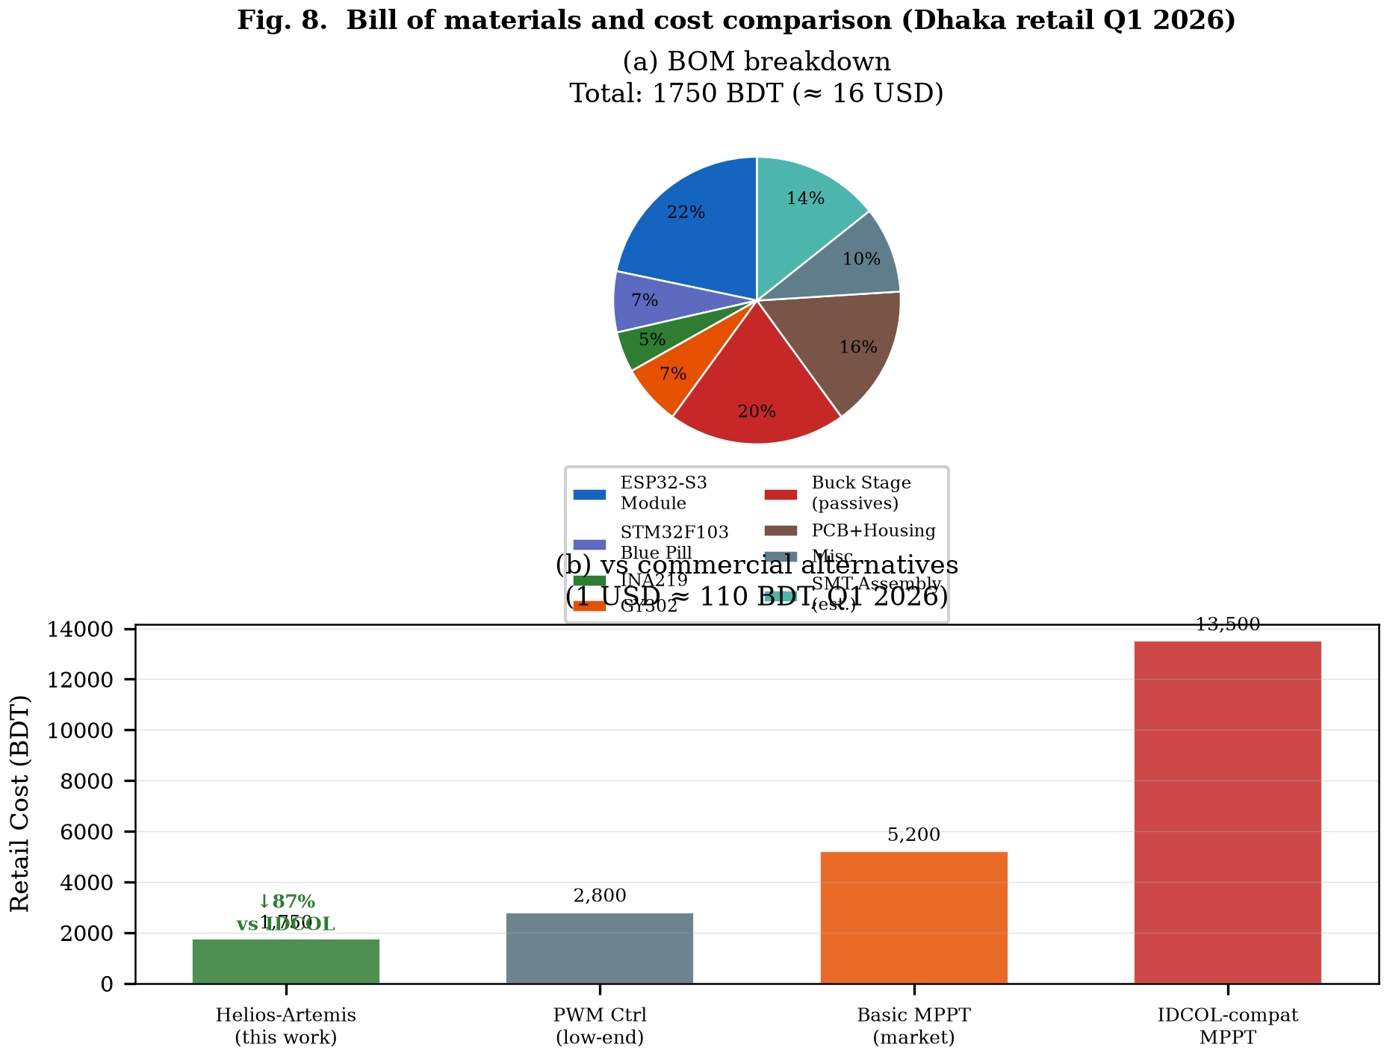
Figures/figures_python/FIG8/output/fig8_cost.png
