touhidsiddiqueeraj-bit/artemis-helios/Figures/figures_python/fig8_cost.png

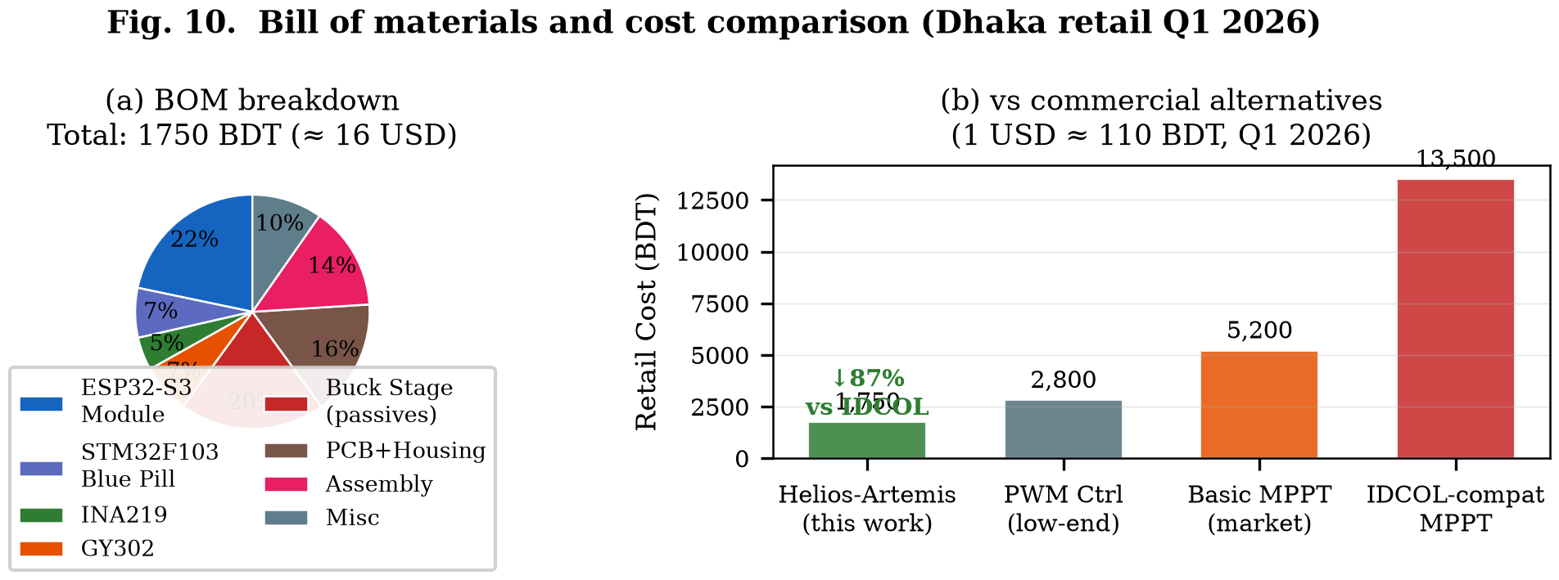
Figures/figures_python/fig8_cost.png
