touhidsiddiqueeraj-bit/artemis-helios/Docs/Study_materials/Helios_Artemis_Study_Guide.docx

HELIOS-ARTEMIS

Hussain Touhid Siddiquee

Dept. of Electrical & Electronic Engineering

Leading University, Sylhet, Bangladesh

2026

# 1. The One-Paragraph Pitch

The IDCOL programme has deployed solar home systems to 6 million+ rural Bangladeshi households, but conventional Perturb-and-Observe (P&O) MPPT efficiency collapses from ~86% to 70.7% during Sylhet monsoon transients — a 15 pp loss. Helios-Artemis fixes this using a dual-MCU predictive controller: the ESP32-S3 (Helios) runs a 32-unit LSTM to forecast irradiance and pre-position the voltage reference, while the STM32F103 (Artemis) handles real-time 50 kHz power switching. The two communicate over UART every 100 ms. Simulation shows MPPT efficiency improving to 94.0±0.6% — a +23.3 pp gain — at a controller cost of ~1,500 BDT (USD 14), which is 89% below commercial alternatives. No internet or cloud required.

# 2. Core Concepts

## 2.1 What is MPPT?

A solar panel's output power varies with irradiance and temperature. At any given moment there is exactly one operating voltage — the Maximum Power Point — where power output is highest. MPPT tracking means continuously steering the converter to stay at that point.

- At perfect tracking: controller extracts 100% of available power
- Efficiency = P_actual ÷ P_MPP × 100%
- The MPP shifts whenever clouds pass or temperature changes

## 2.2 Why Does P&O Fail in Monsoon?

Perturb-and-Observe is the standard low-cost MPPT algorithm. Every cycle it nudges the voltage slightly and checks if power went up or down. The problem: it is reactive.

- P&O can only respond after irradiance has already changed
- Under rapid cloud transients, it chases the wrong direction entirely
- Result: efficiency drops from ~86% (clear sky) to 70.7% (Sylhet monsoon)
- Variable-step P&O (VS-P&O) helps but doesn't fix the root problem — it's still reactive

## 2.3 What is LSTM and Why Use It Here?

Long Short-Term Memory is a type of neural network designed for sequential data. Unlike a basic model, it remembers patterns across time — exactly what you need for cloud forecasting.

- Cloud patterns are autocorrelated: a cloud 20 minutes away leaves a trail in recent irradiance
- LSTM can predict irradiance 30 minutes ahead based on the past 24 hours of data
- This lets Helios pre-position the voltage reference before the transient hits
- Result: proactive control instead of reactive control

## 2.4 The Alpha Blend — How LSTM and P&O Work Together

Rather than replacing P&O with LSTM, the system blends them:

V_ref = (1 − α) × V_P&O + α × V_LSTM_prediction

α controls how much you trust the LSTM. The table below shows what different values mean:

α Range | What Happens | Result
α < 0.20 | LSTM barely influences control | Near plain P&O performance
α = 0.20 to 0.55 | OPTIMAL ZONE — LSTM helps, P&O prevents over-reliance | +5–6 pp clear days, +23–24 pp monsoon
α > 0.60 | LSTM dominates; its errors drag efficiency down | Performance degrades

The optimal value is α = 0.35. The stable plateau spans Δα = 0.35, meaning the system tolerates ±50% variation — it is not overfit to a single value.

## 2.5 Why Simulate Instead of Building Hardware?

The study is entirely simulation-based — a deliberate sequencing choice, not a shortcut:

- Hardware fabrication in Sylhet requires procurement, PCB fabrication, and field site access
- Simulation allows full parametric exploration: 30-day Monte Carlo, α sensitivity sweep, architecture ablation — impossible to replicate cheaply in hardware
- The simulation is parameterised from NASA POWER and SREDA real climatological data for Sylhet
- Hardware prototype fabrication is the confirmed next phase, target Q3 2026

# 3. System Architecture

## 3.1 Big Picture: Two MCUs, One Controller

The key architectural insight is decoupling intelligence from real-time control. LSTM inference takes milliseconds — if this ran on the same MCU as the switching control, it would cause jitter in the 50 kHz loop.

Architecture Rule

Helios (ESP32-S3) → Brain: LSTM inference, irradiance sensing, SD logging, browser retraining

Artemis (STM32F103) → Muscle: 50 kHz PWM switching, P&O MPPT, battery charging (CC/CV)

UART link → Bridge: 100 ms interval; Helios sends predicted V_MPP; Artemis applies the blend formula

## 3.2 Helios (ESP32-S3) — Component Details

Component | Spec / Value | Why It Matters
MCU | ESP32-S3, 240 MHz dual-core, 512 kB SRAM | Enough headroom for TF.js inference + Wi-Fi
Light sensor | TSL2591 high-dynamic-range | Measures irradiance as the LSTM input
Camera | OV2640 | Cloud detection input for additional LSTM features
Storage | SD card | Logs 24 h of irradiance data for on-device retraining
Inference time | <12 ms (Int8: 4.7 ms) | Fits inside 100 ms UART window with plenty of margin
Retraining | TF.js in local browser | Zero internet; user connects to local Wi-Fi hotspot

## 3.3 Artemis (STM32F103) — Component Details

Component | Spec / Value | Why It Matters
MCU | STM32F103 Cortex-M3, 72 MHz, 20 kB SRAM | Deterministic real-time control, no OS jitter
PWM frequency | 50 kHz | High freq → smaller LC filter, less output ripple
MOSFET | IRFZ44N (VDS=60V, RDS(on)=28 mΩ) | Main switching device; upgrade to IRFB4110 in prototype
Gate driver | TC4420 | Drives MOSFET gate with sufficient current at 50 kHz
LC filter | 100 μH inductor + 470 μF cap | Buck converter output filter
Current/power monitor | INA219 (12-bit I²C, 0.1 Ω shunt) | Measures battery bus current and voltage

## 3.4 Battery Charging Stages

- Bulk: Constant current 6A until battery reaches 14.7V — fastest charging phase
- Absorption: Hold at 14.7V; current tapers as battery fills; ends when I < 0.5A
- Float: Hold at 13.8V indefinitely — maintains full charge without overcharging

# 4. The Irradiance Simulation Model

There is no 1-second-resolution irradiance dataset for Sylhet, so the study generates synthetic profiles using two coupled stochastic processes, calibrated from real NASA POWER and SREDA data.

## 4.1 Two-Process Model

- Markov chain: generates cloud state transitions (clear / partly cloudy / overcast) at minute timescales, from NASA POWER monthly GHI statistics
- Ornstein-Uhlenbeck (OU): adds sub-second flicker on top of the Markov state. Parameters: τ=1s, σ=25%, calibrated from Lave & Kleissl 2010 cloud-shadow measurements

## 4.2 Four Physical Realism Layers

Layer | What It Models | Value
R1 — OU flicker | Sub-second irradiance turbulence from cloud shadows | τ=1s, σ=25%
R2 — Aerosol attenuation | Haze and dust reducing peak irradiance | ×0.93 (Linke Turbodity factor L≈4.5)
R3 — ADC noise | Sensor noise in INA219 current/voltage readings | σ_I=2 mA, σ_V=10 mV
R4 — Panel soiling | Dust reducing short-circuit current | 3% on Isc, monthly cleaning

Peak modelled GHI for Sylhet July: 744 W/m² (aerosol-capped, vs 880 W/m² clear sky). The OU flicker makes the monsoon baseline harder than real field conditions — meaning the +23.3 pp improvement claim is conservative.

## 4.3 Sylhet Monthly Irradiance Parameters

Parameter | Jan | Apr | Jul | Sep | Dec
Peak GHI (W/m²) | 820 | 880 | 580 | 650 | 800
Cloud Variability Index | 0.15 | 0.30 | 0.85 | 0.65 | 0.15
Sunrise | 06:18 | 05:36 | 05:18 | 05:48 | 06:24
Sunset | 17:24 | 18:36 | 19:06 | 18:12 | 17:06

July CVI=0.85 is the worst case — one of the most challenging irradiance environments globally.

# 5. Key Results — Numbers to Know

## 5.1 LSTM Predictor Performance

Metric | Value | What It Means
R² | 0.917 | Explains 91.7% of variance on fully independent Year-2 test set
Daytime MAE | 50.7 W/m² | Average error during daylight hours
RMSE | 63.6 W/m² | Root mean square error
Residual bias | +2.3 W/m² | Slight over-prediction — good, prevents under-positioning
Inference time (float) | <12 ms | Well within 100 ms UART window
Inference time (Int8) | 4.7 ms | Quantised version, ΔR²=−0.009 (tiny tradeoff)

## 5.2 MPPT Efficiency vs All Algorithms (Monte Carlo N=30)

Scenario | Plain P&O | VS-P&O | Inc. Cond. | Helios-Artemis | Gain
Clear sky (Jan) | 86.8±1.7% | 90.5±1.5% | 89.2±1.7% | 93.2±1.1% | +6.4 pp
Monsoon (Jul) | 70.9±3.8% | 78.3±3.4% | 75.2±3.8% | 95.1±2.1% | +24.2 pp
Partial shade | 85.6±2.4% | 89.0±2.0% | 87.5±2.1% | 93.3±1.6% | +7.7 pp
Annual mean | 85.8±1.5% | 89.1±1.2% | 87.7±1.3% | 91.3±1.0% | +5.5 pp

Monte Carlo Summary (July, 30 independent days)

Mean η = 94.0% | σ = 0.6% | 95% CI: [92.9%, 94.9%]

All 30 simulation days fell within the 90–95% efficiency band.

## 5.3 Full-Day Simulation Highlights (July, Seed 23)

- Battery SoC: 45% → 100% within the 13-hour Sylhet July solar window
- Peak junction temperature: 62°C simulated (35°C ambient, Rth_JA ≈ 13.5°C/W)
- Battery voltage range: 12.41 V → 13.61 V
- P&O cold-start convergence: ~18 steps to reach 94% efficiency

## 5.4 LSTM Architecture Ablation

Architecture | R² | MAE (W/m²) | RMSE (W/m²) | Notes
16 units, 1 layer | 0.858 | 67.1 | 83.3 | Too weak
32 units, 1 layer (SELECTED) | 0.917 | 50.7 | 63.6 | Optimal: <12 ms inference
64 units, 1 layer | 0.934 | 45.0 | 56.6 | ~37 ms inference — too slow

# 6. Validation Against Field Data

## 6.1 Hossain et al. (2021) IDCOL Field Baselines

The primary external validation compares simulated plain P&O performance against Hossain et al.'s field measurements from real IDCOL SHS controllers across rural Bangladesh.

Condition | Simulated P&O | Hossain Field Range | Match?
Clear sky (Jan) | 86.8% | 79–85% | Within 1.8 pp ✓
Monsoon (Jul) | 70.7% | 79–85% (lower bound) | 8.3 pp below lower bound

## 6.2 Why the Monsoon Gap Is Not a Problem

Key Argument

The Sylhet Markov+OU model uses sub-second OU flicker (σ=25%) which is more severe than the monthly-averaged variability in Hossain et al.'s field baseline. Our simulation baseline is harder than real field conditions. This makes our 70.7% P&O baseline conservative — and therefore makes our +23.3 pp improvement claim equally conservative.

If anything, real hardware would show even better gains because real conditions are less severe than the simulation.

## 6.3 Why R²=0.917 Is Good Despite Being Lower Than Other Papers

- Liu et al. (R²=0.973): China — arid climate, much lower cloud variability
- Abdel-Basset et al. (R²=0.961): Egypt — desert climate, minimal monsoon
- Mazumdar et al. confirmed: lower R² in monsoon climates reflects climate difficulty, not model weakness
- Our 0.917 is on a fully independent Year-2 test set with a distinct random seed — no data leakage

# 7. Cost, Deployment & Limitations

## 7.1 Bill of Materials (~1,500 BDT Total)

Component | Cost (BDT)
ESP32-S3 | 380
STM32F103 | 120
INA219 power monitor | 80
TSL2591 light sensor | 120
Buck converter passives (L, C, MOSFET) | 350
PCB and housing | 280
Connectors and misc. | 170
TOTAL | ~1,500 BDT (USD 14)

Commercial IDCOL-compatible MPPT controller: ~13,500 BDT. Cost reduction: 89%.

## 7.2 Economic Payback

- Annual yield gain per 50 Wp panel: +4.8 kWh (91.3% vs 85.8% annual efficiency)
- Additional energy value per year: +289 BDT (at 60 BDT/kWh avoided cost)
- Payback period vs plain P&O baseline: ~5.2 years
- ESP32-S3 and STM32F103 rated lifetime: 10+ years → payback well within operational life
- Conservative estimate: does not include battery longevity improvement from more stable charging

## 7.3 How Cloud-Free Retraining Works

- ESP32-S3 creates a local Wi-Fi access point — no internet router needed
- User connects phone or laptop to this hotspot
- Browser-based interface runs TF.js training on 24 h of SD-card data
- Weights are exported back to the ESP32-S3 flash after training
- No data ever leaves the local device-to-browser link
- Silent 14-day on-device retraining cycles continue automatically after initial setup

## 7.4 Honest Limitations

What the Study Cannot Claim

• All efficiency numbers come from simulation — no empirical hardware measurements were taken

• Simulation-to-hardware fidelity for the LSTM blend has not been confirmed

• Next step: hardware prototype fabrication and field deployment in Sylhet, Q3 2026

• IRFZ44N will be upgraded to IRFB4110 (−86% conduction loss) in the hardware prototype

# 8. Anticipated Questions

## Methodology Questions

Q: Why simulation instead of hardware validation?

Deliberate sequencing. Hardware fabrication in Sylhet requires procurement, PCB fab, and field site access — all time-consuming. Simulation-first allowed full parametric exploration (30-day Monte Carlo, α sweep, architecture ablation) that would be prohibitively expensive in hardware. The model is parameterised from NASA POWER and SREDA real data. Hardware is the confirmed immediate next phase, target Q3 2026.

Q: How do you validate the irradiance model with no real sensor data?

Indirect validation: simulated plain P&O efficiency (86.8% clear-sky) matches the Hossain et al. IDCOL field upper bound (79–85%) within 1.8 pp — confirming the clear-sky GHI model is physically reasonable. The OU parameters (τ=1s, σ=25%) are calibrated from Lave & Kleissl 2010, a peer-reviewed cloud-shadow study. Full sensor-data validation happens in the Q3 2026 hardware trial.

Q: Your R²=0.917 is lower than other LSTM MPPT papers. Why?

Climate difficulty. Liu et al. (0.973, China) and Abdel-Basset et al. (0.961, Egypt) work in arid/temperate climates. Sylhet's monsoon CVI of 0.85 is one of the most challenging globally. Mazumdar et al. confirmed that lower R² in monsoon conditions reflects climate difficulty, not model limitation. Our 0.917 on a fully independent Year-2 test set is strong performance for this climate.

Q: Why not use a larger/better model like a Transformer?

Hardware constraint: the binding limit is the 12 ms inference budget on the ESP32-S3, needed to fit within the 100 ms UART sync interval. The 64-unit LSTM is estimated at 37 ms — dangerously close to the budget. For the accuracy-vs-latency Pareto frontier on this specific hardware, 32 units is the optimal choice.

Q: Your 94% efficiency is from simulation. How confident are you it holds in hardware?

Moderate confidence, acknowledged uncertainty. Three supporting factors: (1) simulation uses conservative parameters — OU flicker more severe than real field; (2) 30-day Monte Carlo gives statistical bounds, not a single lucky run; (3) VS-P&O hardware implementations achieve 88–92% under variable irradiance (per Tey & Mekhilef 2014), so 94% with LSTM assist is plausible. The paper explicitly states this limitation.

Q: Why does the α plateau matter? Isn't α=0.35 just tuned to this simulation?

The plateau (Δα=0.35, from 0.20 to 0.55) resolves the concern that the 94% result is specifically tuned to one value and would collapse with variation. Stable gain across ±50% variation in α means the result is structurally robust — not parameter overfitting. This directly addresses the standard reviewer critique for intelligent MPPT papers.

Q: Why UART instead of SPI or I²C?

UART is asynchronous, needs only 2 wires (TX/RX), and bandwidth is not a constraint at 100 ms intervals (only a few bytes of float data per message). SPI requires chip-select and clock lines; I²C has addressing overhead. UART is also more electrically robust in a 50 kHz switching environment.

Q: Why not start with the IRFB4110 instead of IRFZ44N?

Cost and availability. IRFZ44N costs ~40 BDT in Dhaka retail and is universally stocked. Its RDS(on)=28 mΩ gives peak conduction loss of ~2.0 W at 8.5 A — manageable with a small heatsink. IRFB4110 (3.7 mΩ, −86% loss) will be used in the hardware prototype where thermal performance can be empirically confirmed.

# 9. Quick-Reference Numbers

Quantity | Value
IDCOL SHS households | 6M+
Sylhet monsoon CVI (July) | 0.85
Plain P&O efficiency — monsoon | 70.7%
Plain P&O efficiency — clear sky | ~86%
Helios-Artemis monsoon efficiency | 94.0 ± 0.6% (95% CI: 92.9–94.9%)
Improvement vs plain P&O (monsoon) | +23.3 pp
LSTM R² (Year-2 independent test) | 0.917
LSTM daytime MAE | 50.7 W/m²
LSTM RMSE | 63.6 W/m²
LSTM residual bias | +2.3 W/m² (slight positive — no under-positioning)
Inference time (32-unit, float) | <12 ms
Inference time (32-unit, Int8) | 4.7 ms
Total model parameters | ~7,430 (7,329 forecaster + 101 gain scheduler)
Optimal α | 0.35
Stable α plateau range | 0.20 to 0.55 (Δα = 0.35)
Blend deadband threshold | 15% relative irradiance deviation
Blend cooldown | 20 P&O steps after each blend event
P&O step size law | dL = clip(0.008×|dP/dV|, 0.05, 0.60) V
Cold-start convergence | ~18 steps to 94% efficiency
UART interval | 100 ms
PWM frequency | 50 kHz
Buck converter LC filter | 100 μH + 470 μF
MOSFET (simulation) | IRFZ44N, RDS(on)=28 mΩ, VDS=60V
MOSFET (hardware upgrade) | IRFB4110, RDS(on)=3.7 mΩ (−86% loss)
Peak conduction loss at 8.5 A | ~2.0 W
Peak junction temperature (simulated) | 62°C (35°C ambient)
Battery SoC start → end | 45% → 100% in 13-hour window
Peak GHI (July, aerosol-capped) | 744 W/m²
OU flicker parameters | τ=1s, σ=25%
Aerosol attenuation | ×0.93 (Linke TL≈4.5)
Panel soiling | 3% on Isc
Monte Carlo days | 30 (July) / N=200 (full scenario table)
Controller cost | ~1,500 BDT (USD 14)
Commercial alternative cost | ~13,500 BDT
Cost reduction | 89%
Annual yield gain per 50 Wp panel | +4.8 kWh
Additional energy value/year | +289 BDT (at 60 BDT/kWh)
Payback period | ~5.2 years
Hardware trial target | Q3 2026, Sylhet field deployment

# 10. Glossary

Term | Meaning
MPPT | Maximum Power Point Tracking
P&O | Perturb-and-Observe MPPT algorithm
VS-P&O | Variable-Step Perturb-and-Observe
LSTM | Long Short-Term Memory (type of recurrent neural network)
MCU | Microcontroller Unit
SHS | Solar Home System
IDCOL | Infrastructure Development Company Limited (Bangladesh)
CVI | Cloud Variability Index (0=clear sky, 1=fully variable)
GHI | Global Horizontal Irradiance (W/m²)
OU | Ornstein-Uhlenbeck (stochastic process for irradiance flicker)
CC/CV | Constant Current / Constant Voltage (battery charging stages)
MAE | Mean Absolute Error
RMSE | Root Mean Square Error
R² | Coefficient of determination (goodness of fit, 0–1)
CI | Confidence Interval
BOM | Bill of Materials
BDT | Bangladeshi Taka
TF.js | TensorFlow.js (browser-based machine learning library)
NASA POWER | NASA Prediction of Worldwide Energy Resources dataset
SREDA | Sustainable and Renewable Energy Development Authority (Bangladesh)
PWM | Pulse Width Modulation
RDS(on) | MOSFET on-resistance (drain-source, when transistor is on)
INA219 | Texas Instruments precision current/power monitor IC
TSL2591 | High-dynamic-range ambient light sensor IC
α (alpha) | LSTM prediction trust weight — blend parameter between 0 and 1
pp | Percentage points (unit for efficiency differences)
