touhidsiddiqueeraj-bit/artemis-helios/Logger_Data/esp32_storage/test_file.txt

If you can see this, Internal Storage is working!
