touhidsiddiqueeraj-bit/artemis-helios/Tables/helios_artemis_year2_test_daily_summary.csv

doy | month | peak_ghi_wm2 | daily_energy_wh_m2 | daytime_mean_ghi | cvi
1 | 1 | 959.4 | 4987.7 | 454.3 | 0.15
2 | 1 | 923.1 | 4917.5 | 446.5 | 0.15
3 | 1 | 951.0 | 4929.3 | 446.9 | 0.15
4 | 1 | 929.0 | 5275.3 | 478.4 | 0.15
5 | 1 | 854.4 | 5453.9 | 495.3 | 0.15
6 | 1 | 936.5 | 5155.6 | 472.4 | 0.15
7 | 1 | 973.6 | 5148.6 | 466.8 | 0.15
8 | 1 | 846.6 | 4929.9 | 447.0 | 0.15
9 | 1 | 959.1 | 4845.8 | 439.4 | 0.15
10 | 1 | 852.6 | 5155.7 | 468.2 | 0.15
11 | 1 | 901.5 | 5577.3 | 508.8 | 0.15
12 | 1 | 856.1 | 5686.9 | 515.7 | 0.15
13 | 1 | 847.2 | 4954.3 | 449.9 | 0.15
14 | 1 | 984.6 | 5409.3 | 490.5 | 0.15
15 | 1 | 848.4 | 5267.9 | 477.7 | 0.15
16 | 1 | 957.0 | 4818.5 | 436.9 | 0.15
17 | 1 | 846.1 | 4970.6 | 450.7 | 0.15
18 | 1 | 852.5 | 5626.7 | 510.2 | 0.15
19 | 1 | 837.9 | 4705.0 | 429.7 | 0.15
20 | 1 | 977.0 | 4621.7 | 419.0 | 0.15
21 | 1 | 849.6 | 4701.5 | 426.3 | 0.15
22 | 1 | 861.6 | 5496.2 | 498.4 | 0.15
23 | 1 | 843.5 | 4973.5 | 451.0 | 0.15
24 | 1 | 846.8 | 5470.8 | 496.0 | 0.15
25 | 1 | 842.2 | 4789.0 | 435.5 | 0.15
26 | 1 | 969.9 | 5266.7 | 484.8 | 0.15
27 | 1 | 932.9 | 5062.0 | 459.0 | 0.15
28 | 1 | 927.8 | 4834.4 | 438.3 | 0.15
29 | 1 | 950.9 | 4738.0 | 429.6 | 0.15
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
