touhidsiddiqueeraj-bit/artemis-helios/Code/Python/data/year2_test_hourly.csv

doy | month | hour | ghi_hourly_wm2
1 | 1 | 0 | 0.0
1 | 1 | 1 | 0.0
1 | 1 | 2 | 0.0
1 | 1 | 3 | 0.0
1 | 1 | 4 | 0.0
1 | 1 | 5 | 0.0
1 | 1 | 6 | 45.75
1 | 1 | 7 | 209.67
1 | 1 | 8 | 379.55
1 | 1 | 9 | 532.14
1 | 1 | 10 | 592.07
1 | 1 | 11 | 561.49
1 | 1 | 12 | 526.07
1 | 1 | 13 | 614.53
1 | 1 | 14 | 438.59
1 | 1 | 15 | 233.01
1 | 1 | 16 | 171.04
1 | 1 | 17 | 15.62
1 | 1 | 18 | 0.0
1 | 1 | 19 | 0.0
1 | 1 | 20 | 0.0
1 | 1 | 21 | 0.0
1 | 1 | 22 | 0.0
1 | 1 | 23 | 0.0
2 | 1 | 0 | 0.0
2 | 1 | 1 | 0.0
2 | 1 | 2 | 0.0
2 | 1 | 3 | 0.0
2 | 1 | 4 | 0.0
2 | 1 | 5 | 0.0
2 | 1 | 6 | 28.64
2 | 1 | 7 | 202.95
2 | 1 | 8 | 379.65
2 | 1 | 9 | 431.73
2 | 1 | 10 | 627.61
2 | 1 | 11 | 668.23
2 | 1 | 12 | 544.52
2 | 1 | 13 | 563.96
2 | 1 | 14 | 443.55
2 | 1 | 15 | 310.26
2 | 1 | 16 | 166.1
2 | 1 | 17 | 15.5
2 | 1 | 18 | 0.0
2 | 1 | 19 | 0.0
2 | 1 | 20 | 0.0
2 | 1 | 21 | 0.0
2 | 1 | 22 | 0.0
2 | 1 | 23 | 0.0
3 | 1 | 0 | 0.0
3 | 1 | 1 | 0.0
3 | 1 | 2 | 0.0
3 | 1 | 3 | 0.0
3 | 1 | 4 | 0.0
3 | 1 | 5 | 0.0
3 | 1 | 6 | 44.3
3 | 1 | 7 | 224.91
3 | 1 | 8 | 391.4
3 | 1 | 9 | 513.51
3 | 1 | 10 | 601.64
3 | 1 | 11 | 670.34
3 | 1 | 12 | 668.19
3 | 1 | 13 | 559.69
3 | 1 | 14 | 282.64
3 | 1 | 15 | 331.55
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
