touhidsiddiqueeraj-bit/artemis-helios/Code/Python/results/artemis_timing_real.csv

parse_ms | calc_ms | pwm_ms | ina_ms | tx_ms | tick_ms
0.079667 | 0.021653 | 0.019903 | 8.517208 | 0.601722 | 9.240153
0.079667 | 0.021653 | 0.019903 | 8.517167 | 0.596681 | 9.235069
0.079667 | 0.021653 | 0.019903 | 8.517125 | 0.600542 | 9.238889
0.079667 | 0.022833 | 0.019903 | 8.517111 | 0.602792 | 9.242306
0.079667 | 0.021653 | 0.019903 | 8.517153 | 0.596722 | 9.235097
0.079667 | 0.021653 | 0.019903 | 8.517194 | 0.596639 | 9.235056
0.079667 | 0.021653 | 0.019903 | 8.517111 | 0.601764 | 9.240097
0.080931 | 0.021653 | 0.019903 | 8.517111 | 0.604208 | 9.243806
0.079667 | 0.021653 | 0.019903 | 8.517194 | 0.596653 | 9.235069
0.080931 | 0.021653 | 0.019903 | 8.517111 | 0.596722 | 9.236319
0.079667 | 0.021653 | 0.019903 | 8.517167 | 0.600542 | 9.238931
0.079667 | 0.021653 | 0.019903 | 8.517208 | 0.600542 | 9.238972
0.079667 | 0.021653 | 0.019903 | 8.517194 | 0.596681 | 9.235097
0.079667 | 0.021653 | 0.019903 | 8.517111 | 0.604125 | 9.242458
0.079667 | 0.021653 | 0.019903 | 8.517194 | 0.601875 | 9.240292
0.079667 | 0.021653 | 0.019903 | 8.517167 | 0.600514 | 9.238903
0.079667 | 0.021653 | 0.019903 | 8.517208 | 0.595458 | 9.233889
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
