touhidsiddiqueeraj-bit/artemis-helios/Code/Python/results/artemis_timing_synth_backup.csv

ina219_read_ms | uart_parse_ms | vspo_compute_ms | blend_ms | pwm_update_ms | uart_tx_ms | full_artemis_tick_ms | loop_period_ms
8.486349 | 0.023475 | 0.017277 | 0.005596 | 0.001030 | 2.630775 | 11.247081 | 100.006637
8.512994 | 0.024010 | 0.018221 | 0.006863 | 0.000815 | 2.610261 | 11.277038 | 100.012701
8.606659 | 0.025237 | 0.011414 | 0.007366 | 0.000788 | 2.610537 | 11.351393 | 100.004783
8.307819 | 0.021873 | 0.020248 | 0.006989 | 0.000622 | 2.609670 | 11.019849 | 100.014368
8.579670 | 0.020957 | 0.017822 | 0.005243 | 0.000926 | 2.580550 | 11.278159 | 99.965015
8.380325 | 0.020453 | 0.012721 | 0.006898 | 0.000846 | 2.594414 | 11.104252 | 99.960000
8.601513 | 0.028116 | 0.019576 | 0.005143 | 0.000836 | 2.627800 | 11.372351 | 99.960000
8.598832 | 0.026344 | 0.019885 | 0.005653 | 0.000836 | 2.617887 | 11.308578 | 99.963100
8.600896 | 0.020209 | 0.020576 | 0.006965 | 0.000890 | 2.588488 | 11.299482 | 99.997905
8.591642 | 0.024854 | 0.017816 | 0.006239 | 0.000569 | 2.612579 | 11.301431 | 99.992341
8.571832 | 0.017628 | 0.018886 | 0.007853 | 0.000675 | 2.602658 | 11.268623 | 99.984977
8.443440 | 0.024352 | 0.015605 | 0.006840 | 0.000769 | 2.615326 | 11.188352 | 100.012970
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
