touhidsiddiqueeraj-bit/artemis-helios/Code/Python/results/final_model_metrics.csv

r2_all | mae_all | rmse_all | r2_day | mae_day | rmse_day
0.9296 | 33.17 | 53.33 | 0.8346 | 54.68 | 72.57
