touhidsiddiqueeraj-bit/artemis-helios/Figures/figures_python/FIG9/output/fig9_validation.png

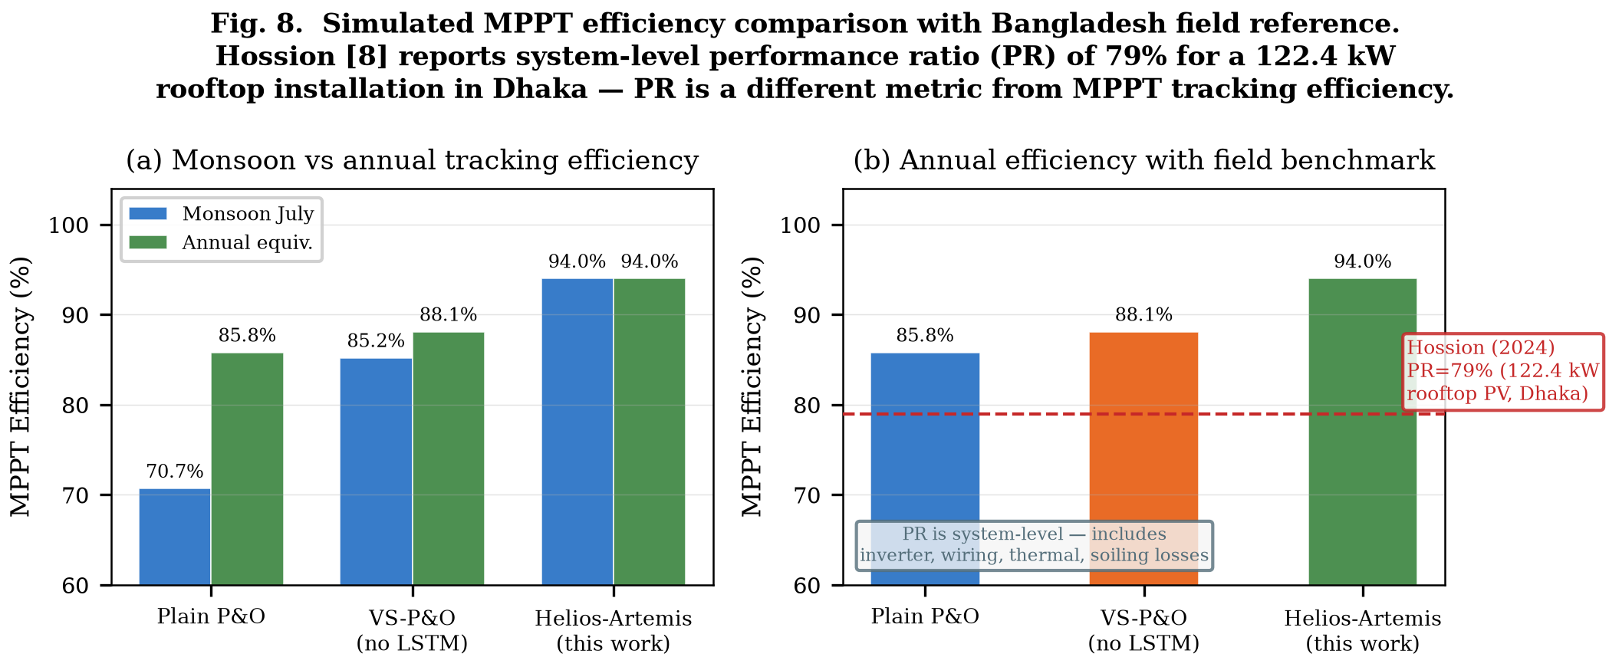
Figures/figures_python/FIG9/output/fig9_validation.png
