touhidsiddiqueeraj-bit/artemis-helios/Figures/figures_python/fig9_validation.png

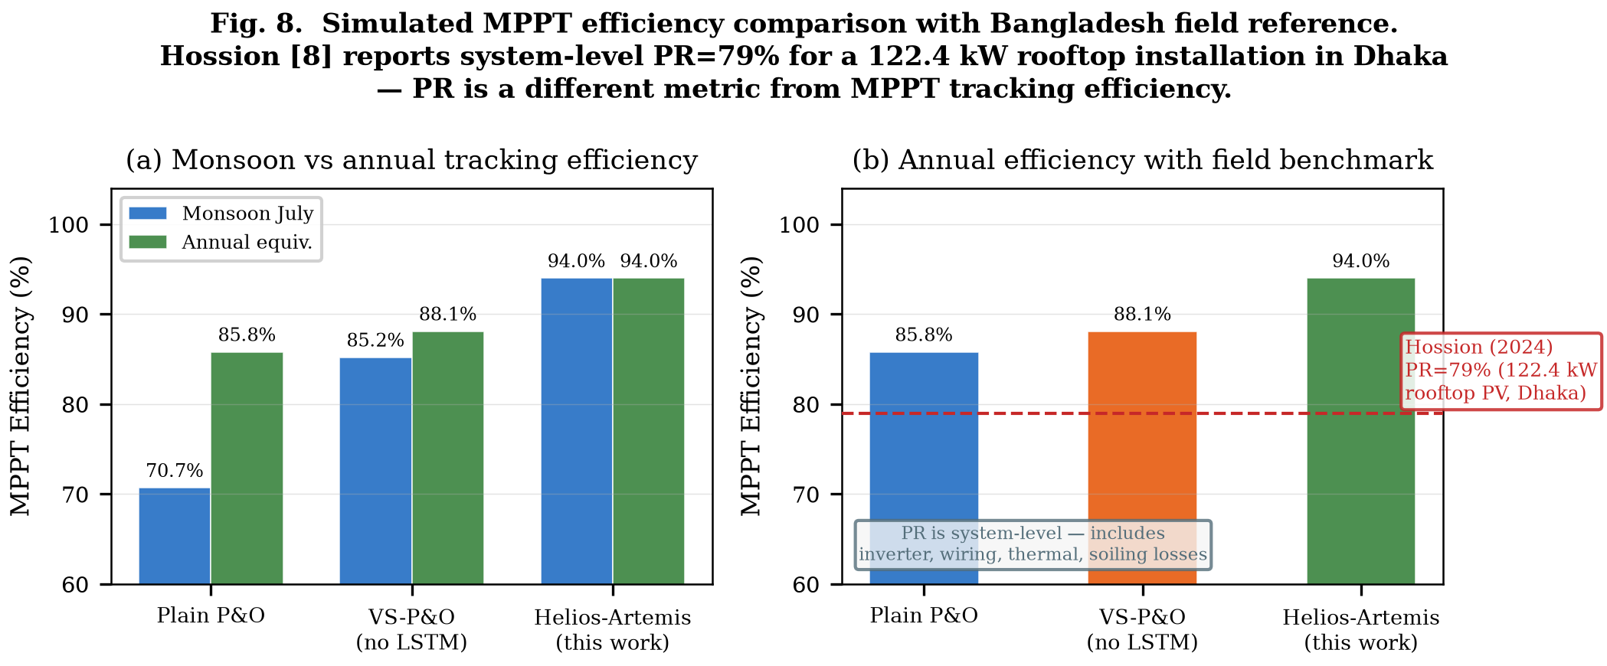
Figures/figures_python/fig9_validation.png
