touhidsiddiqueeraj-bit/artemis-helios/prototype/schematics/helios_artemis.kicad_sch

## KiCad design prototype/schematics/helios_artemis.kicad_sch (2026-05-19)

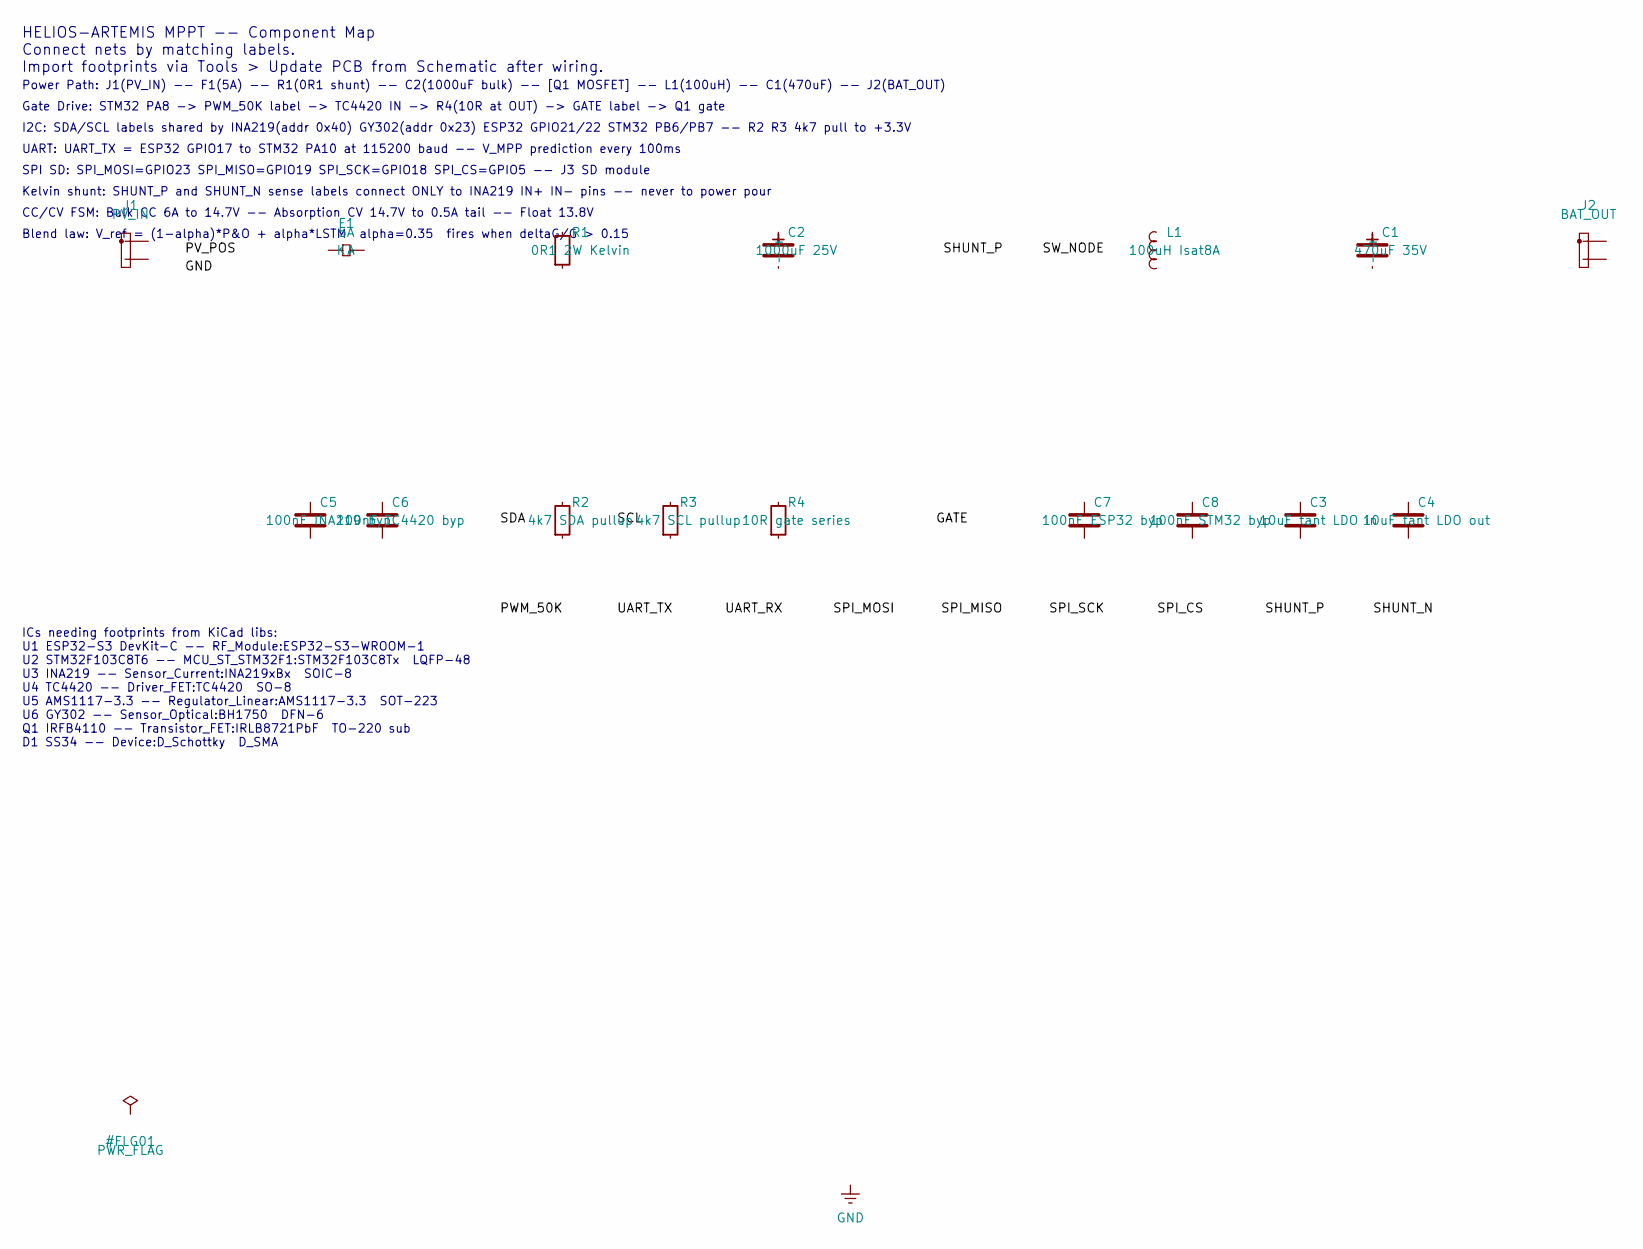
[picture p88: schematic helios_artemis.kicad_sch]

Parts:
C1: 470uF 35V; CP_Radial_D10.0mm_P5.00mm
C2: 1000uF 25V; CP_Radial_D12.5mm_P5.00mm
C3: 10uF tant LDO in; C_1206_3216Metric
C4: 10uF tant LDO out; C_1206_3216Metric
C5: 100nF INA219 byp; C_0603_1608Metric
C6: 100nF TC4420 byp; C_0603_1608Metric
C7: 100nF ESP32 byp; C_0603_1608Metric
C8: 100nF STM32 byp; C_0603_1608Metric
F1: 5A; Fuse_1812_4532Metric
J1: PV_IN; PinHeader_1x02_P5.08mm_Vertical
J2: BAT_OUT; PinHeader_1x02_P5.08mm_Vertical
L1: 100uH Isat8A; L_Radial_D8.0mm_P5.08mm
R1: 0R1 2W Kelvin; R_Axial_DIN0207_L6.3mm_D2.5mm_P10.16mm_Horizontal
R2: 4k7 SDA pullup; R_0603_1608Metric
R3: 4k7 SCL pullup; R_0603_1608Metric
R4: 10R gate series; R_0603_1608Metric

Notes on the sheet:
HELIOS-ARTEMIS MPPT -- Component Map Connect nets by matching labels. Import footprints via Tools > Update PCB from Schematic after wiring.
Power Path: J1(PV_IN) -- F1(5A) -- R1(0R1 shunt) -- C2(1000uF bulk) -- [Q1 MOSFET] -- L1(100uH) -- C1(470uF) -- J2(BAT_OUT)
Gate Drive: STM32 PA8 -> PWM_50K label -> TC4420 IN -> R4(10R at OUT) -> GATE label -> Q1 gate
I2C: SDA/SCL labels shared by INA219(addr 0x40) GY302(addr 0x23) ESP32 GPIO21/22 STM32 PB6/PB7 -- R2 R3 4k7 pull to +3.3V
UART: UART_TX = ESP32 GPIO17 to STM32 PA10 at 115200 baud -- V_MPP prediction every 100ms
SPI SD: SPI_MOSI=GPIO23 SPI_MISO=GPIO19 SPI_SCK=GPIO18 SPI_CS=GPIO5 -- J3 SD module
Kelvin shunt: SHUNT_P and SHUNT_N sense labels connect ONLY to INA219 IN+ IN- pins -- never to power pour
CC/CV FSM: Bulk CC 6A to 14.7V -- Absorption CV 14.7V to 0.5A tail -- Float 13.8V
Blend law: V_ref = (1-alpha)*P&O + alpha*LSTM alpha=0.35 fires when deltaG/G > 0.15
ICs needing footprints from KiCad libs: U1 ESP32-S3 DevKit-C -- RF_Module:ESP32-S3-WROOM-1 U2 STM32F103C8T6 -- MCU_ST_STM32F1:STM32F103C8Tx LQFP-48 U3 INA219 -- Sensor_Current:INA219xBx SOIC-8 U4 TC4420 -- Driver_FET:TC4420 SO-8 U5 AMS1117-3.3 -- Regulator_Linear:AMS1117-3.3 SOT-223 U6 GY302 -- Sen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
