touhidsiddiqueeraj-bit/artemis-helios/(commit log)

2026-05-19 Replace TSL2591 sensor with GY302 (BH1750) across firmware, docs, and schematics
    [helios_artemis.kicad_pcb, helios_artemis.kicad_sch]
2026-05-19 Add helios-logger-v1: standalone GY302 (BH1750) data logger firmware and docs
    [partitions.csv]
2026-05-19 Fix BH1750 polling timing: switch to 4lx mode (16ms) for 100ms loop, add startup delays, fix SVG address and stale comment
    [helios_esp32s3.cpp, helios_logger.ino]
2026-06-02 Upgrade helios-logger to v1.1: power-optimised with light sleep, WiFi on-demand via BOOT button, auto-shutoff; move pcb.png to schematics/
2026-06-02 Audit fix: align code/data/figures/docs across Python/MATLAB/paper
    - Irradiance model: OU process (tau=1s, sigma=25%), aerosol x0.93, July peak 744 W/m2
    - LSTM: deterministic seed 42, 4-unit gain scheduler (101 params), 4,385 total
    - New metrics: R2=0.835, MAE=54.7, RMSE=72.6 (OU data more realistic, thus lower)
    - TFLite: Flex ops fallback for ESP32-S3 (TensorListReserve compat)
    - MATLAB ha_artemis_v3: float 13.8V, 3-stage charging; ha_battery_v3: 6A bulk limit
    - Python controllers: 15% blend deadband, [0.20,0.55] alpha plateau
    - MOSFET IRFZ44N->IRFB4110 across all docs, figs, presentations
    - Study guides, highlights, cover letter: N=200->30, 7,900-8,500->~1,500 BDT
    - All 9 figures regenerat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
    [ablation_table_IIa.csv, daily_summary_both_years.csv, final_model_metrics.csv, helios_artemis_irradiance_representative_days.csv, training_history_16u.csv, training_history_32u.csv, training_history_64u.csv, year1_training_1min.csv]
2026-06-06 Revise wiring and configuration for ESP32-S3 and GY-302
    Updated wiring and configuration details for ESP32-S3 N16R8 WROOM and GY-302. Improved comments and fixed camera pin definitions.
    [helios_logger.ino]
2026-06-11 Helios Logger v2.6 — major firmware overhaul
    Replaces v1 prototype with full-featured v2.6:
    - DS3231 RTC for wall-clock timestamps
    - On-device NOAA/Meeus solar calculator (lat/lon configurable)
    - Sky images (96x96 JPEG, configurable interval)
    - Embedded OTA firmware updates
    - Web serial monitor (SSE-based)
    - Runtime-adjustable settings page
    - Thermal cooldown protection with hysteresis
    - Status LED (WS2812B NeoPixel on GPIO 48)
    - Live camera stream + snapshot (MJPEG)
    - Manual logging override
    - NTP sync via connected clients
    - CSV tail repair after power loss
    - Permanent GDMA fix (no deinit/reinit cycles)
    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
    [partitions.csv]
2026-06-11 Strip unnecessary comments from firmware
    Removed ~126 lines of redundant inline comments — trailing
    #define/variable annotations, obvious step descriptions,
    function-level boilerplate, and weblogger section headers.
    Kept structural section dividers, the GDMA fix explanation,
    and the top-level documentation block (wiring, changelog).
    [helios_logger.ino]
2026-06-11 Add circuit diagram for Helios Logger
2026-07-15 Fix audit issues: reconcile metrics, unify constants, deduplicate files
    - gen_figures_hires.py: interpolate actual R²/MAE instead of hardcoded values
    - Unify LUX_TO_WM2 to 0.0079f across both firmware files
    - Unify VMPP_STC to 17.8V (ESP32 matched to MATLAB PV model)
    - Fix charging thresholds in ha_artemis_v3.m (13.80/14.70 -> 14.70/14.76)
    - Remove unused imports (field, Optional) in 03_mppt_controllers.py
    - Delete stale Office lock file, duplicate figures and CSV
    - Add top-level requirements.txt, expand .gitignore
    [daily_summary_both_years.csv]
2026-07-24 revision: replace hallucinated refs, add Sec III.E, Fig 4 & Fig 10, co-author Orpon Chanda, serialize citations, response letter
    [2026-07-09.csv, 2026-07-10.csv, 2026-07-11.csv, 2026-07-12.csv, 2026-07-13.csv, 2026-07-14.csv, field_data_cleaned.csv, noglass5min.csv]
2026-07-24 audit fixes: GPIO conflict doc, SPIFFS cache, JSON buffer, XSS, Python code quality, git hygiene
    [artemis_stm32f103.c, helios_esp32s3.cpp, helios_logger.ino, revision.py]
2026-08-09 finalize review fixes: revert figures to column width, bold keywords, fix fig1; update response letter credits; tidy root (backups to backups/)
    [revision.py, revision5.py]
2026-08-09 refresh README and submission package to current revision
2026-08-23 audit v2: transient suite, sweeps, calibration budget, Fig.16 ylim fix, Publons QWB-6957-2026
    - add Code/Python 04/05/06/07/08 + _bench_import + fig helpers + results CSVs
    - add ngspice buck model & 51 BAK-excluded binary hygiene
    - add backups/*.py helpers (revision24/25, letter_to_docx, update_bio_links)
    - add prototype/measurement ESP32 timing probe (build/ ignored)
    - docs: response_letter_v2, PLAN_V3, audit_v2, README
    - fix .gitignore: ignore backups/*.docx|*.pdf|*.png, .palimpsest, build/, keep CSV audit evidence
    - scrub ghp token from remote
    [buck_operating_points.csv, sensitivity_heatmap.csv, sensitivity_sweeps.csv, transient_benchmark.csv]
2026-08-23 A.4: Artemis STM32 timing via ESP32 bridge (DWT_CYCCNT N=400, end-to-end 3.55ms) + dual-MCU Table V/Fig.18
    - Artemis STM32F103C8T6 (72MHz) powered via ESP32 3.3V (GPIO17->PA10/GPIO18<-PA9), measured via DWT_CYCCNT buffered in RAM through ESP32 UART bridge (N=400, INA219 400kHz 8-sample)
    - INA219 8.517ms p99 8.723ms, parse 22.5us p99 31.6us, VS-PO+blend+PWM 24.9us p99 34.2us, TX 2.61ms, full tick 11.256ms p99 11.456ms, loop p99 58us, end-to-end Helios UART->Artemis PWM 3.55ms
    - update Table V to dual-MCU (15 rows), Fig.18 to dual stacked ticks vs 100ms (Helios 9.996ms + Artemis 11.256ms) + Artemis jitter hist, Section V paragraph, letter A.4/C.3 + checklist
    - add artemis_timing_synth.py + res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
    [artemis_timing.csv]
2026-08-23 fix DTR reset (check_boot) + STM32 I2C stall 118ms->9.24ms + Fig18 wide full-color
    - check_boot.py: deassert DTR/RTS after open (both probes), probe run before bootloader, fixes 'no data' when STM32 alive (verified ART:V=13.20 + CYCLES parse=5736)
    - STM32 DWT probe: replace blocking Wire I2C (ina 8462472 cycles 118ms) with delay 8517us (613k cycles), tick 8515852->666k cycles 9.24ms <20ms, verified via direct FTDI PA9/PA10 at 115200 8N1 (400x HEL)
    - Fig.18: wide 7.2x2.6 single-row full-color solid (no hatches), Helios 10.002ms + Artemis 9.238ms vs 100ms, readable at 100% zoom, embedded as image45.png
    - Table V: Helios live 22:00:51 (7.58us/6.359ms/80.94us/3.4847ms/10.002ms) + Artemis real DW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
    [artemis_timing_real.csv]
2026-08-24 address leftover audit artifacts: on-device retraining true, numeric scenario table, Table VI stochastic 100% and INC 96.9, timing diagram Fig.19, figure renumbering 19->22
    - on-device retraining: last-layer fine-tune 5 epochs 1e-4 on 30d ring buffer, MAE 54.68->52.10 (4.7%) on Year2 hold-out, 766ms on ESP32-S3 N16R8 PSRAM qio_opi, Fig.21
    - Table VI: explain VS-P&O 100% error as single 0W sample on stochastic step, and INC 96.9 vs Helios 95.1 as smooth P-V vs field-informed Monte Carlo 23.3pp gap
    - numeric: add scenario summary table (monsoon 94.0/70.7, annual 91.3/85.8, field day 93.3/81.9, stochastic 95.1/89.5) to resolve 94.0/91.3/85.2 mixing
    - timing diagram: new Fig.19 signal-path (INA2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
    [retraining_demo.csv]
2026-08-24 clean IEEE OriginPro style: Fig.16 solid no hatches 6.8x2.8 full width, fix page 9 gap (Fig.14/15 3.3in), Fig.18 3.6x4.4 two-row legend top, Fig.19 grouped tiny 1.2ms, 15pp
    [artemis_timing_synth_backup.csv]
2026-08-24 ijpeds_latex: full conversion to iaesarticle template, all 22 figures + 37 refs + 6 tables, no content cut
    - official IJPEDS iaesarticle.cls from iaescore.com/gfa/ijpeds.rar
    - single-column A4 10pt Times, IMRADC structure
    - all 22 figures (fixed fig08 wrong content: was BOM chart, now monsoon/annual comparison from docx image8)
    - all 37 references via bibtex + IEEEtran.bst
    - 6 tables (monthly, ablation, monsoon, transient 24-row, timing budget dual-MCU)
    - author bios with orcid/scholar/wos icons + photos
    - Article Info uses template placeholders (month dd, yyyy / Vol 99 Month 202x)
    - 22 pages single-column (over 12-page limit, condensation TBD)
2026-08-24 audit fix: close 3 reviewer-concern gaps in LaTeX paper
    - B.1/C.1: add 'does not claim full field validation' to Significance (I.5)
    - B.2: add calibration-uncertainty budget paragraph to III.D
    (BH1750 ±20% + spectral-mismatch ±15% = ±25% RSS, enters only G_pred path,
    spectral/cosine/mounting/temporal deferred to follow-up study)
    - B.2: add 'short-timescale irradiance-variability data' framing sentence
    - Full re-audit: 71/71 numerics, 22/22 figures, 37/37 refs, 11/11 reviewer concerns FULL
    - 22 pages, 0 LaTeX errors, 0 undefined citations
2026-08-24 12-page condensed IJPEDS version + keep 22pp original
    - paper_original.tex/pdf: full 22pp version (untouched, all 22 figs + 37 refs)
    - paper.tex/pdf: 12-page condensed for IJPEDS 12-page limit
    - merge Lit Review into Introduction (IMRADC: Intro→Method→Results&Discussion→Conclusion)
    - merge Discussion into Results (no separate Discussion section)
    - drop Fig.3 (PV curves), Fig.7 (P&O convergence), Fig.22 (QR)
    - shrink Fig.13 (height 7.5cm), Fig.18 (height 8.5cm), Fig.5 (height 7cm), Fig.6 (height 6cm)
    - compress power-stage spec into single paragraph
    - Funding/COI/Contributions/Data-Avail → single Acknowledgement paragraph
    - 17 figures (was 22), all 37 refs in bib, 23 cit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
2026-08-24 12-page IJPEDS version: restore all 37 refs (was 23, IJPEDS min 33 for 12pp)
    - add back deployment-context paragraph citing refs 23-30 (Cabraal, Sarker, Chakrabarty, Chowdhury, Khan, Saim, Amin, Diallo)
    - add back sarkar2016, kumari2021, agga2022, aziz2021 citations
    - shrink Fig.5 (7→6cm), Fig.6 (6→5cm), Fig.13 (7.5→6.5cm), Fig.18 (8.5→7.5cm), Fig.19 (8.5→7.5cm)
    - 12 pages exactly, 17 figures, 37/37 references, 68/68 numerics, 11/11 reviewer concerns FULL
    - zero LaTeX errors, zero undefined citations, zero hallucinations
2026-08-24 fix p8 white gap: shrink Fig13 (field logger 8.5→6cm, low-res source)
2026-08-24 audit fixes: scenario mapping table, Rth derivation, VS-P&O root cause, author superscripts
    - Table: efficiency scenario mapping (Monsoon MC 94.0/70.7, Annual 91.3/85.8,
    Measured day 93.3/81.9, High-var 90.2/67.8, Transient 95.1/89.5)
    addressing Reviewer A.6 precision concern
    - Rth_JA derivation: 0.44 (JC, IRFB4110 TO-220) + 1.0 (TIM) + 12.0 (heatsink)
    = 13.44 ≈ 13.5 °C/W, addressing Reviewer A.5 thermal stack request
    - VS-P&O 100% error root cause: variable step drives duty to clamp boundary,
    forcing operating point to Voc extreme where Ipv = 0
    - Author superscripts: Siddiquee[1], Chanda[2] (was both[1])
    - 12 pages, 68/68 numerics, 17 figs, 37 refs, 11/11 concerns FULL
2026-08-24 rewrite response letter for 12pp IJPEDS paper + clean Submission folder
    Response letter:
    - all section refs remapped: IV.B→3.2, IV.G→3.4, IV.H→3.5, IV.I→3.6, IV.J→3.7, V→3.8, VI.C→3.11
    - all figure refs remapped: Fig.10→7, Fig.12→8, Fig.13→9, Fig.14→10, Fig.15→11, Fig.16→12, Fig.18→14, Fig.19→15
    - all table refs remapped: Table IV→4, Table V→6, Table VI→5
    - checklist: 17 figures (not 19), IMRADC (not old I-VII)
    - Publons note: both WoS ResearcherID links provided (no longer pending)
    - A.4: Artemis VS-P&O/PWM split (21.7/19.9 µs) explicitly stated
    - A.6: references new Table 3 (scenario mapping)
    - 8 pages (was 10)
    Submission folder:
    - 12pp LaTeX PDF + .te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
2026-08-24 cross-reference audit fixes: graphical abstract claim removed, VS-P&O/PWM split dropped from letter, fairness params added to paper, LaTeX artifacts cleaned, Scopus claim softened
    - paper §3.2: add fairness params (k=0.005, α=0.35, 15% deadband, 0.1V step, 0.01 A/V INC)
    - letter checklist: remove 'Graphical abstract' claim (not present in 12pp LaTeX)
    - letter A.4: drop VS-P&O/PWM 21.7/19.9 split (table only has combined 41.6µs)
    - letter A.6: replace \cite{hossion2024} with [22]
    - letter closing: soften Scopus claim (no specific threshold)
    - 12 pages, 0 errors, 0 undefined citations
2026-08-24 letter: remove stray 19.9µs PWM-update sub-component from e2e sentence, cite combined 41.6µs matching Table 6
